DefeatedWarrior/OpenTheatreComms-Beltpack/cad/out/kicad/main_pcb_drawing.png

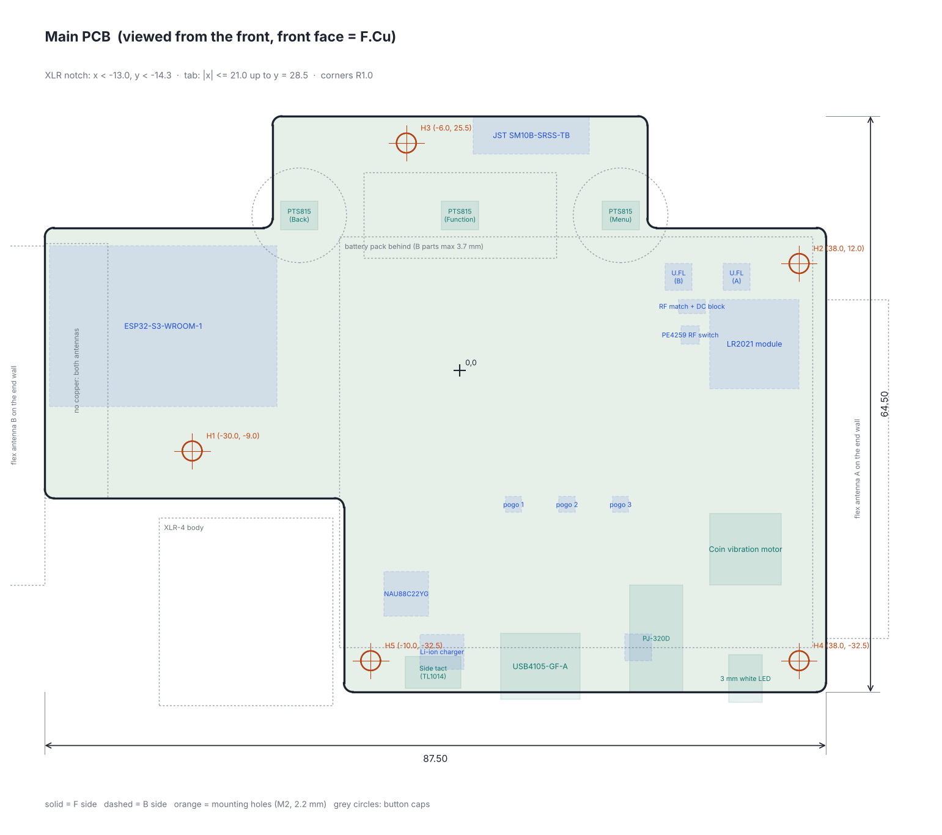
cad/out/kicad/main_pcb_drawing.png
