DefeatedWarrior/OpenTheatreComms-Beltpack/cad/out/kicad/pack_lid_pcb_drawing.png

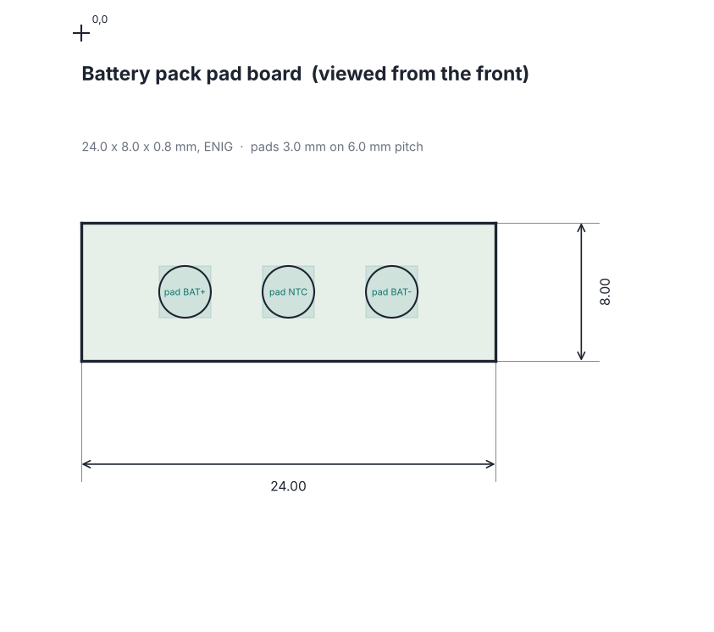
cad/out/kicad/pack_lid_pcb_drawing.png
