DefeatedWarrior/OpenTheatreComms-Beltpack/cad/out/kicad/section_centre.png

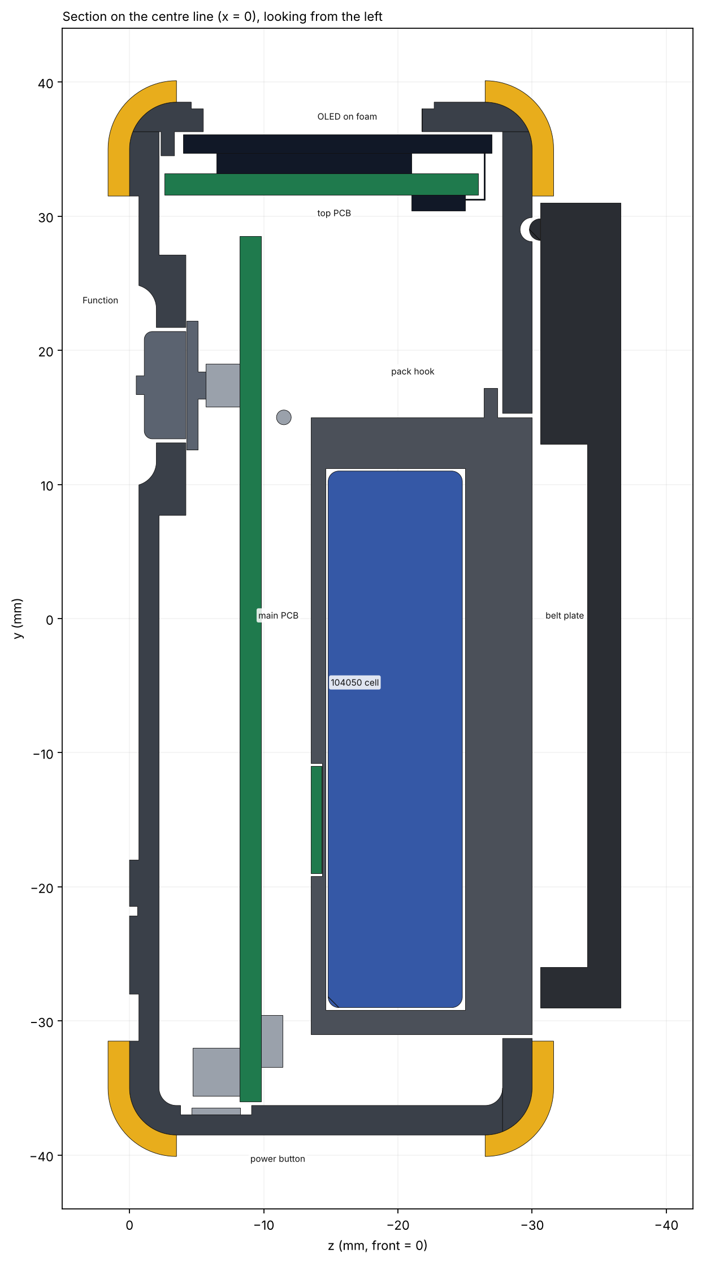
cad/out/kicad/section_centre.png
