DefeatedWarrior/OpenTheatreComms-Beltpack/cad/out/kicad/section_dial.png

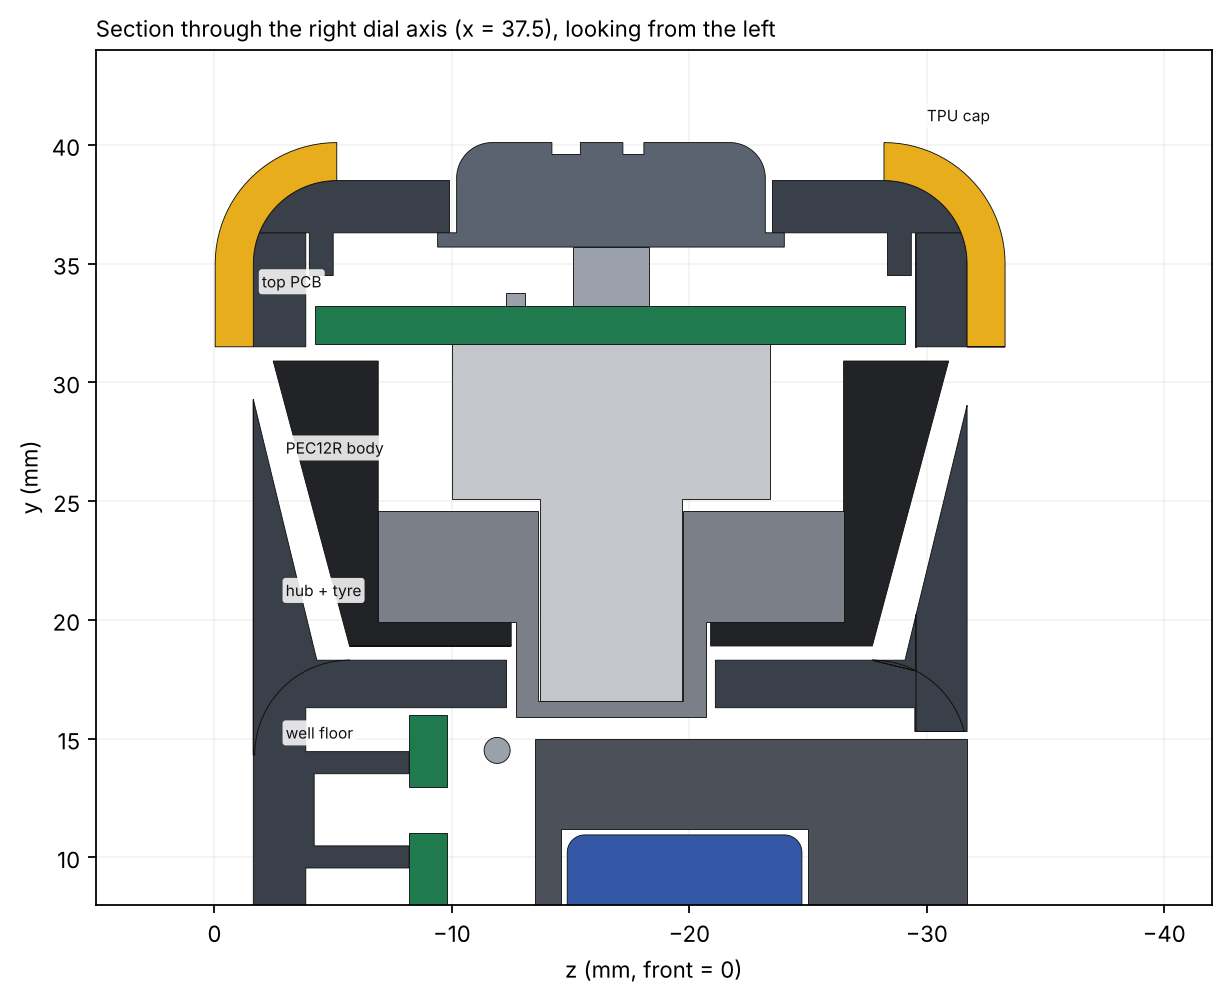
cad/out/kicad/section_dial.png
