DefeatedWarrior/OpenTheatreComms-Beltpack/cad/out/kicad/top_pcb_drawing.png

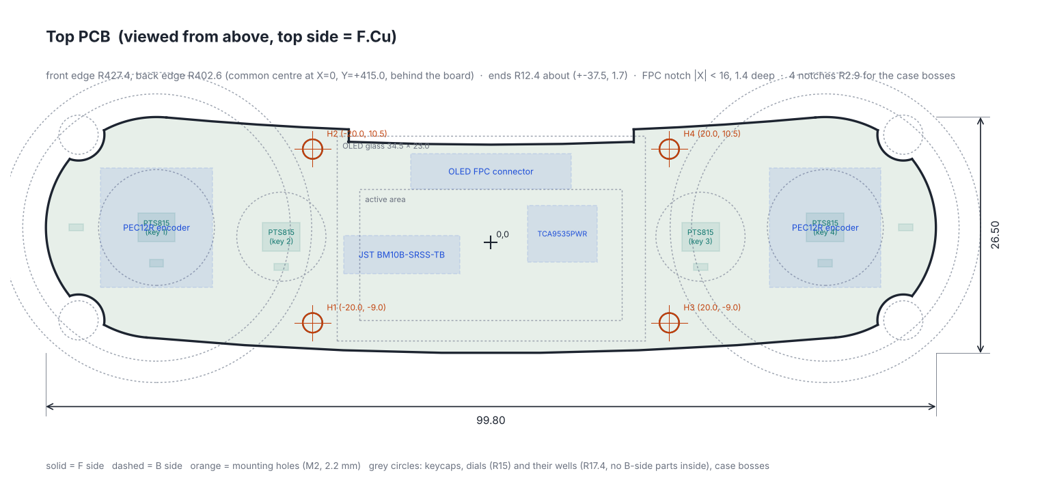
cad/out/kicad/top_pcb_drawing.png
