DefeatedWarrior/OpenTheatreComms-Beltpack/kicad/dock_contact_pcb/fab/dock_contact_pcb_back.png

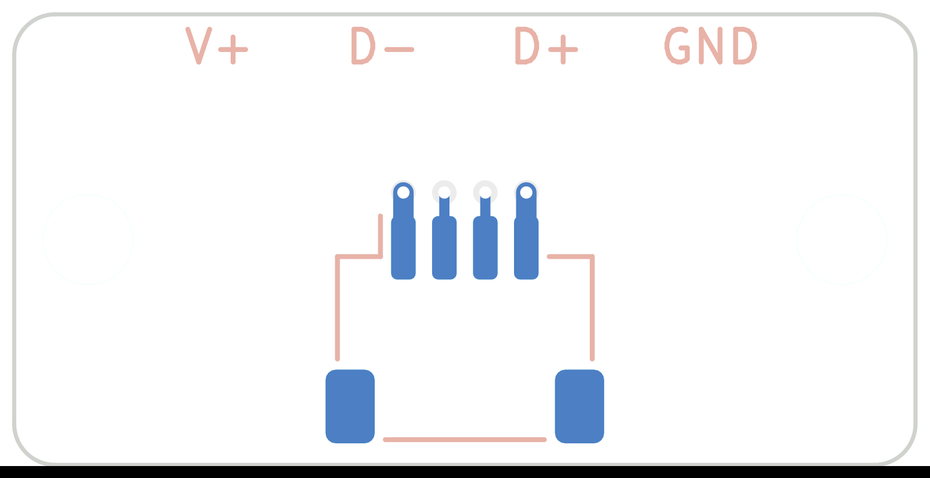
kicad/dock_contact_pcb/fab/dock_contact_pcb_back.png
