DefeatedWarrior/OpenTheatreComms-Beltpack/kicad/top_pcb/fab/top_pcb_preview.png

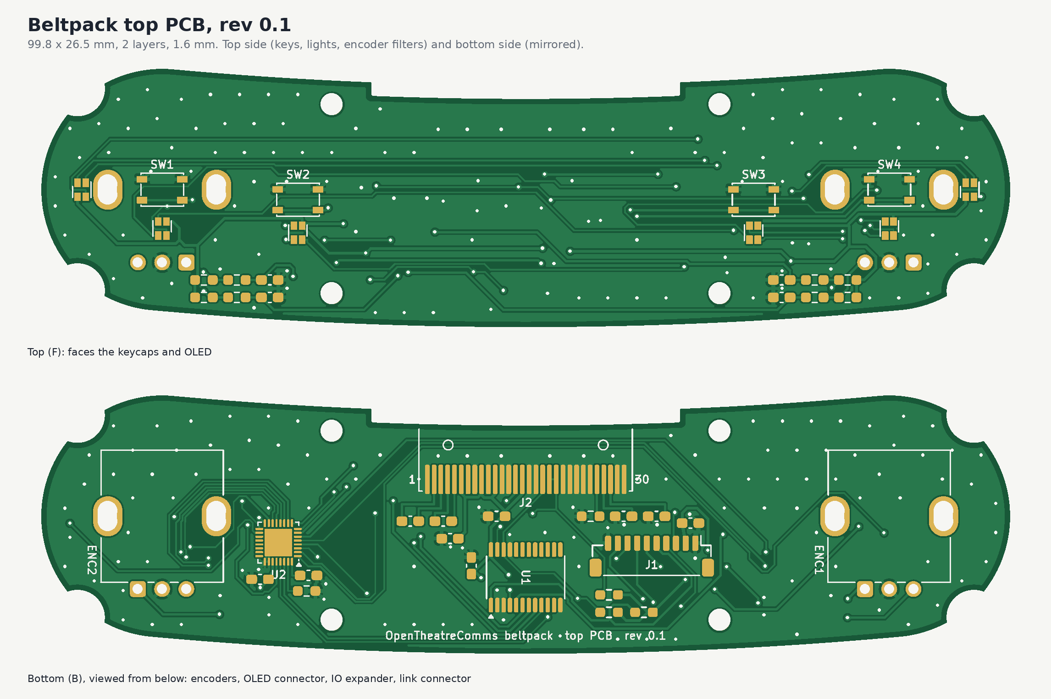
kicad/top_pcb/fab/top_pcb_preview.png
