DefeatedWarrior/OpenTheatreComms-Beltpack/renders/r_back.png

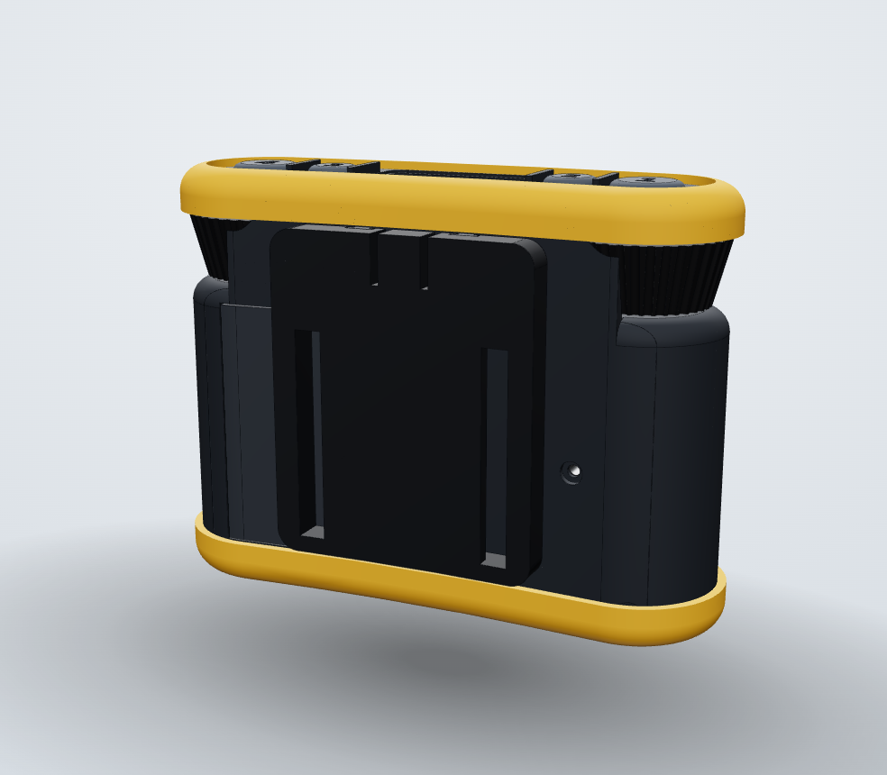
renders/r_back.png
