DefeatedWarrior/OpenTheatreComms-Beltpack/renders/r_bottom.png

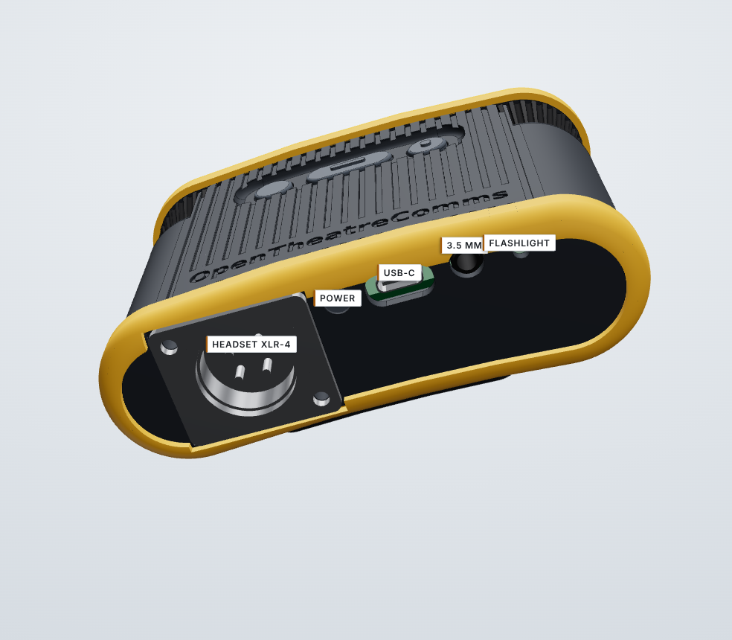
renders/r_bottom.png
