DefeatedWarrior/OpenTheatreComms-Beltpack/renders/r_exploded.png

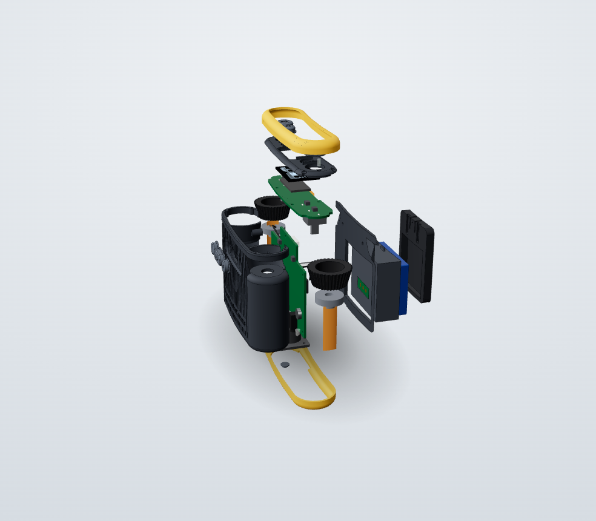
renders/r_exploded.png
