DefeatedWarrior/OpenTheatreComms-Beltpack/renders/r_ghost.png

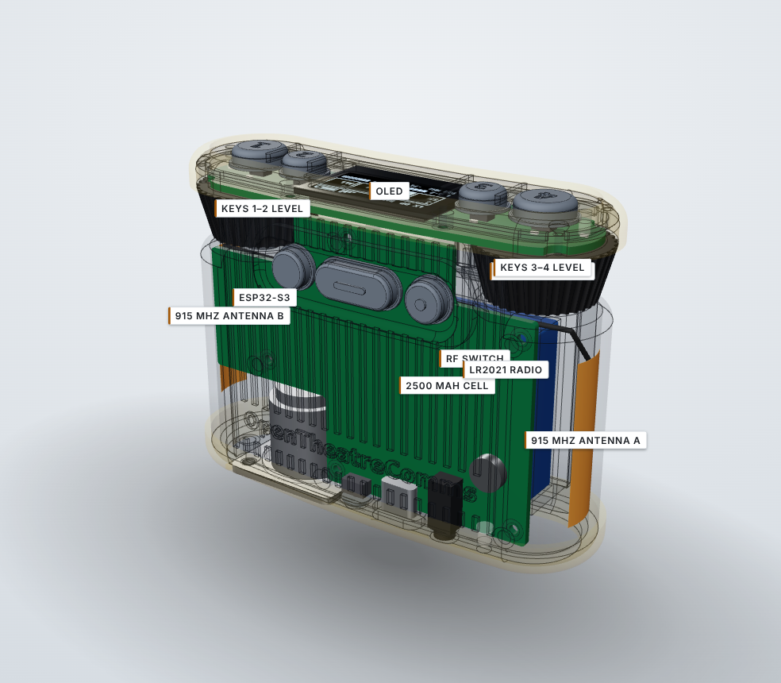
renders/r_ghost.png
