DefeatedWarrior/OpenTheatreComms-Beltpack/renders/r_hero.png

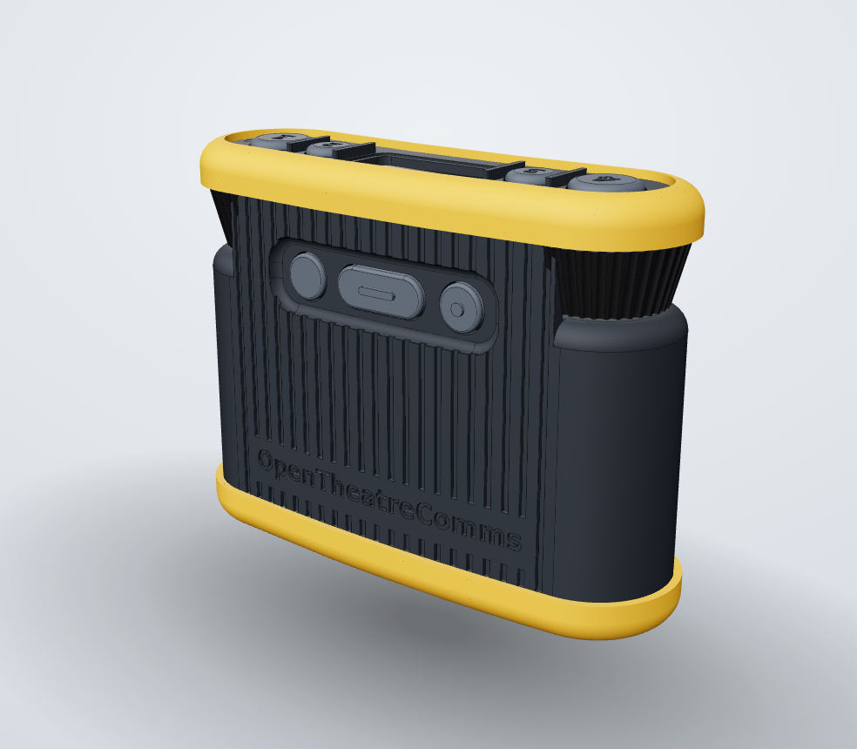
renders/r_hero.png
