DefeatedWarrior/OpenTheatreComms-Beltpack/renders/r_int_back.png

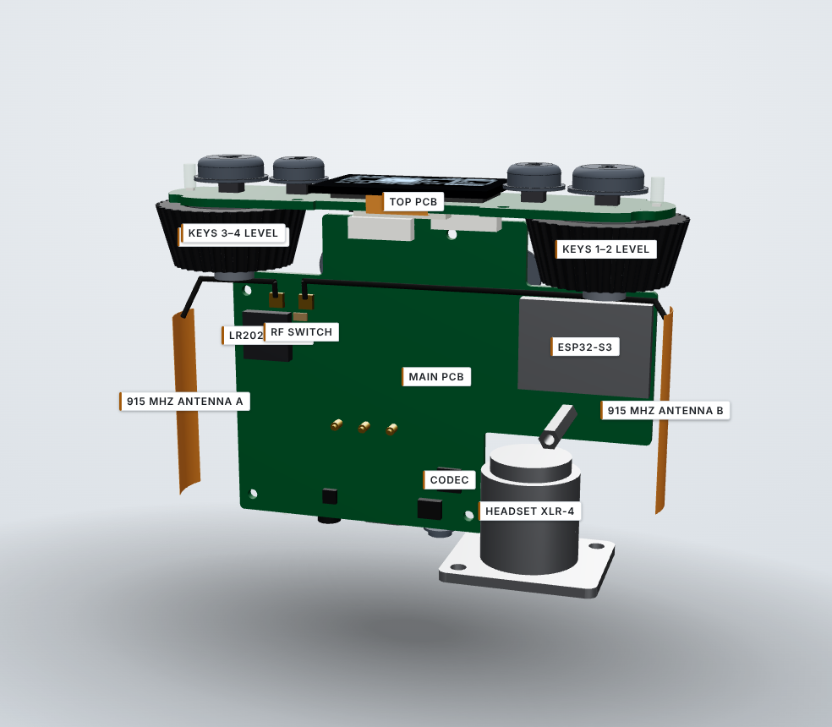
renders/r_int_back.png
