DefeatedWarrior/OpenTheatreComms-Beltpack/renders/r_int_front.png

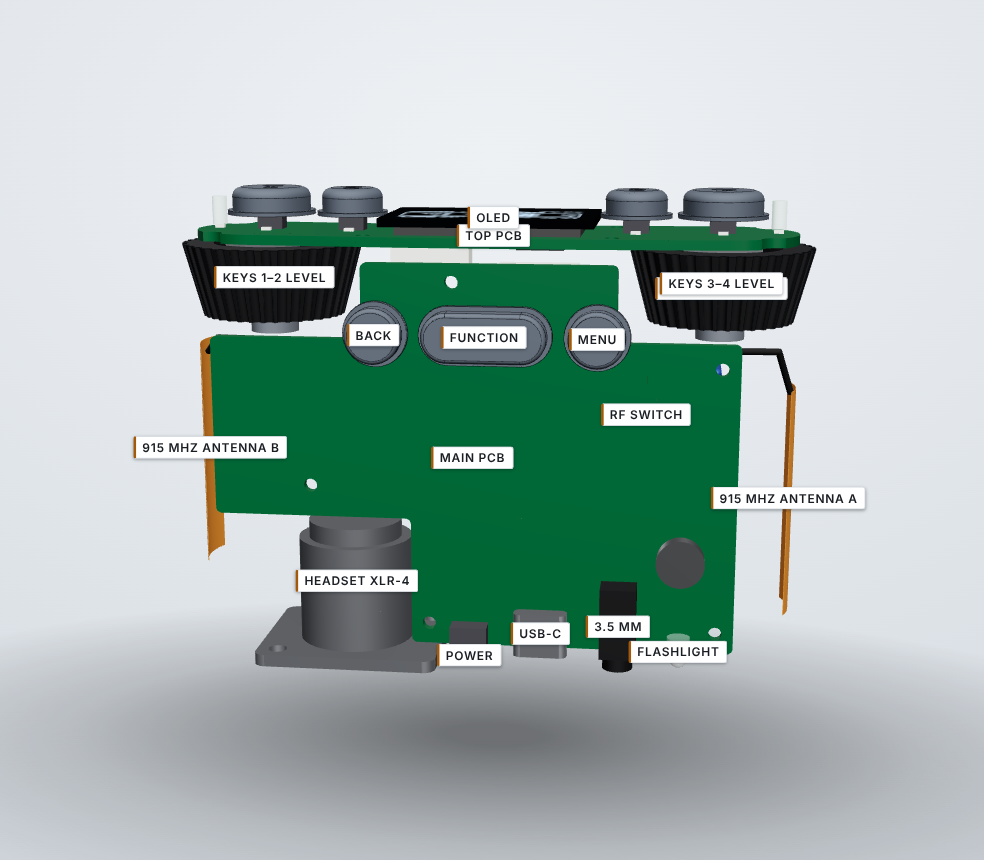
renders/r_int_front.png
