DefeatedWarrior/OpenTheatreComms-Beltpack/renders/r_wearer.png

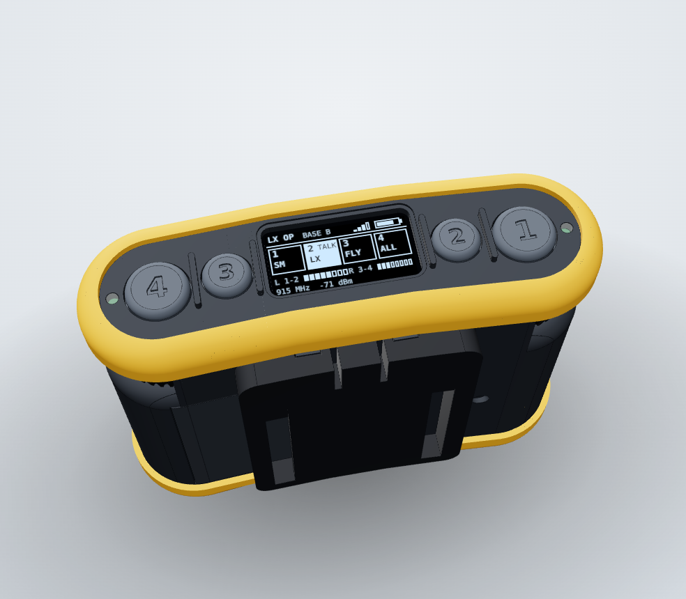
renders/r_wearer.png
