DefeatedWarrior/OpenTheatreComms-Beltpack/kicad/top_pcb/fab/top_pcb_bom.csv

Qty | References | Value | Footprint | Part | Side | Notes
1 | C1 | 100n | C_0603_1608Metric_Pad1.08x0.95mm_HandSolder | 0603 X7R 50 V | bottom | U1 decoupling
4 | C2 C3 C13 C14 | 1u | C_0603_1608Metric_Pad1.08x0.95mm_HandSolder | 0603 X5R | bottom
2 | C4 C5 | 4.7u | C_0603_1608Metric_Pad1.08x0.95mm_HandSolder | 0603 X5R 25 V | bottom
1 | C6 | 4.7u | C_0603_1608Metric_Pad1.08x0.95mm_HandSolder | 0603 X5R 10 V | bottom | Charge-pump supply (VBAT pin)
1 | C7 | 1u | C_0603_1608Metric_Pad1.08x0.95mm_HandSolder | 0603 X5R 10 V | bottom | Logic supply (VDD pin)
4 | C8 C9 C10 C11 | 10n | C_0603_1608Metric_Pad1.08x0.95mm_HandSolder | 0603 X7R 50 V | top
1 | C12 | 10u | C_0603_1608Metric_Pad1.08x0.95mm_HandSolder | 0603 X5R 10 V | bottom | Bulk at the link connector, wired straight to its pins 1 and 2
6 | D1 D2 D3 D4 D5 D6 | RGB | LED_LiteOn_LTST-C19HE1WT | Lite-On LTST-C19HE1WT | top
2 | ENC1 ENC2 | PEC12R | RotaryEncoder_Bourns_Vertical_PEC12R-3x17F-Nxxxx | Alps EC11N1520402 | bottom
1 | J1 | Main PCB link | JST_SH_BM10B-SRSS-TB_1x10-1MP_P1.00mm_Vertical | JST BM10B-SRSS-TB | bottom | JST SH 10-way top entry; 50 mm cable to SM10B on the main PCB tab
1 | J2 | OLED tail | OLED_Tail_30P_0.7mm_Solder | OLED panel tail soldered to pads (no part) | bottom | Solder pads for the panel's 30-lead tail (0.7 mm pitch). Standard 1.3 in SH1106 30-pin pin map; I2C (BS2..0 = 010), address 0x3D (SA0 = D/C# high: 0x3C is the LP5024 broadcast)
1 | R1 | 15k | R_0603_1608Metric_Pad0.98x0.95mm_HandSolder | 0603 1% | bottom | LP5024 full-scale current, 4.9 mA
9 | R9 R13 R14 R15 R16 R17 R18 R19 R20 | 10k | R_0603_1608Metric_Pad0.98x0.95mm_HandSolder | 0603 1% | bottom/top
2 | R10 R11 | 4.7k | R_0603_1608Metric_Pad0.98x0.95mm_HandSolder | 0603 1% | bottom
1 | R12 | 560k | R_0603_1608Metric_Pad0.98x0.95mm_HandSolder | 0603 1% | bottom | Segment current reference: 560k per the panel reference circuit (12.5 uA max)
4 | SW1 SW2 SW3 SW4 | PTS815 | SW_SPST_PTS810 | C&K PTS815 SJM 250 SMTR LFS | top
1 | U1 | TCA9555PWR | TSSOP-24_4.4x7.8mm_P0.65mm | TI TCA9555PWR | bottom | 16-bit I2C IO expander, 0x20, internal 100k pull-ups
1 | U2 | LP5024RSMR | VQFN-32-1EP_4x4mm_P0.4mm_EP2.8x2.8mm | TI LP5024RSMR | bottom | 24-channel I2C RGB LED driver, 0x28: six RGB LEDs; EN from the expander (P05, high by its pull-up at power-up)
