DefeatedWarrior/OpenTheatreComms-Beltpack/kicad/base_pcb/fab/base_pcb_bom.csv

Qty | References | Value | Footprint | Part | Side | Notes
1 | C1 | 10u | C_1206_3216Metric_Pad1.33x1.80mm_HandSolder | 1206 X7R 50 V | top
17 | C2 C11 C15 C19 C25 C26 C27 C28 C29 C30 C31 C32 C33 C34 C35 C36 C37 | 100n | C_0603_1608Metric_Pad1.08x0.95mm_HandSolder | 0603 X7R | top
4 | C3 C4 C5 C8 | 22u | C_1206_3216Metric_Pad1.33x1.80mm_HandSolder | 1206 X5R 10 V | top
1 | C6 | 1u | C_0603_1608Metric_Pad1.08x0.95mm_HandSolder | 0603 X5R 10 V | top
3 | C7 C10 C20 | 10u | C_0603_1608Metric_Pad1.08x0.95mm_HandSolder | 0603 X5R 10 V | top
1 | C9 | 47u | C_1206_3216Metric_Pad1.33x1.80mm_HandSolder | 1206 X5R 6.3 V | top | Module bulk (guide: 47u + 10u + 100n)
0 | C12 C13 C18 C41 C42 C50 C51 | DNP DNP | C_0603_1608Metric_Pad1.08x0.95mm_HandSolder | 0603 C0G, tune | top | Not fitted.
3 | C14 C16 C17 | 100p | C_0603_1608Metric_Pad1.08x0.95mm_HandSolder | 0603 C0G 50 V | top
2 | C21 C22 | 10n | C_0603_1608Metric_Pad1.08x0.95mm_HandSolder | 0603 X7R | top
0 | C38 C47 | DNP 47u | C_1206_3216Metric_Pad1.33x1.80mm_HandSolder | 1206 X5R 6.3 V | top | Not fitted.
0 | C39 C48 | DNP 10u | C_0603_1608Metric_Pad1.08x0.95mm_HandSolder | 0603 X5R 10 V | top | Not fitted.
0 | C40 C49 | DNP 100n | C_0603_1608Metric_Pad1.08x0.95mm_HandSolder | 0603 X7R | top | Not fitted.
0 | C43 C52 | DNP 100p | C_0603_1608Metric_Pad1.08x0.95mm_HandSolder | 0603 C0G 50 V | top | Not fitted.
2 | D1 D2 | SS34 | D_SMA | SS34 (SMA) | top
1 | D3 | SMAJ26A | D_SMA | SMAJ26A | top | Input surge clamp
1 | D4 | green | LED_0603_1608Metric_Pad1.05x0.95mm_HandSolder | Lite-On LTST-C191KGKT | top | Power light
1 | ENC1 | EC11 | RotaryEncoder_Alps_EC11E-Switch_Vertical_H20mm | EC11 encoder with push switch, 20 mm shaft | top | Menu dial
1 | FB1 | 0R | L_0603_1608Metric_Pad1.05x0.95mm_HandSolder | 0603 0R (or Murata BLM18PG121SN1D) | top | Radio supply link: the module has its own ferrite
0 | FB2 FB3 | DNP 0R | L_0603_1608Metric_Pad1.05x0.95mm_HandSolder | 0603 0R (or Murata BLM18PG121SN1D) | top | Not fitted.
1 | J1 | DC 7-24 V | BarrelJack_CUI_PJ-063AH_Horizontal | CUI PJ-063AH (5.5 x 2.1 mm, centre +) | top | DC input, 7-24 V, centre positive. Optional: the NANO's USB-C or a PoE module also powers the station
1 | J2 | Antenna A | SMA_Molex_73251-2120_EdgeMount_Horizontal | Molex 73251-2120 SMA edge-mount jack, 1.6 mm board | top | Antenna A (915 MHz whip)
1 | J3 | Antenna B | SMA_Molex_73251-2120_EdgeMount_Horizontal | Molex 73251-2120 SMA edge-mount jack, 1.6 mm board | top | Antenna B (915 MHz whip)
0 | J4 | DNP 2.4 GHz | U.FL_Hirose_U.FL-R-SMT-1_Vertical | Hirose U.FL-R-SMT-1(10) | top | Not fitted. 2.4 GHz fallback antenna: footprint only in v1
1 | J5 | OLED | PinSocket_1x04_P2.54mm_Vertical | 1x4 female socket for a 1.3 in 128x64 I2C OLED module (SH1106, address 0x3C) | top | OLED module socket: GND, VCC, SCL, SDA (check your module's pin order)
0 | J6 | DNP Radio 2 antenna | SMA_Molex_73251-2120_EdgeMount_Horizontal | Molex 73251-2120 SMA edge-mount jack, 1.6 mm board | top | Not fitted. Radio 2 antenna (915 MHz whip)
0 | J7 | DNP Radio 3 antenna | SMA_Molex_73251-2120_EdgeMount_Horizontal | Molex 73251-2120 SMA edge-mount jack, 1.6 mm board | top | Not fitted. Radio 3 antenna (915 MHz whip)
1 | L1 | 4.7u | L_Bourns-SRN4018 | 4.7 uH, 2.5 A, 4x4 mm (Bourns SRN4018-4R7M or equal) | top
1 | L2 | 0 | R_0603_1608Metric_Pad0.98x0.95mm_HandSolder | 0603 0R or RF inductor | top | Pi match series element: 0R until tuned
0 | L3 L4 L6 | DNP 0 | R_0603_1608Metric_Pad0.98x0.95mm_HandSolder | 0603 0R or RF inductor | top | Not fitted.
12 | LED1 LED2 LED3 LED4 LED5 LED6 LED7 LED8 LED9 LED10 LED11 LED12 | WS2812B-Mini | LED_WS2812B-Mini-V3J_3.5x3.5mm | Worldsemi WS2812B-Mini-V3J | top
0 | R1 R2 | DNP 4.7k | R_0603_1608Metric_Pad0.98x0.95mm_HandSolder | 0603 1% | top | Not fitted.
3 | R3 R9 R10 | 1k | R_0603_1608Metric_Pad0.98x0.95mm_HandSolder | 0603 1% | top
4 | R4 R5 R6 R7 | 470 | R_0603_1608Metric_Pad0.98x0.95mm_HandSolder | 0603 1% | top
1 | R8 | 100k | R_0603_1608Metric_Pad0.98x0.95mm_HandSolder | 0603 1% | top
3 | R11 R12 R13 | 10k | R_0603_1608Metric_Pad0.98x0.95mm_HandSolder | 0603 1% | top
1 | R14 | 33 | R_0603_1608Metric_Pad0.98x0.95mm_HandSolder | 0603 1% | top | LED data series resistor
0 | R15 R16 R17 R18 R21 R22 R23 R24 | DNP 470 | R_0603_1608Metric_Pad0.98x0.95mm_HandSolder | 0603 1% | top | Not fitted.
0 | R19 R25 | DNP 100k | R_0603_1608Metric_Pad0.98x0.95mm_HandSolder | 0603 1% | top | Not fitted.
1 | SW1 | Talk 1 | SW_PUSH-12mm | 12 x 12 mm tactile switch with round cap | top | Talk 1 key (channel 1)
1 | SW2 | Talk 2 | SW_PUSH-12mm | 12 x 12 mm tactile switch with round cap | top | Talk 2 key (channel 2)
1 | SW3 | Talk 3 | SW_PUSH-12mm | 12 x 12 mm tactile switch with round cap | top | Talk 3 key (channel 3)
1 | SW4 | Talk 4 | SW_PUSH-12mm | 12 x 12 mm tactile switch with round cap | top | Talk 4 key (channel 4)
1 | SW5 | Menu | SW_PUSH_6mm | 6 x 6 mm tactile switch, 13 mm tall | top | Menu key
1 | SW6 | Back | SW_PUSH_6mm | 6 x 6 mm tactile switch, 13 mm tall | top | Back key
1 | U1 | ESP32-P4-NANO | ESP32-P4-NANO_Sockets | Waveshare ESP32-P4-NANO (SKU 29026) on 2x 2x13 2.54 mm female sockets, 8.5 mm | top | ESP32-P4 board: Ethernet (PoE module option), USB-C, Wi-Fi 6 co-processor. Plugs in RJ45-first toward the rear
1 | U2 | AP63205WU | TSOT-23-6 | Diodes AP63205WU-7 | top | 5 V, 2 A synchronous buck, 3.8-32 V in
1 | U3 | TLV75733 | SOT-23-5 | TI TLV75733PDBVR | top | 3.3 V, 1 A LDO for the radio, codec and expander (separate from the NANO's own 3.3 V)
1 | U4 | LR2021 | LR2021_Elecrow_10x10mm | Elecrow LR2021 module (LMM16121D) | top | 915-928 MHz FLRC radio; 2.4 GHz port for fallback
1 | U5 | PE4259 | SOT-363_SC-70-6 | pSemi PE4259-63 | top | Antenna diversity switch, RF1 = antenna A when CTRL is high
1 | U6 | TCA9555PWR | TSSOP-24_4.4x7.8mm_P0.65mm | TI TCA9555PWR | top | IO expander at 0x21 (A0 high): keys, encoder push, antenna switch, radios' DIO5, TX/RX enable and radios 2-3 reset
1 | U7 | 74AHCT1G125 | SOT-23-5 | 74AHCT1G125 (SOT-23-5) | top | 3.3 V to 5 V level shift for the LED data line
0 | U10 U11 | DNP LR2021 | LR2021_Elecrow_10x10mm | Elecrow LR2021 module (LMM16121D) | top | Not fitted.
