DefeatedWarrior/OpenTheatreComms-Beltpack/order/JLC order/Beltpack dock contacts/dock_contact_pcb_hand_fit.csv

Designator | Value | Part | LCSC Part # | Side | Other supplier | Note
J5 | To main J12 | JST SM04B-SRSS-TB(LF)(SN) | C160404 | bottom |  | Dock socket on the main board (J12)
