DefeatedWarrior/OpenTheatreComms-Beltpack/cad/out/kicad/main_pcb.dxf

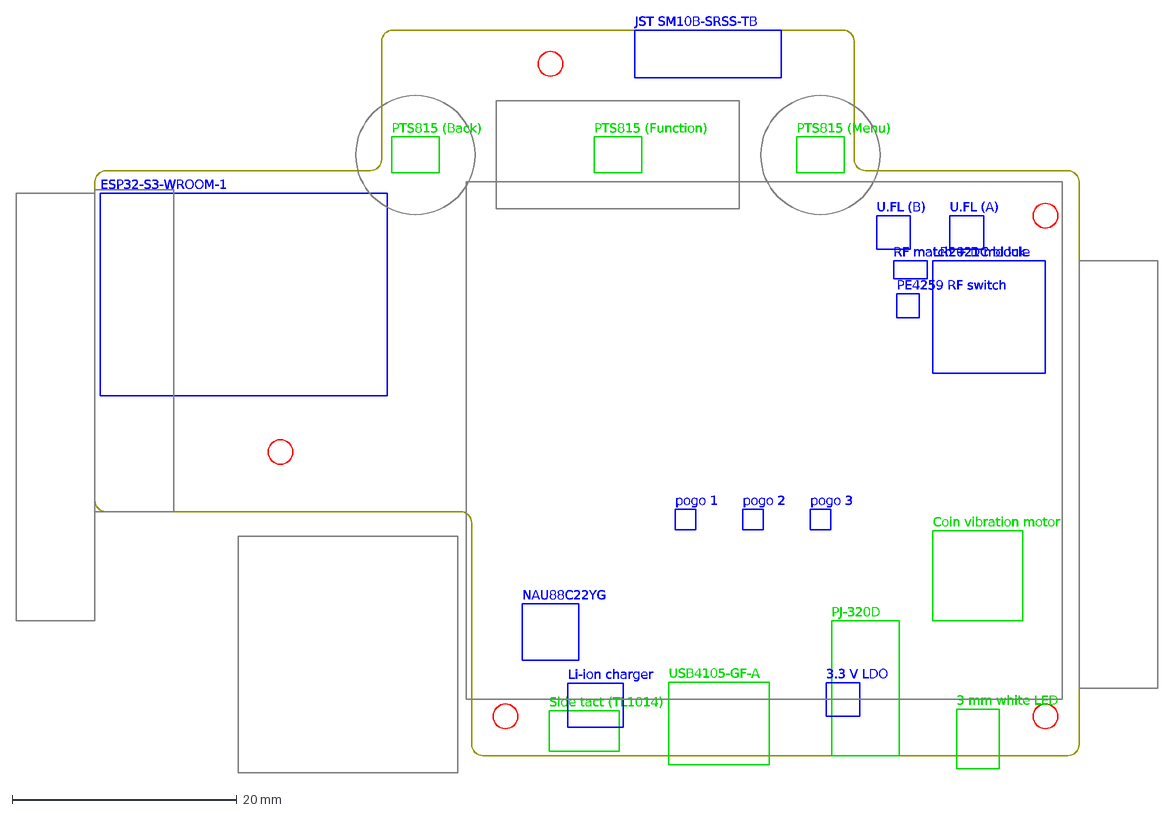
[picture p22: CAD file, 2026-10-25]
cad/out/kicad/main_pcb.dxf
PTS815 (Back)
PTS815 (Function)
PTS815 (Menu)
USB4105-GF-A
PJ-320D
Side tact (TL1014)
3 mm white LED
Coin vibration motor
ESP32-S3-WROOM-1
LR2021 module
U.FL (A)
U.FL (B)
PE4259 RF switch
RF match + DC block
NAU88C22YG
Li-ion charger
3.3 V LDO
JST SM10B-SRSS-TB
pogo 1
pogo 2
pogo 3
