DefeatedWarrior/OpenTheatreComms-Beltpack/cad/out/kicad/main_pcb_edge_cuts.dxf

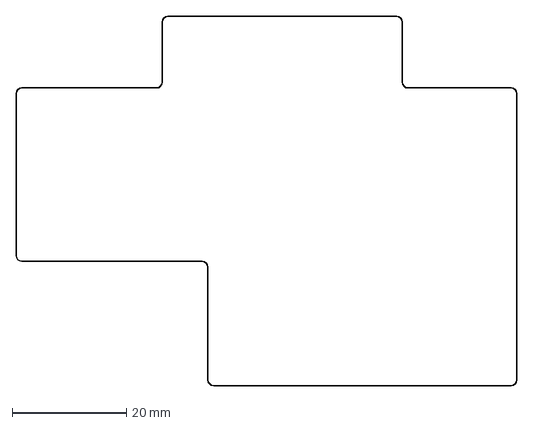
[picture p23: CAD file, 2026-10-25]
cad/out/kicad/main_pcb_edge_cuts.dxf
87.5 x 64.5 mm
