DefeatedWarrior/OpenTheatreComms-Beltpack/cad/out/beltpack_final.step

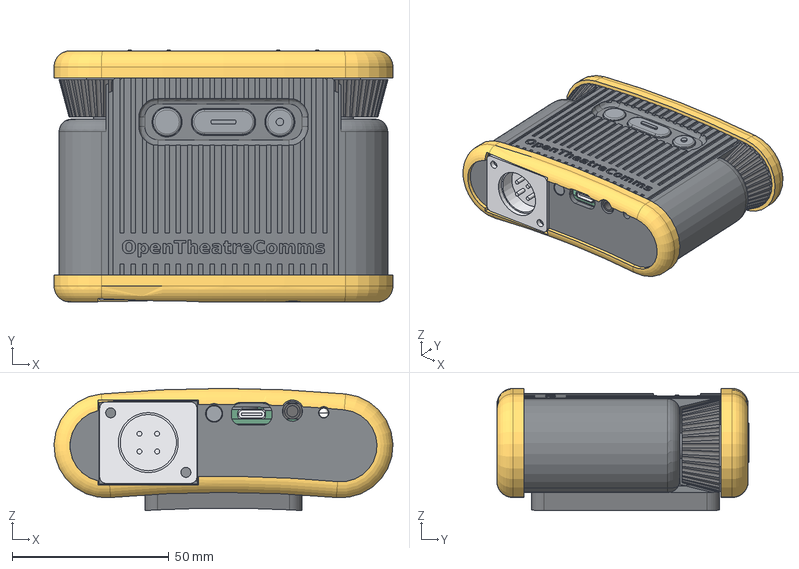
[picture p24: CAD file, 2026-10-25]
cad/out/beltpack_final.step
108.2 x 80.5 x 39.0 mm
front_shell
back_shell
top_plate
tpu_top
tpu_bottom
knob_left
hub_left
knob_right
hub_right
keycap_1
keycap_2
keycap_3
keycap_4
front_back
front_function
front_menu
power_plunger
status_pipe_L
status_pipe_R
top_pcb
sw_key1
led_key1
sw_key2
led_key2
sw_key3
led_key3
sw_key4
led_key4
led_status_L
led_status_R
oled_zif
jst_top
io_exp
enc_left
enc_right
oled_glass
oled_spacer
oled_fpc
main_pcb
sw_back
sw_function
sw_menu
usb_c
trrs
sw_power
lamp_led
vib_motor
esp32s3
lr2021
ufl
ufl_b
rf_switch
rf_match
codec
charger
ldo
jst_main
pogo_1
pogo_2
pogo_3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
