DefeatedWarrior/OpenTheatreComms-Beltpack/cad/out/kicad/top_pcb_edge_cuts.dxf

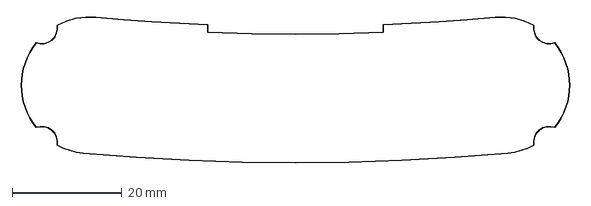
[picture p25: CAD file, 2026-10-25]
cad/out/kicad/top_pcb_edge_cuts.dxf
101.6 x 27.2 mm
