DefeatedWarrior/OpenTheatreComms-Beltpack/cad/out/stl/knob_right.stl

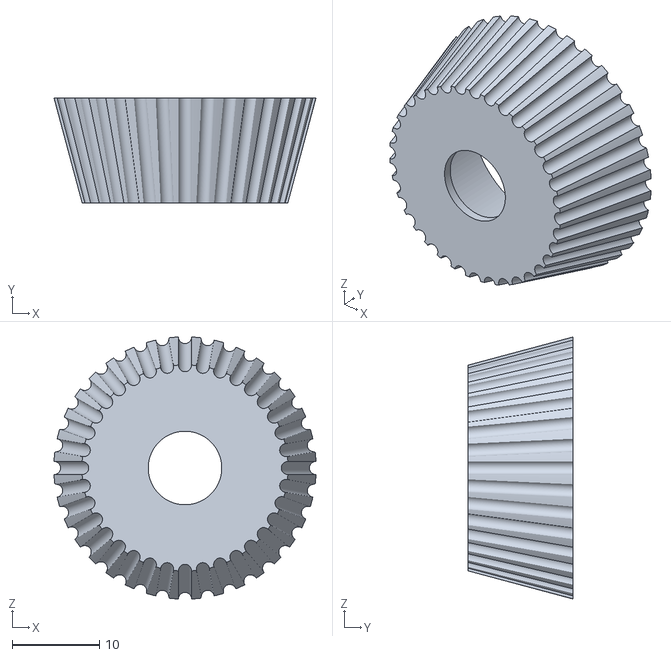
[picture p26: CAD file, 2026-10-25]
cad/out/stl/knob_right.stl
30.0 x 12.0 x 30.0
