DefeatedWarrior/OpenTheatreComms-Beltpack/kicad/3d/enclosure_ref.step

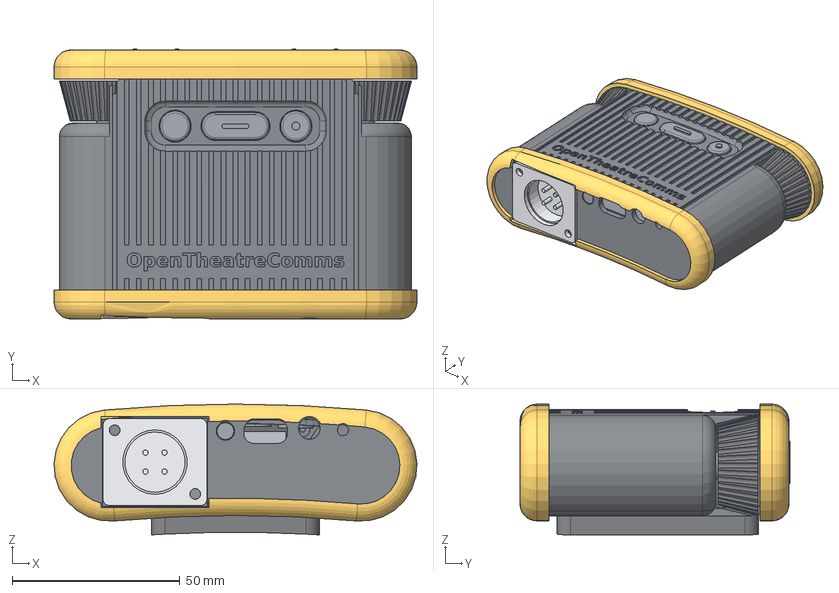
[picture p27: CAD file, 2026-10-25]
kicad/3d/enclosure_ref.step
108.2 x 80.5 x 39.0 mm
front_shell
back_shell
top_plate
tpu_top
tpu_bottom
knob_left
hub_left
knob_right
hub_right
keycap_1
keycap_2
keycap_3
keycap_4
front_back
front_function
front_menu
power_plunger
status_pipe_L
status_pipe_R
oled_glass
oled_spacer
oled_fpc
rf_switch
rf_match
standoff_H1
xlr4
battery_pack
cell
antenna
antenna_b
coax
coax_b
belt_plate
