DefeatedWarrior/OpenTheatreComms-Beltpack/cad/out/stl/battery_pack.stl

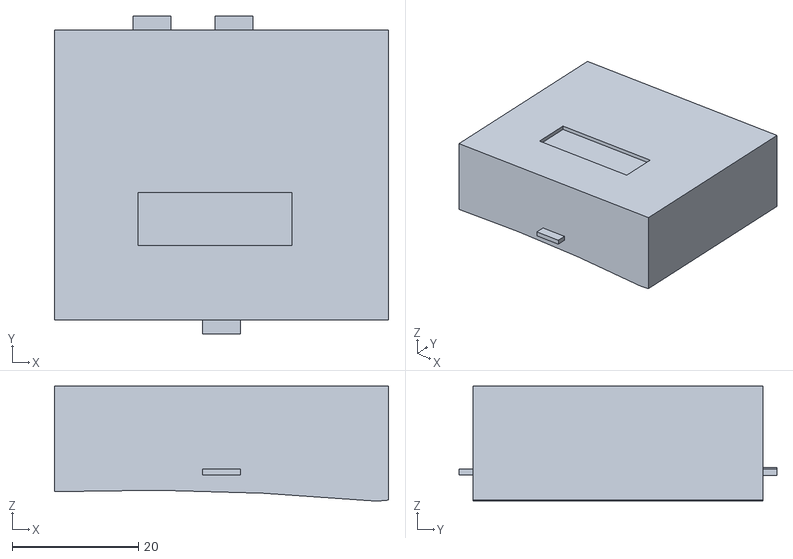
[picture p28: CAD file, 2026-10-25]
cad/out/stl/battery_pack.stl
53.0 x 50.4 x 18.2
