DefeatedWarrior/OpenTheatreComms-Beltpack/cad/out/kicad/pack_lid_pcb_edge_cuts.dxf

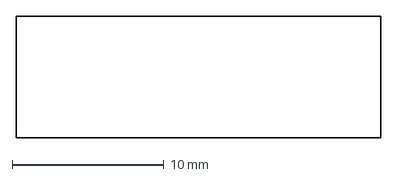
[picture p29: CAD file, 2026-10-25]
cad/out/kicad/pack_lid_pcb_edge_cuts.dxf
24.0 x 8.00 mm
