DefeatedWarrior/OpenTheatreComms-Beltpack/cad/out/stl/hub_right.stl

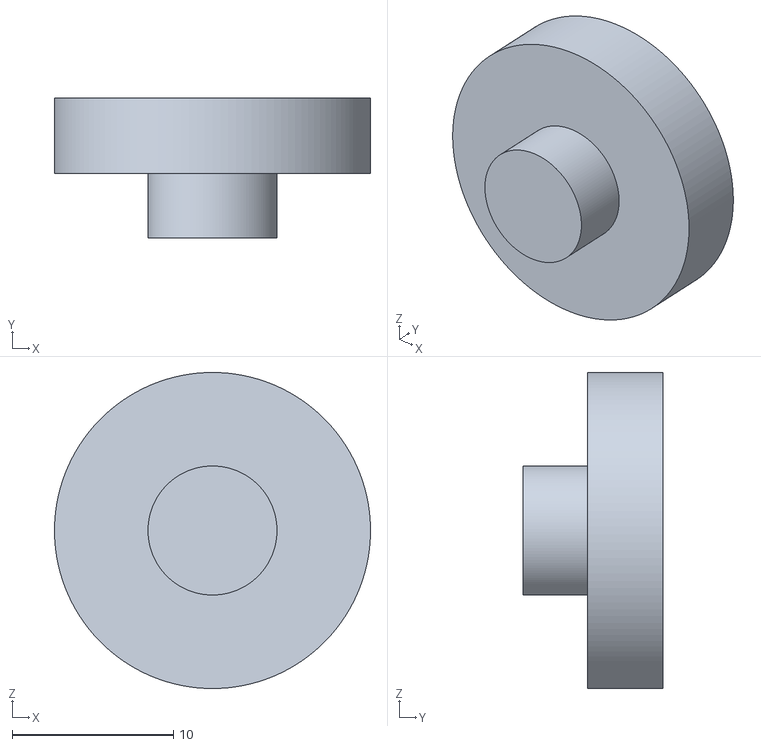
[picture p30: CAD file, 2026-10-25]
cad/out/stl/hub_right.stl
19.6 x 8.70 x 19.6
