DefeatedWarrior/OpenTheatreComms-Beltpack/cad/out/kicad/pack_lid_pcb.dxf

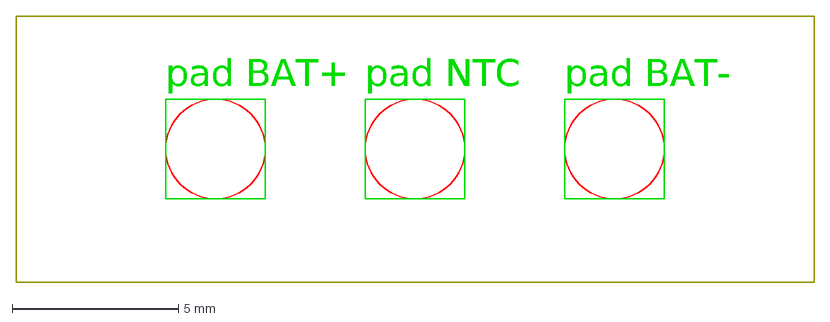
[picture p31: CAD file, 2026-10-25]
cad/out/kicad/pack_lid_pcb.dxf
pad BAT+
pad NTC
pad BAT-
