DefeatedWarrior/OpenTheatreComms-Beltpack/cad/out/stl/front_shell.stl

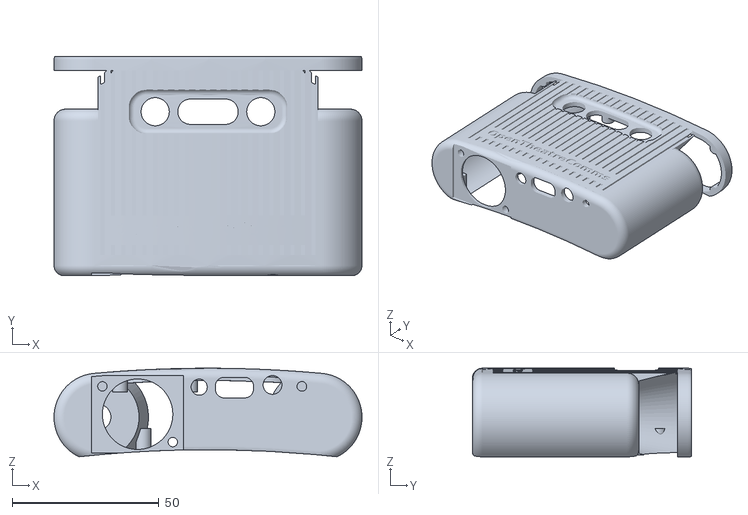
[picture p32: CAD file, 2026-10-25]
cad/out/stl/front_shell.stl
105.0 x 74.8 x 30.2
