DefeatedWarrior/OpenTheatreComms-Beltpack/cad/out/kicad/top_pcb.dxf

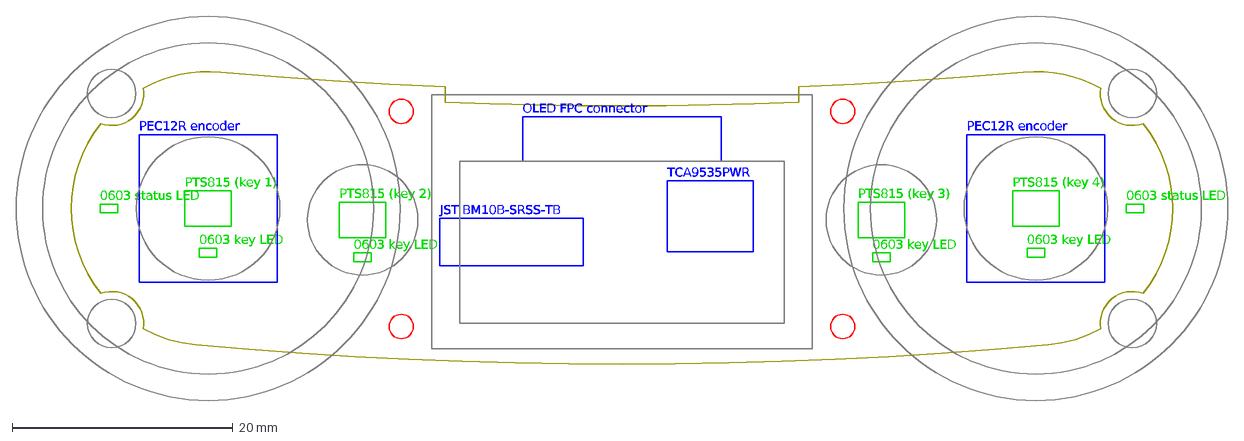
[picture p33: CAD file, 2026-10-25]
cad/out/kicad/top_pcb.dxf
PTS815 (key 1)
0603 key LED
PTS815 (key 2)
PTS815 (key 3)
PTS815 (key 4)
0603 status LED
OLED FPC connector
JST BM10B-SRSS-TB
TCA9535PWR
PEC12R encoder
