DefeatedWarrior/OpenTheatreComms-Beltpack/cad/out/stl/keycap_1.stl

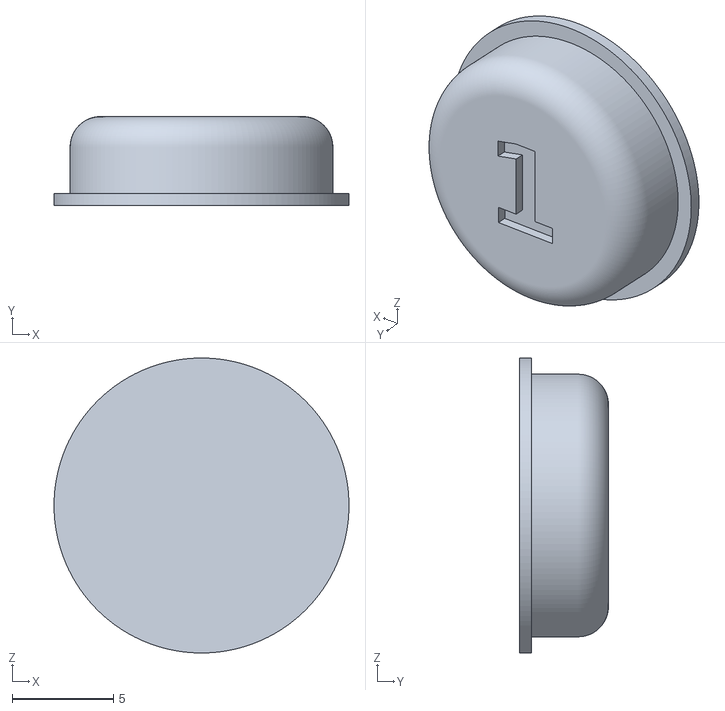
[picture p34: CAD file, 2026-10-25]
cad/out/stl/keycap_1.stl
14.6 x 4.40 x 14.6
