DefeatedWarrior/OpenTheatreComms-Beltpack/cad/out/stl/front_back.stl

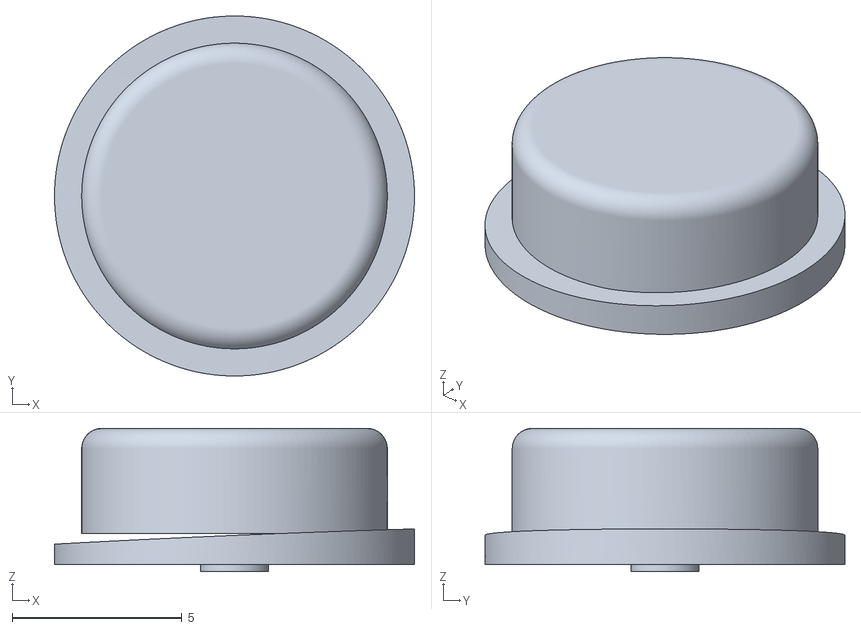
[picture p35: CAD file, 2026-10-25]
cad/out/stl/front_back.stl
10.6 x 10.6 x 4.22
