DefeatedWarrior/OpenTheatreComms-Beltpack/cad/out/stl/power_plunger.stl

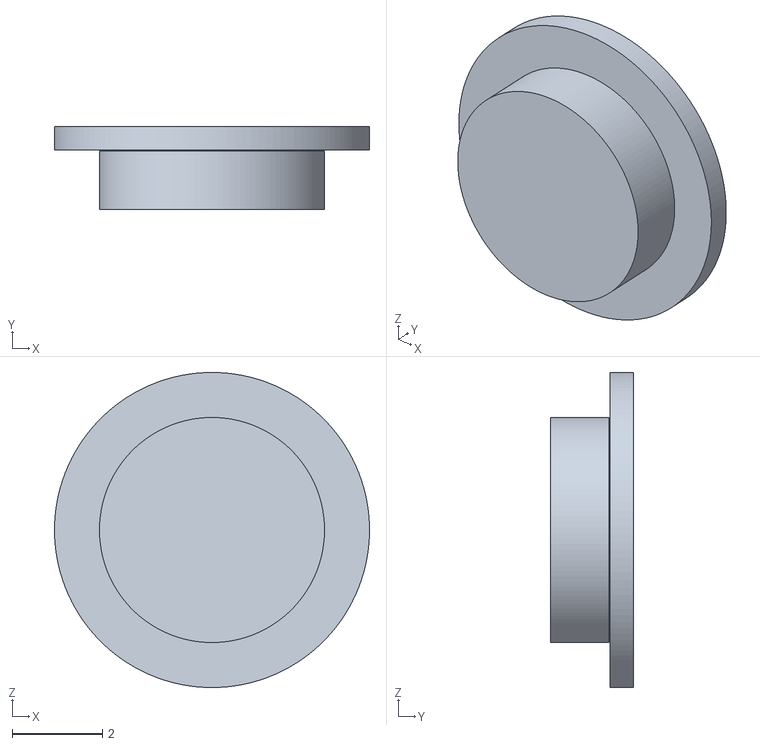
[picture p36: CAD file, 2026-10-25]
cad/out/stl/power_plunger.stl
7.00 x 1.85 x 7.00
