DefeatedWarrior/OpenTheatreComms-Beltpack/cad/out/stl/tpu_bottom.stl

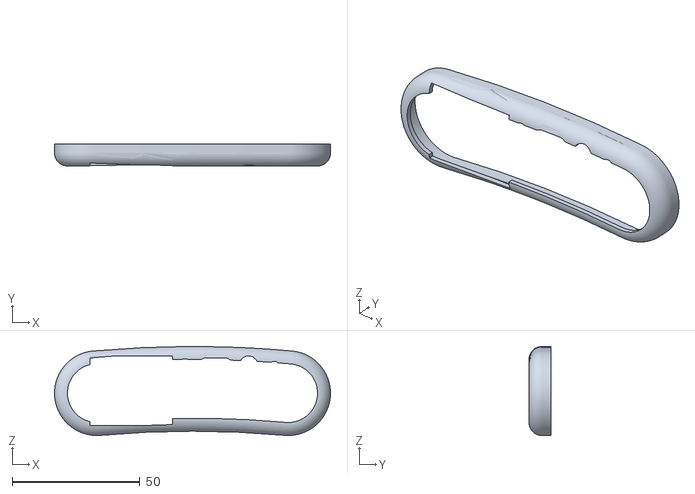
[picture p37: CAD file, 2026-10-25]
cad/out/stl/tpu_bottom.stl
108.2 x 8.60 x 34.9
