DefeatedWarrior/OpenTheatreComms-Beltpack/cad/out/stl/belt_plate.stl

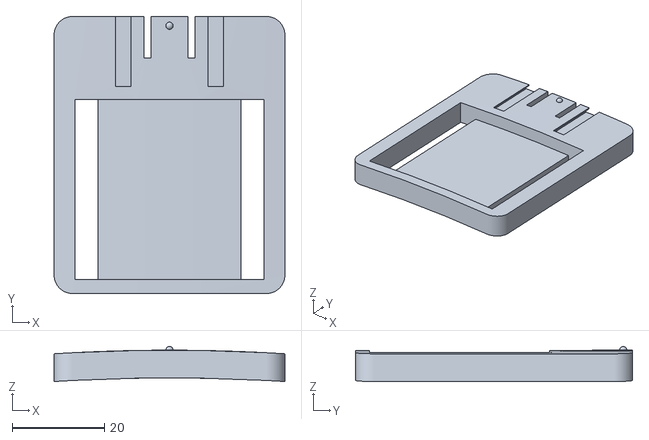
[picture p38: CAD file, 2026-10-25]
cad/out/stl/belt_plate.stl
50.0 x 60.0 x 7.60
