DefeatedWarrior/OpenTheatreComms-Beltpack/cad/out/stl/keycap_2.stl

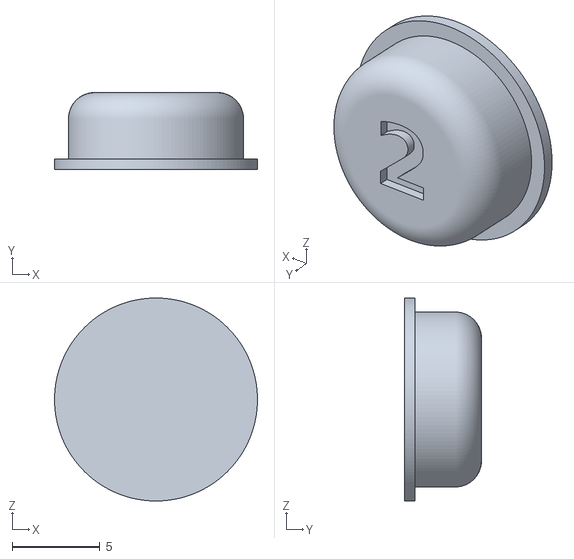
[picture p39: CAD file, 2026-10-25]
cad/out/stl/keycap_2.stl
11.6 x 4.40 x 11.6
