DefeatedWarrior/OpenTheatreComms-Beltpack/cad/out/stl/tpu_top.stl

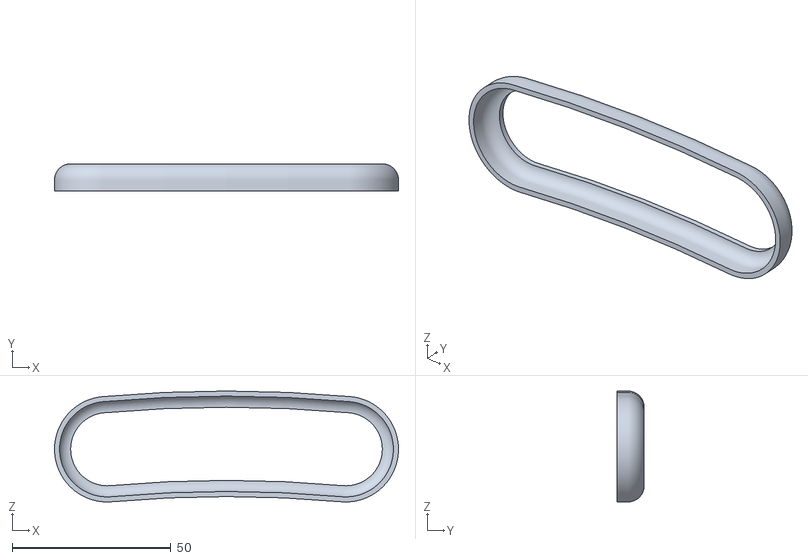
[picture p40: CAD file, 2026-10-25]
cad/out/stl/tpu_top.stl
108.2 x 8.60 x 34.9
