DefeatedWarrior/OpenTheatreComms-Beltpack/cad/out/stl/top_plate.stl

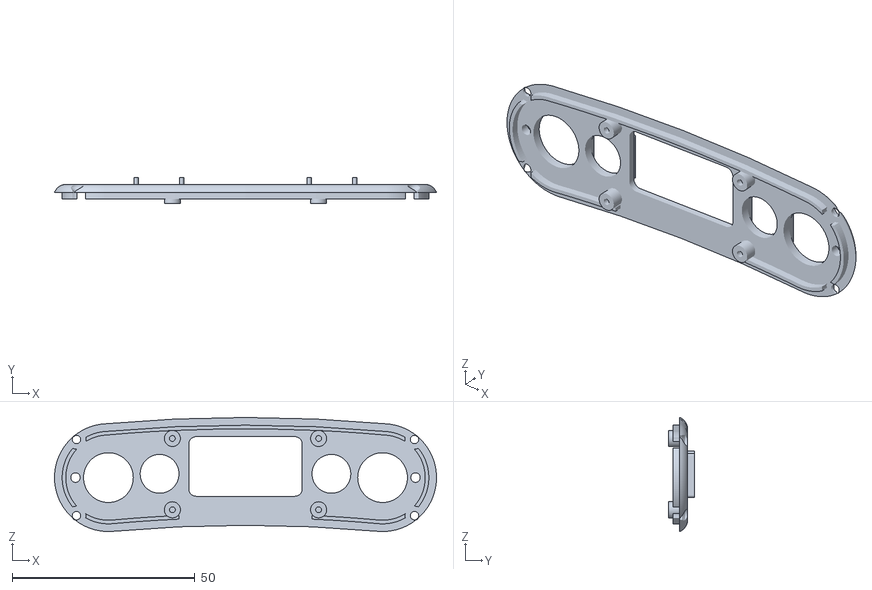
[picture p41: CAD file, 2026-10-25]
cad/out/stl/top_plate.stl
104.5 x 7.20 x 31.2
