DefeatedWarrior/OpenTheatreComms-Beltpack/cad/out/stl/front_menu.stl

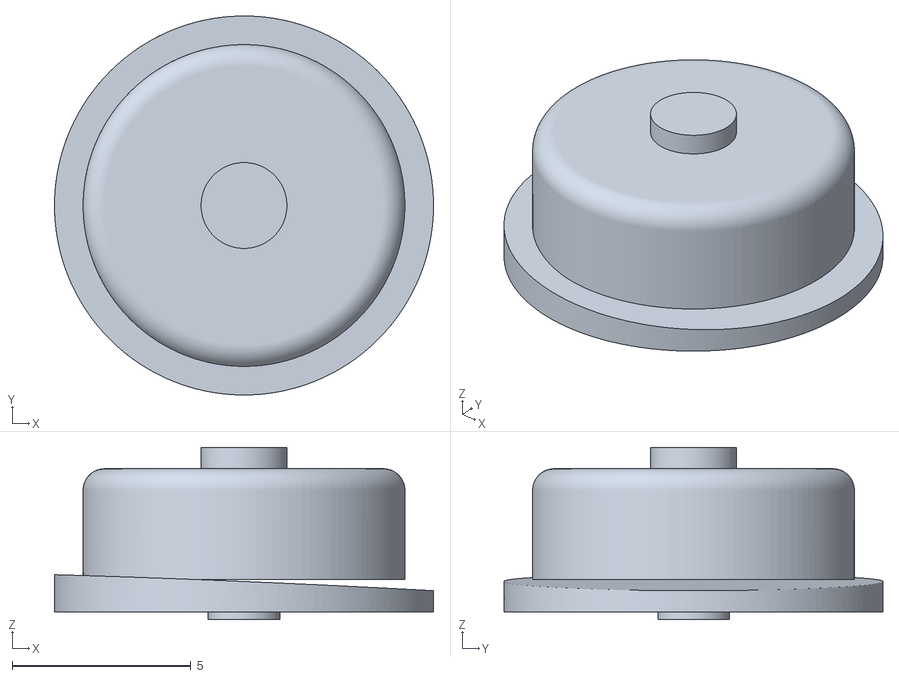
[picture p42: CAD file, 2026-10-25]
cad/out/stl/front_menu.stl
10.6 x 10.6 x 4.82
