DefeatedWarrior/OpenTheatreComms-Beltpack/cad/out/stl/back_shell.stl

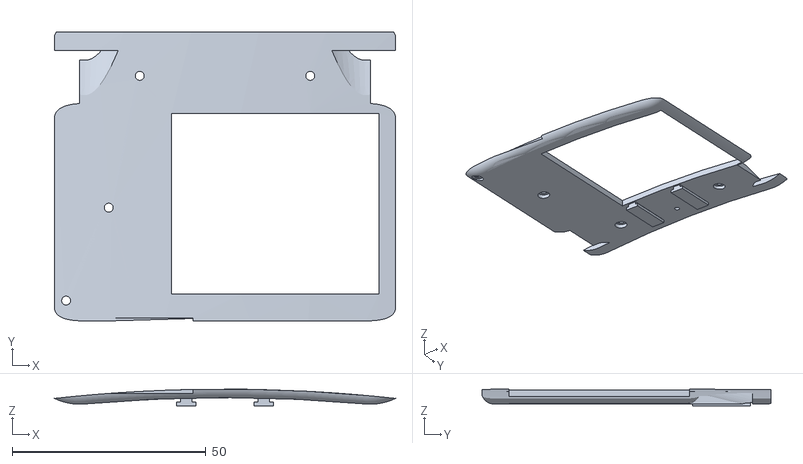
[picture p43: CAD file, 2026-10-25]
cad/out/stl/back_shell.stl
88.0 x 74.5 x 4.30
