DefeatedWarrior/OpenTheatreComms-Beltpack/cad/out/stl/front_function.stl

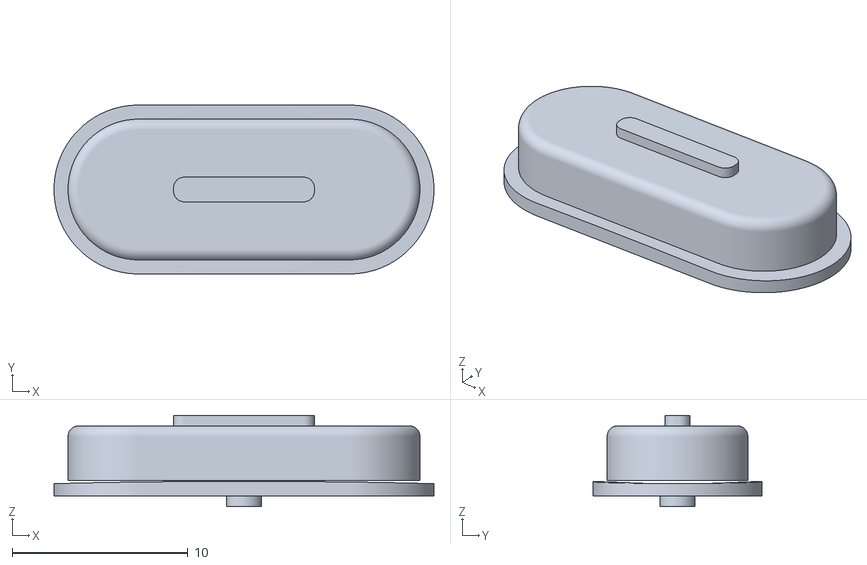
[picture p44: CAD file, 2026-10-25]
cad/out/stl/front_function.stl
21.6 x 9.60 x 5.20
