DefeatedWarrior/OpenTheatreComms-Beltpack/(list of files, cad)

Other CAD files:
cad/out/stl/knob_left.stl
cad/out/stl/keycap_4.stl
cad/out/stl/hub_left.stl
cad/out/stl/keycap_3.stl
