DefeatedWarrior/OpenTheatreComms-Beltpack/kicad/base_pcb/fab/assembly_top.png

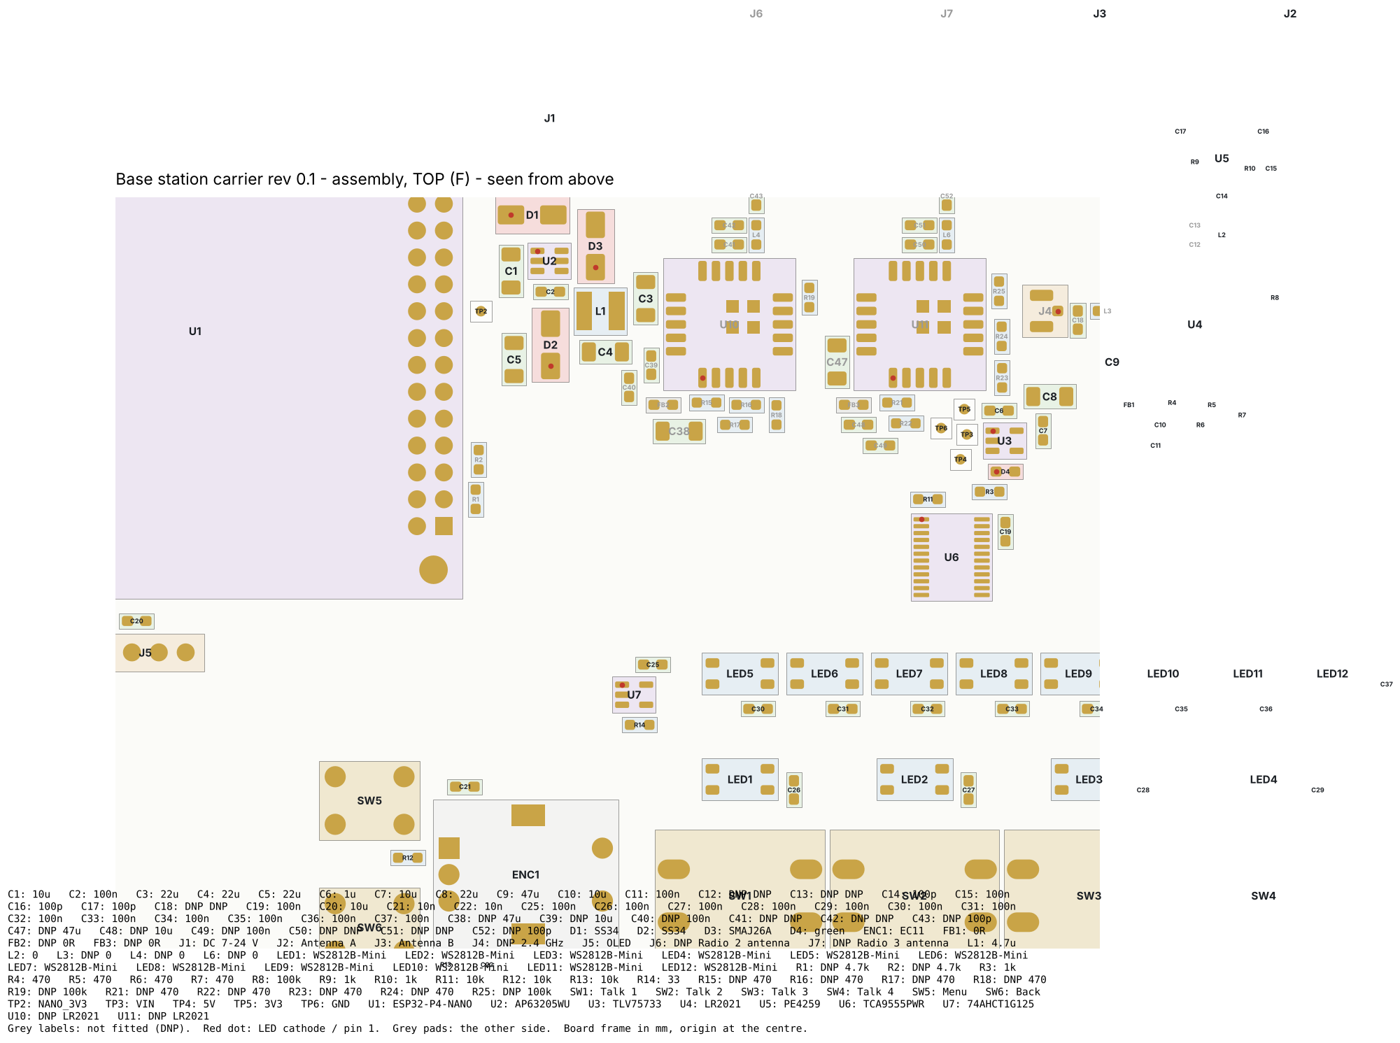
kicad/base_pcb/fab/assembly_top.png
