DefeatedWarrior/OpenTheatreComms-Beltpack/kicad/main_pcb/fab/assembly_top.png

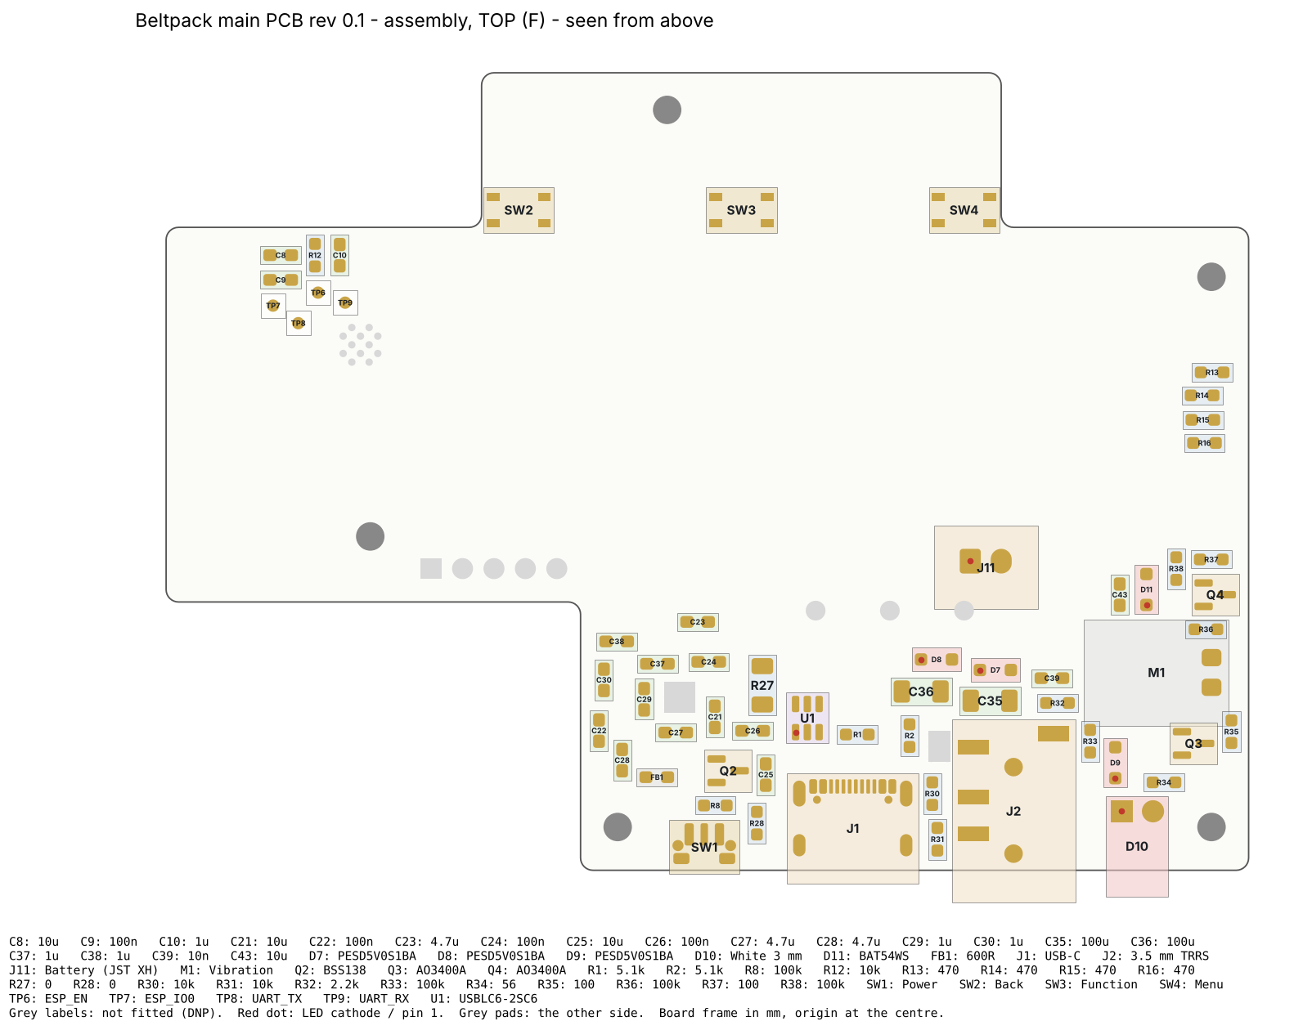
kicad/main_pcb/fab/assembly_top.png
