DefeatedWarrior/OpenTheatreComms-Beltpack/kicad/top_pcb/fab/assembly_bottom.png

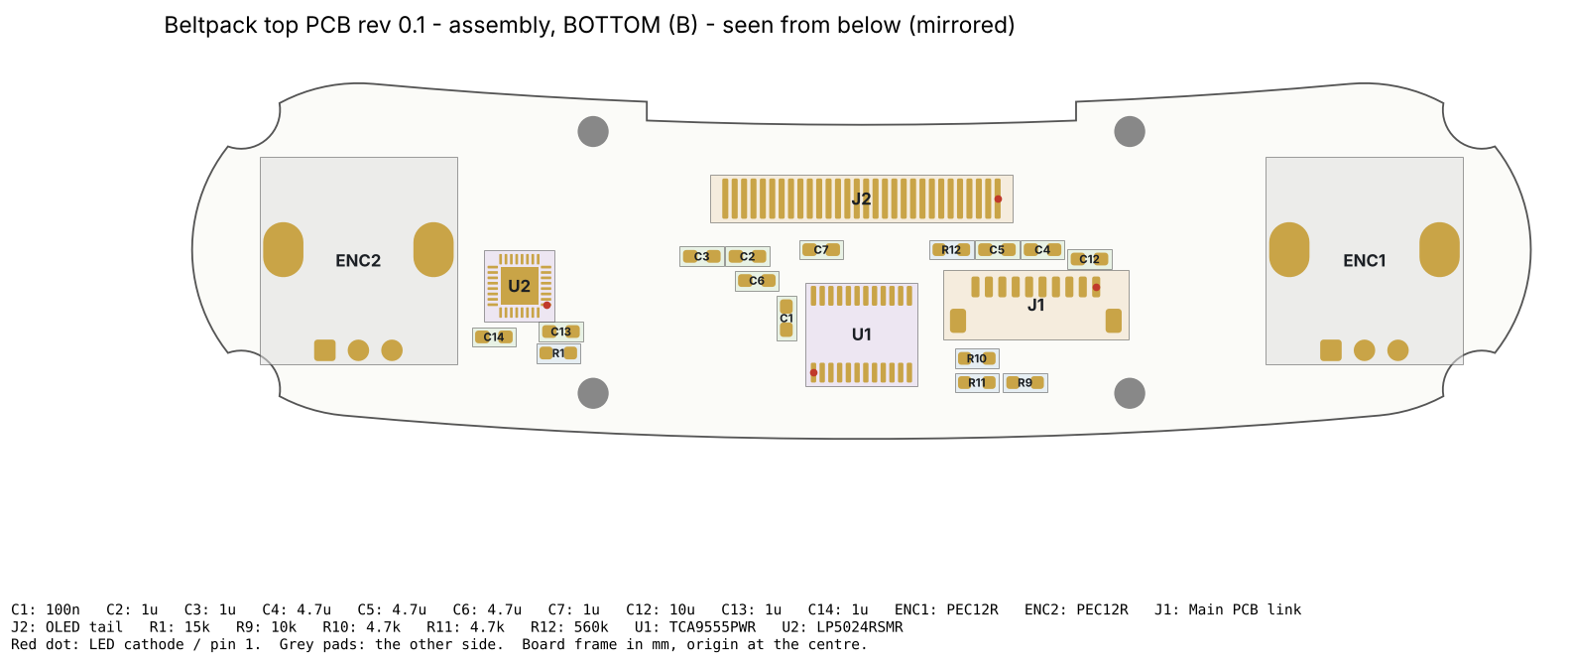
kicad/top_pcb/fab/assembly_bottom.png
