DefeatedWarrior/OpenTheatreComms-Beltpack/kicad/top_pcb/fab/assembly_top.png

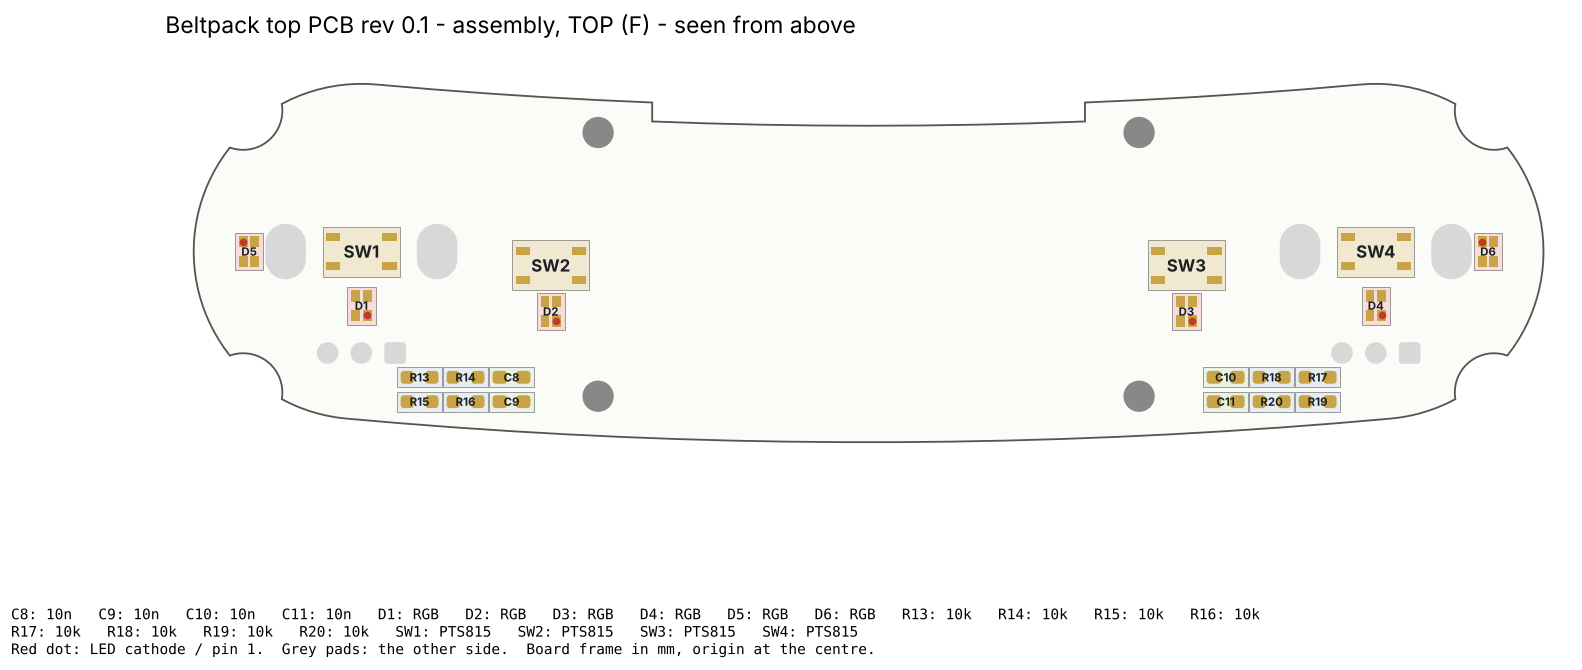
kicad/top_pcb/fab/assembly_top.png
