DefeatedWarrior/OpenTheatreComms-Beltpack/kicad/top_pcb/fab/assembly.pdf

# Beltpack top PCB rev 0.1 - assembly, TOP (F) - seen from above

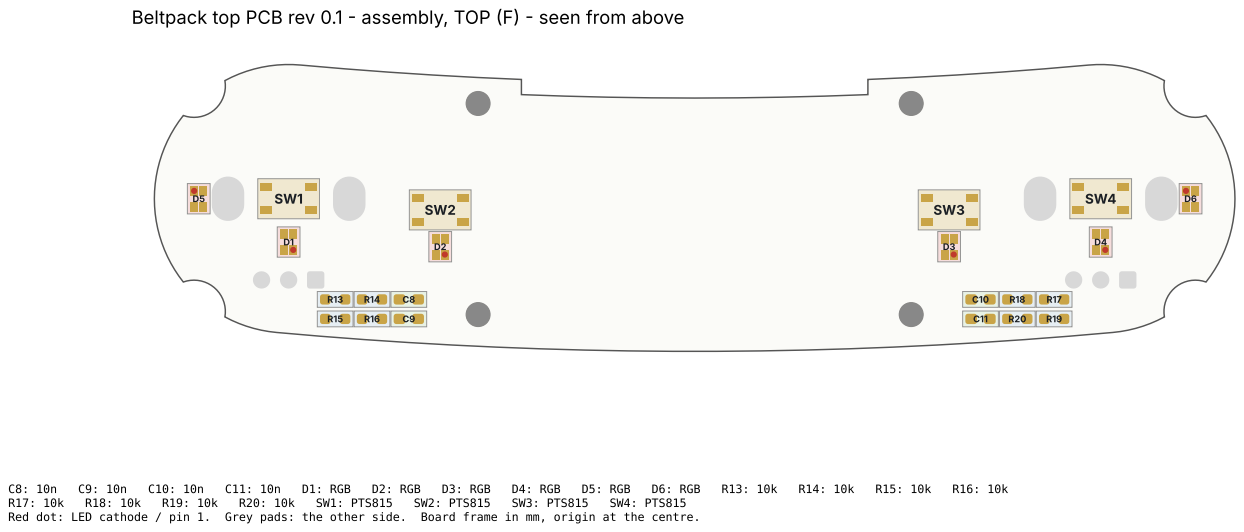
[picture p49: page 1]

# Beltpack top PCB rev 0.1 - assembly, BOTTOM (B) - seen from below (mirrored)

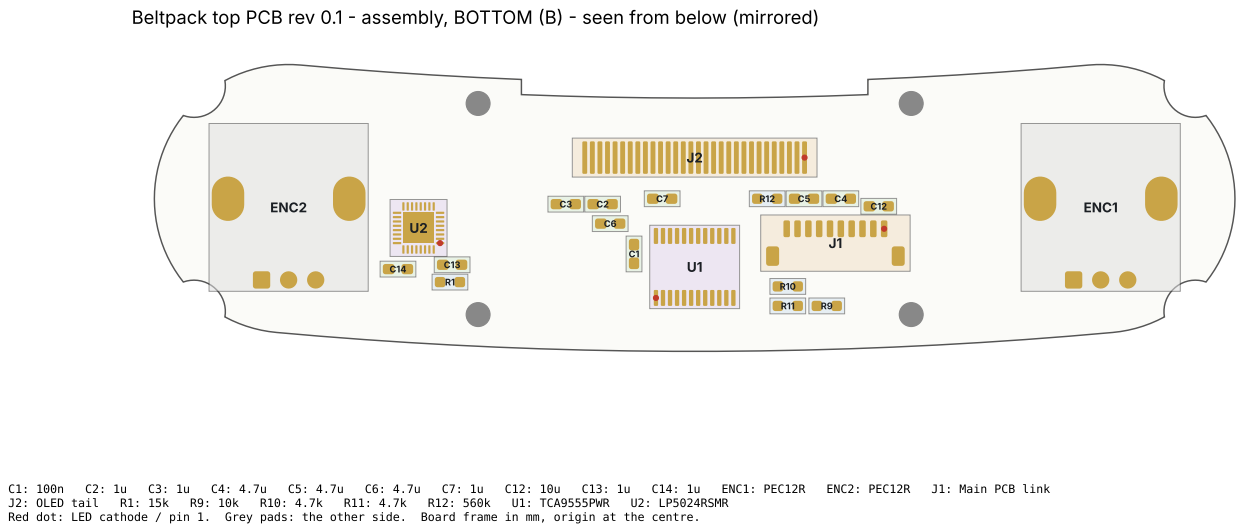
[picture p50: page 2]
