DefeatedWarrior/OpenTheatreComms-Beltpack/kicad/top_pcb/fab/top_pcb_schematic.pdf

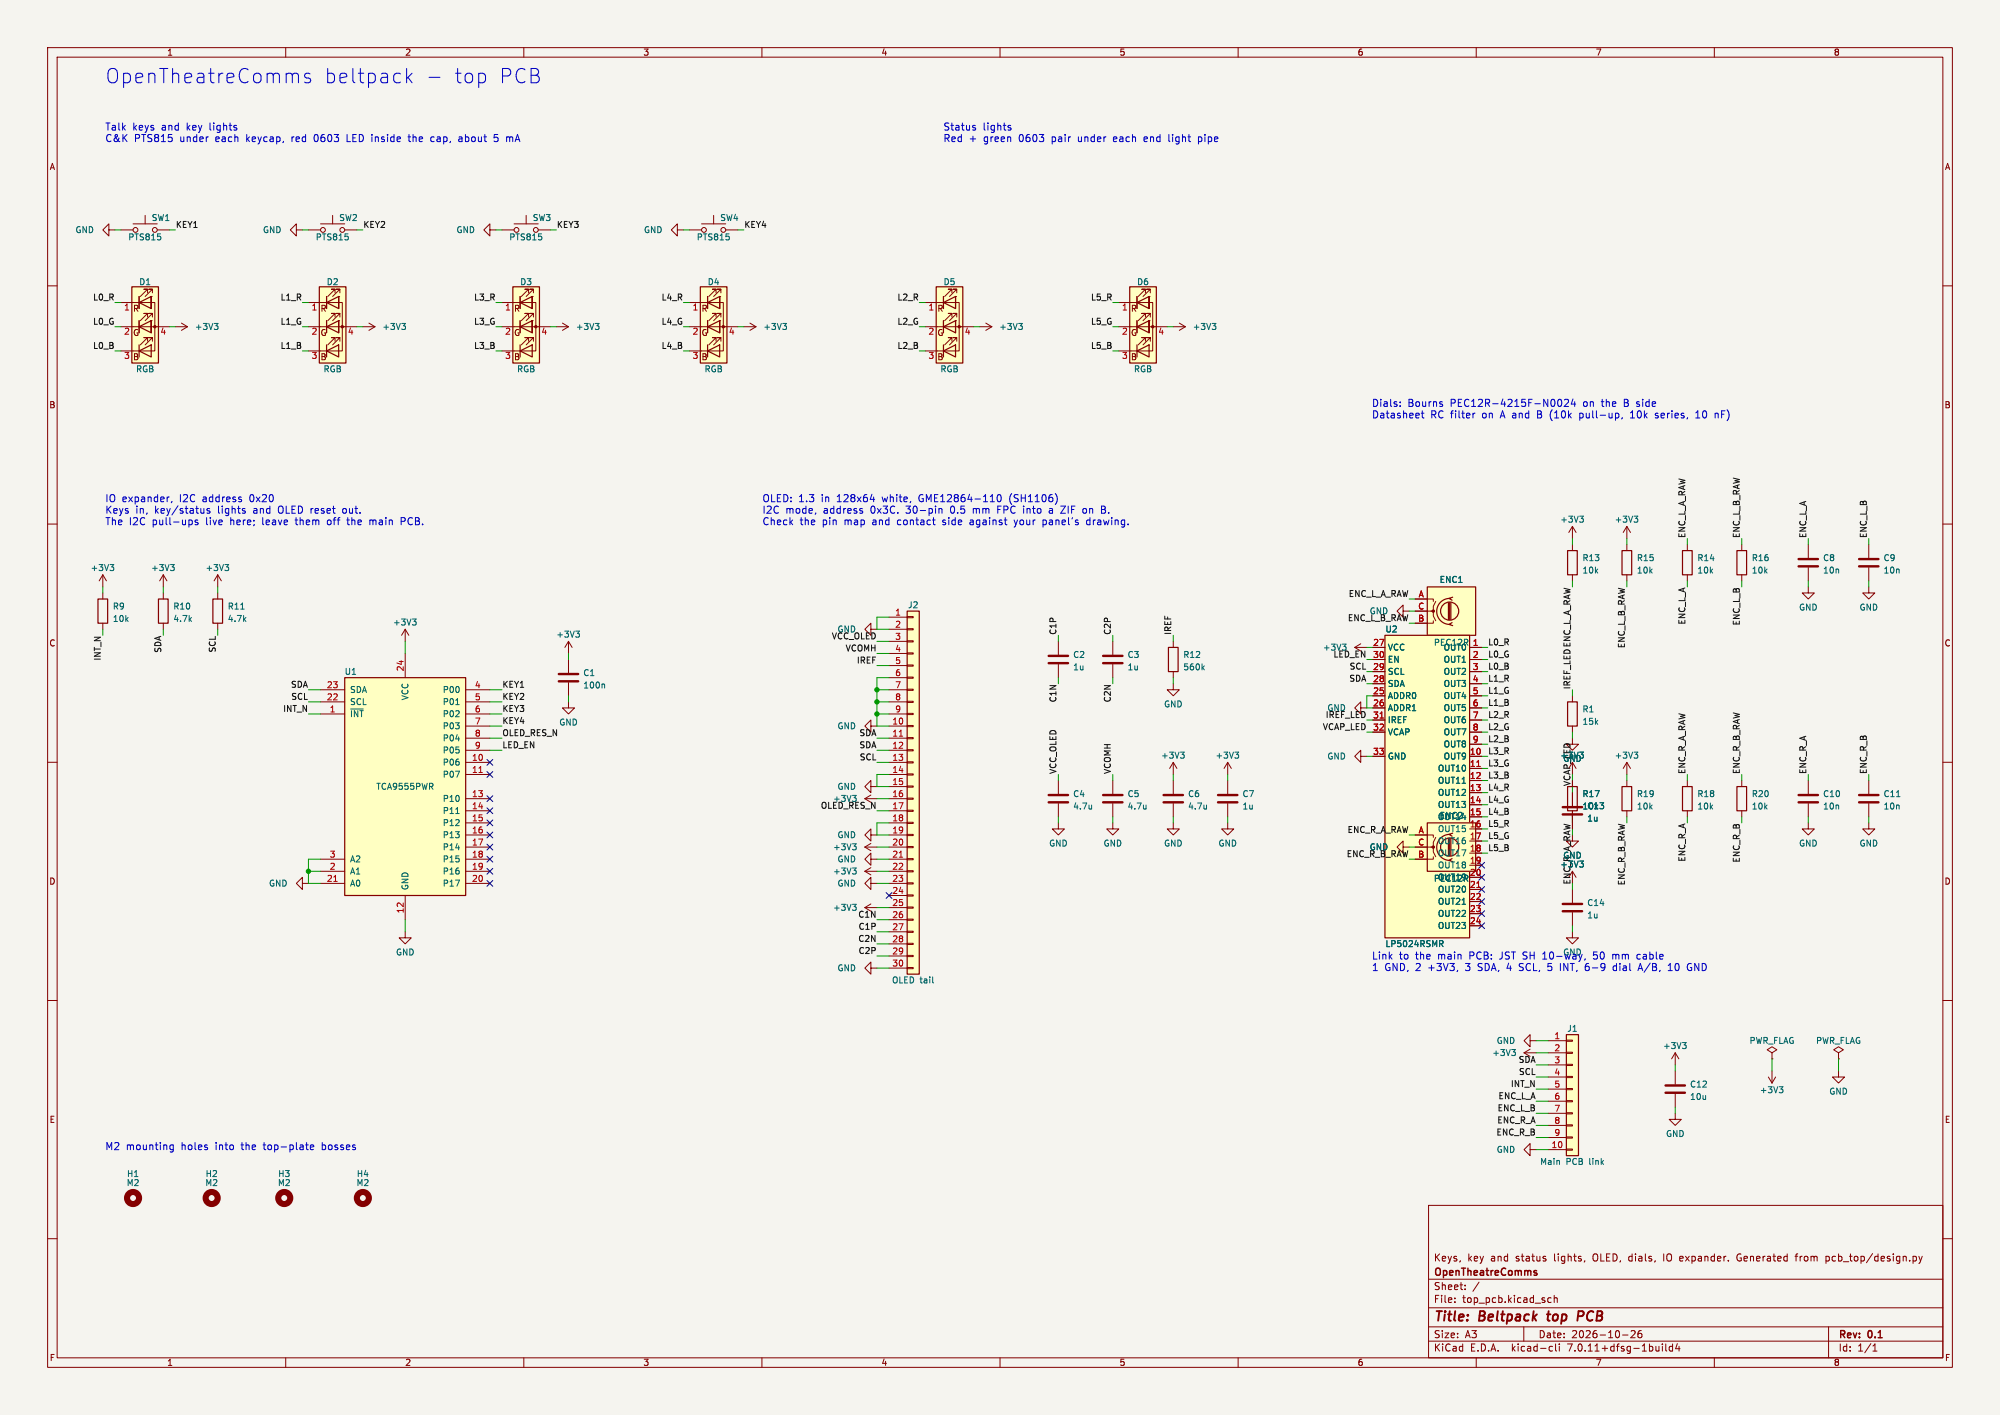
[picture p51: page 1]

Id: 1/1 Title: Beltpack top PCB
