DefeatedWarrior/OpenTheatreComms-Beltpack/kicad/base_pcb/fab/assembly.pdf

# Base station carrier rev 0.1 - assembly, TOP (F) - seen from above

U5

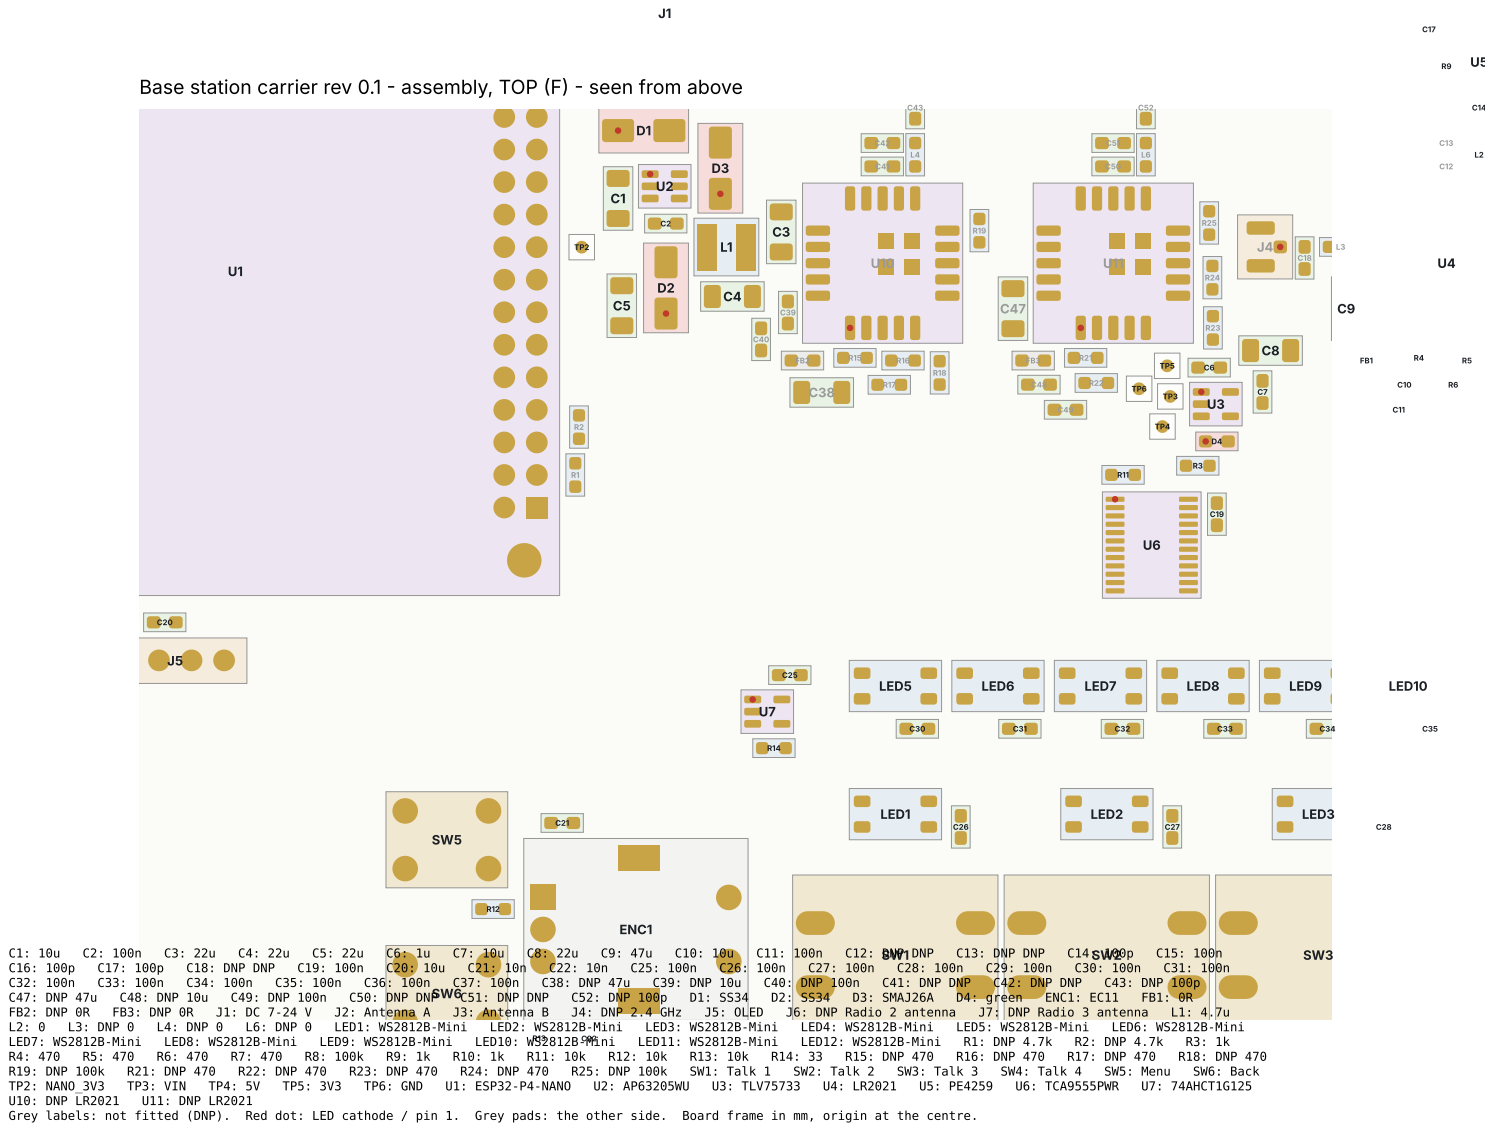
[picture p52: page 1]
