DefeatedWarrior/OpenTheatreComms-Beltpack/kicad/base_pcb/fab/base_pcb_schematic.pdf

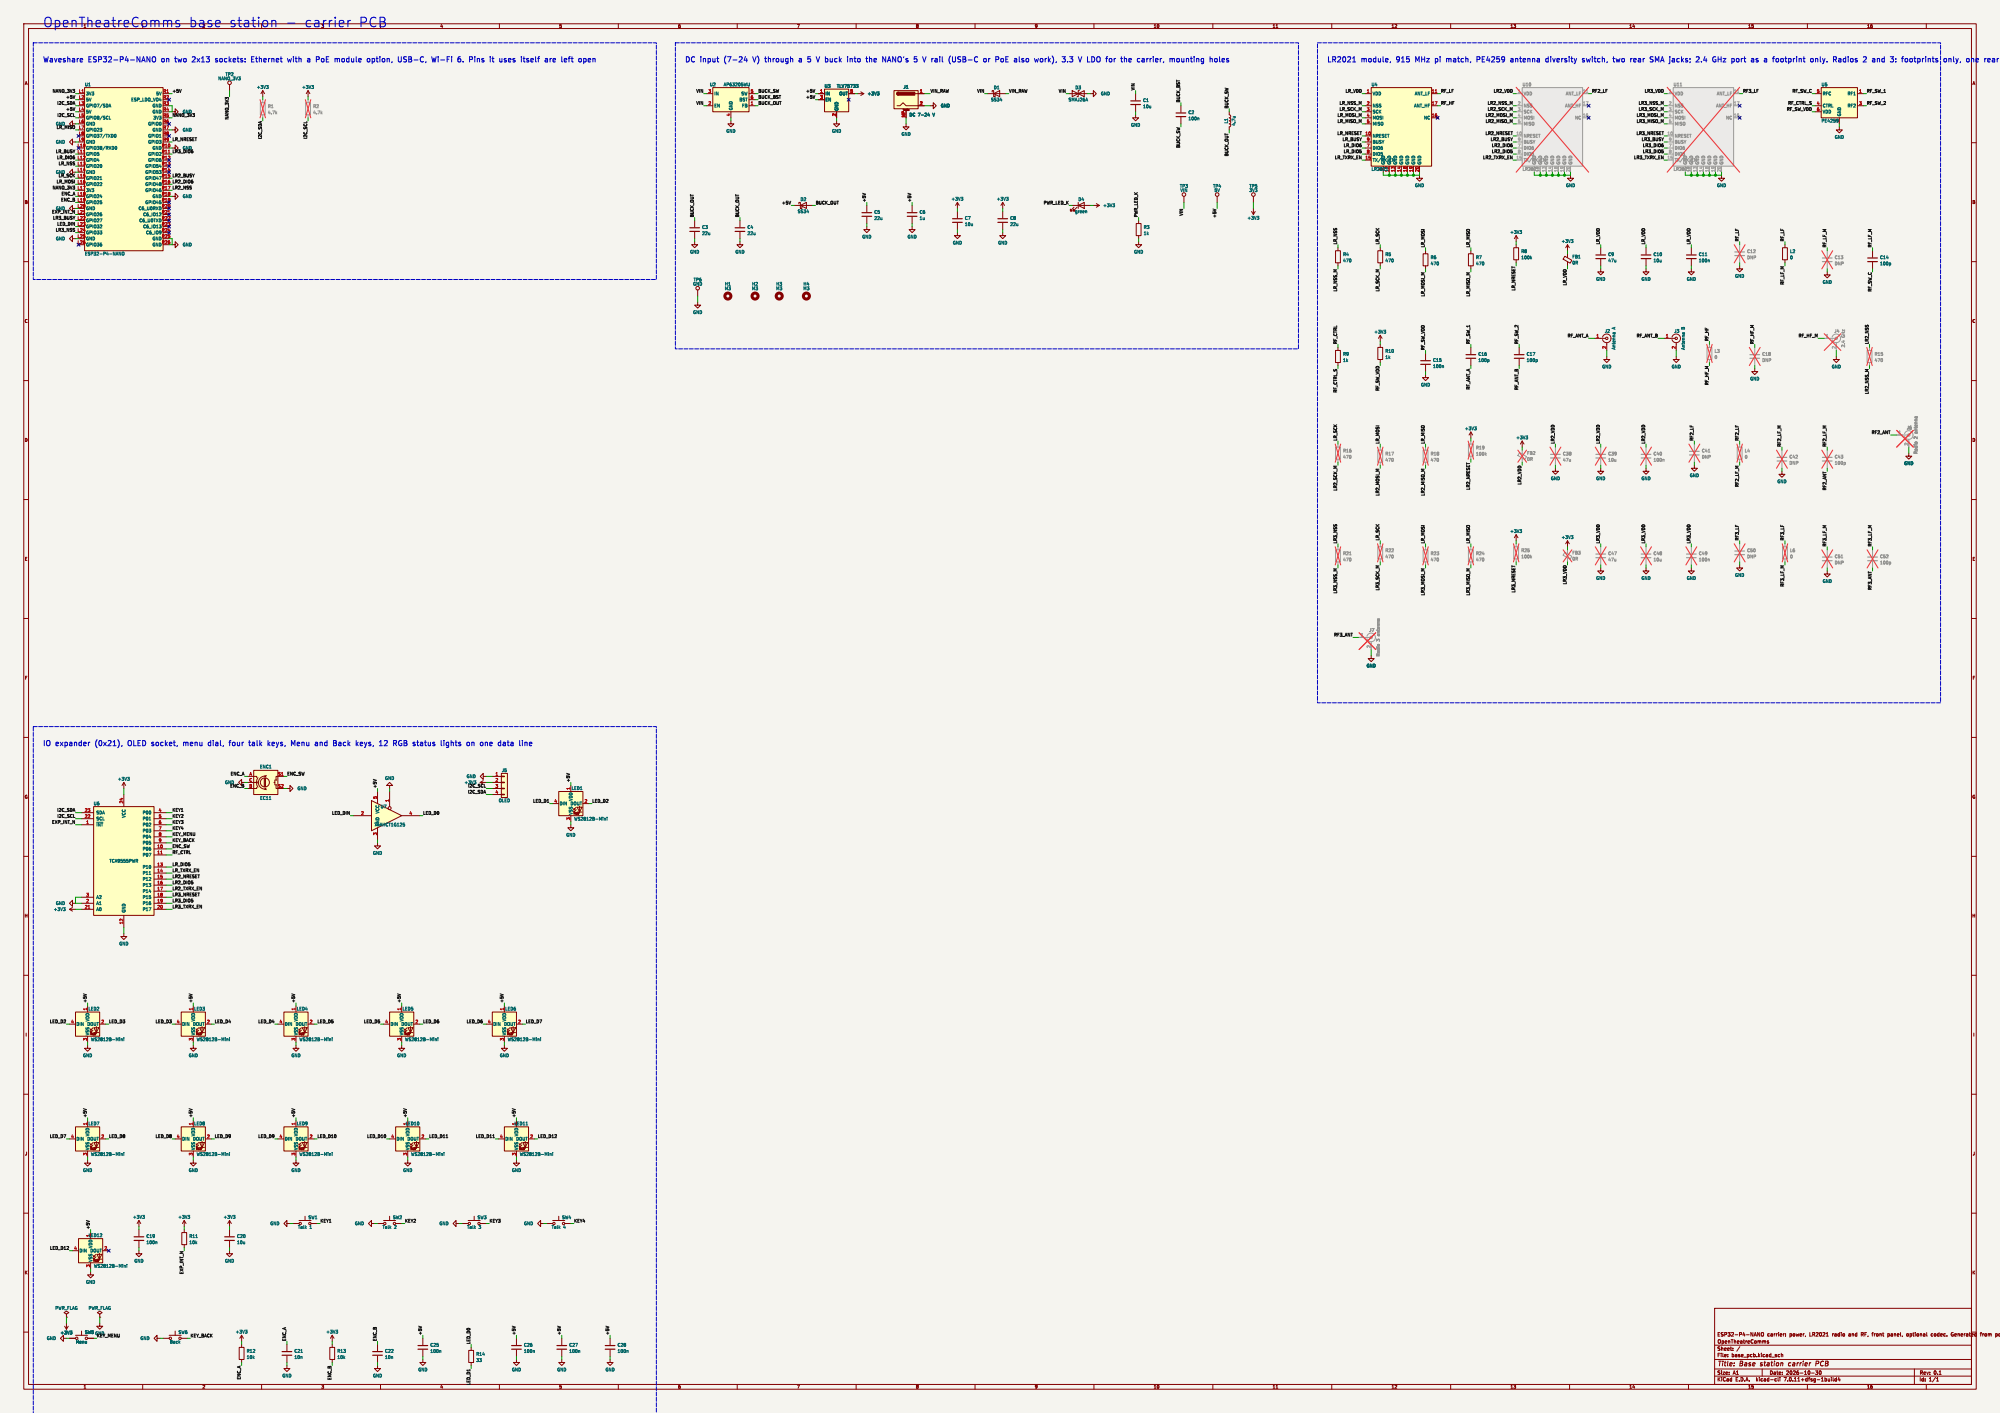
[picture p53: page 1]

IO expander (0x21), OLED socket, menu dial, four talk keys, Menu and Back keys, 12 RGB status lights on one data line

Id: 1/1 Title: Base station carrier PCB
