DefeatedWarrior/OpenTheatreComms-Beltpack/kicad/dock_contact_pcb/fab/dock_contact_pcb_schematic.pdf

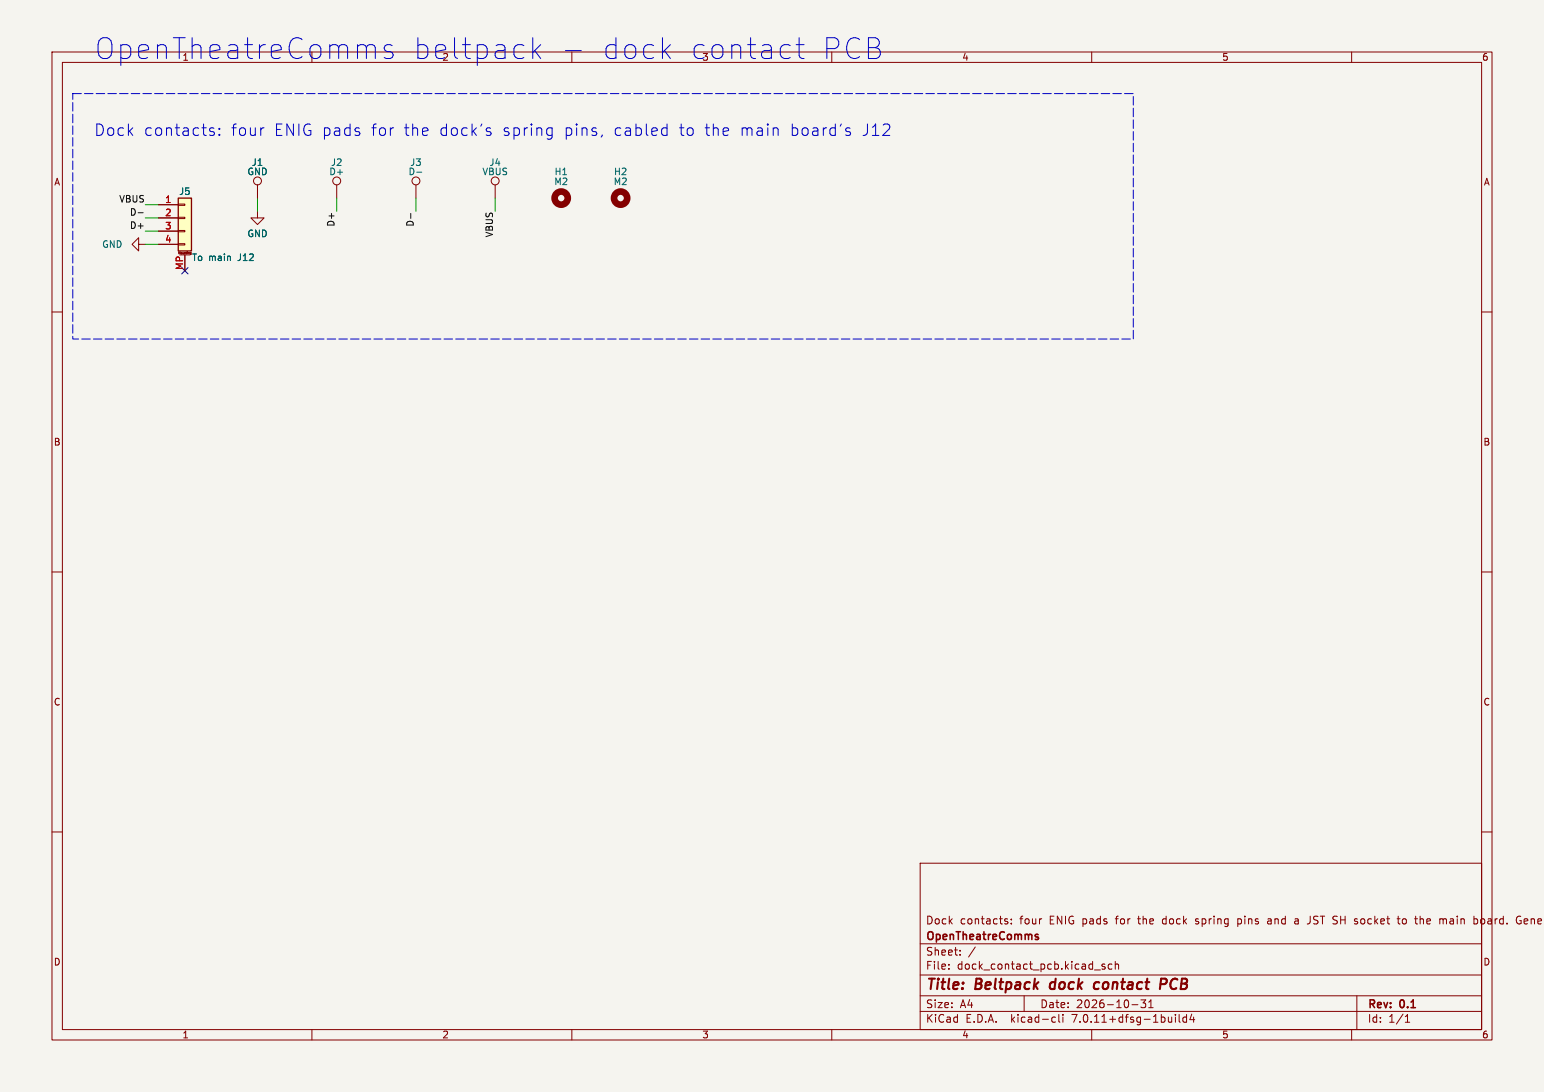
[picture p54: page 1]

Id: 1/1 Title: Beltpack dock contact PCB
