DefeatedWarrior/OpenTheatreComms-Beltpack/kicad/main_pcb/fab/assembly.pdf

# Beltpack main PCB rev 0.1 - assembly, TOP (F) - seen from above

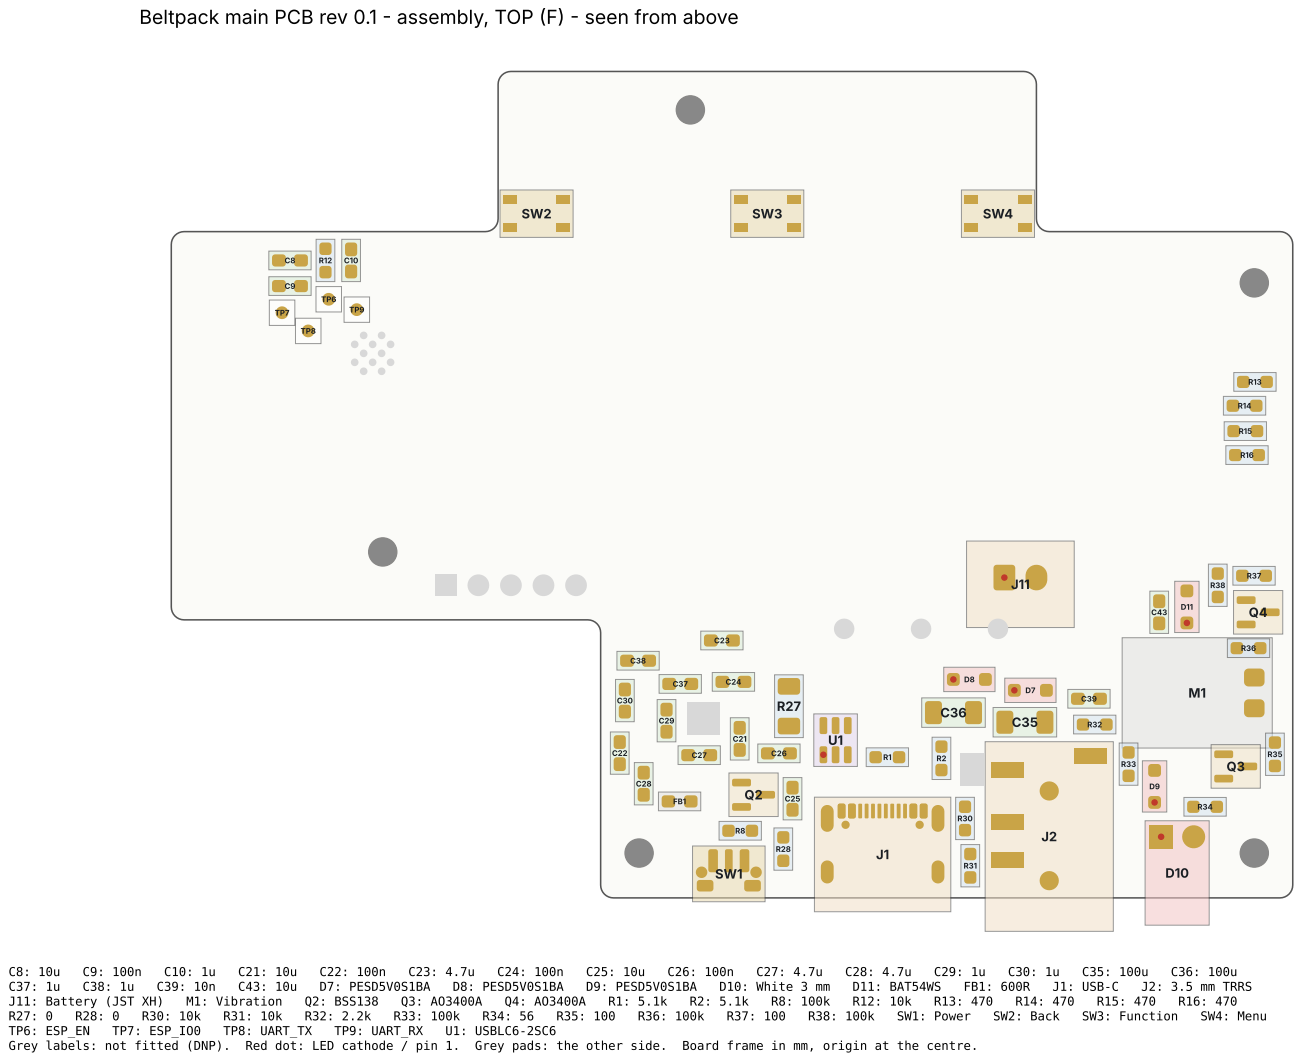
[picture p55: page 1]

# Beltpack main PCB rev 0.1 - assembly, BOTTOM (B) - seen from below (mirrored)

J4

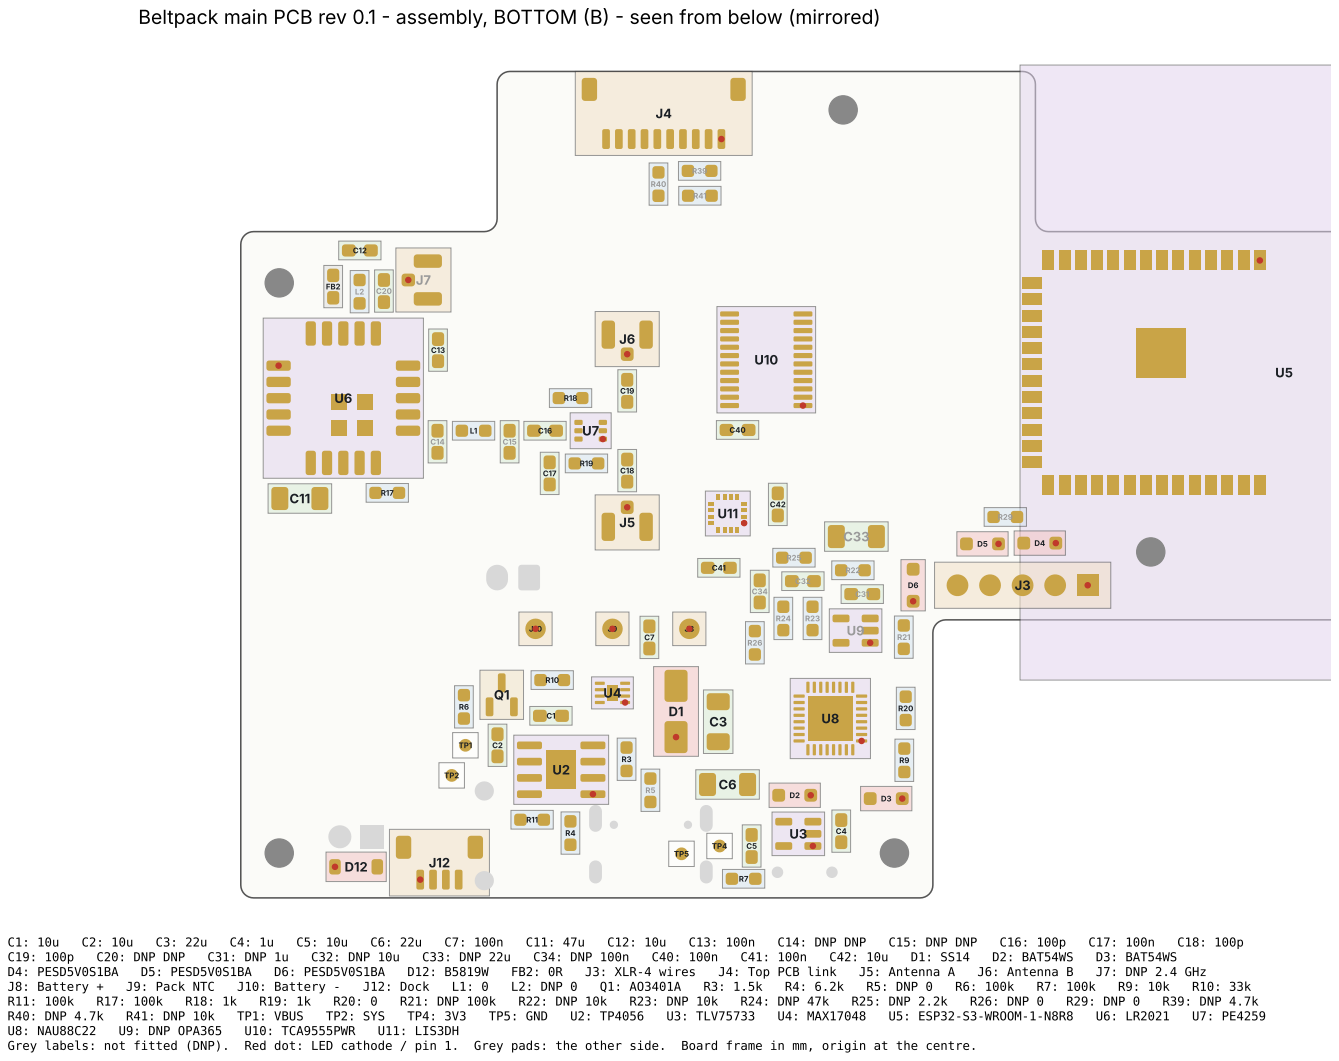
[picture p56: page 2]
