DefeatedWarrior/OpenTheatreComms-Beltpack/kicad/main_pcb/fab/main_pcb_schematic.pdf

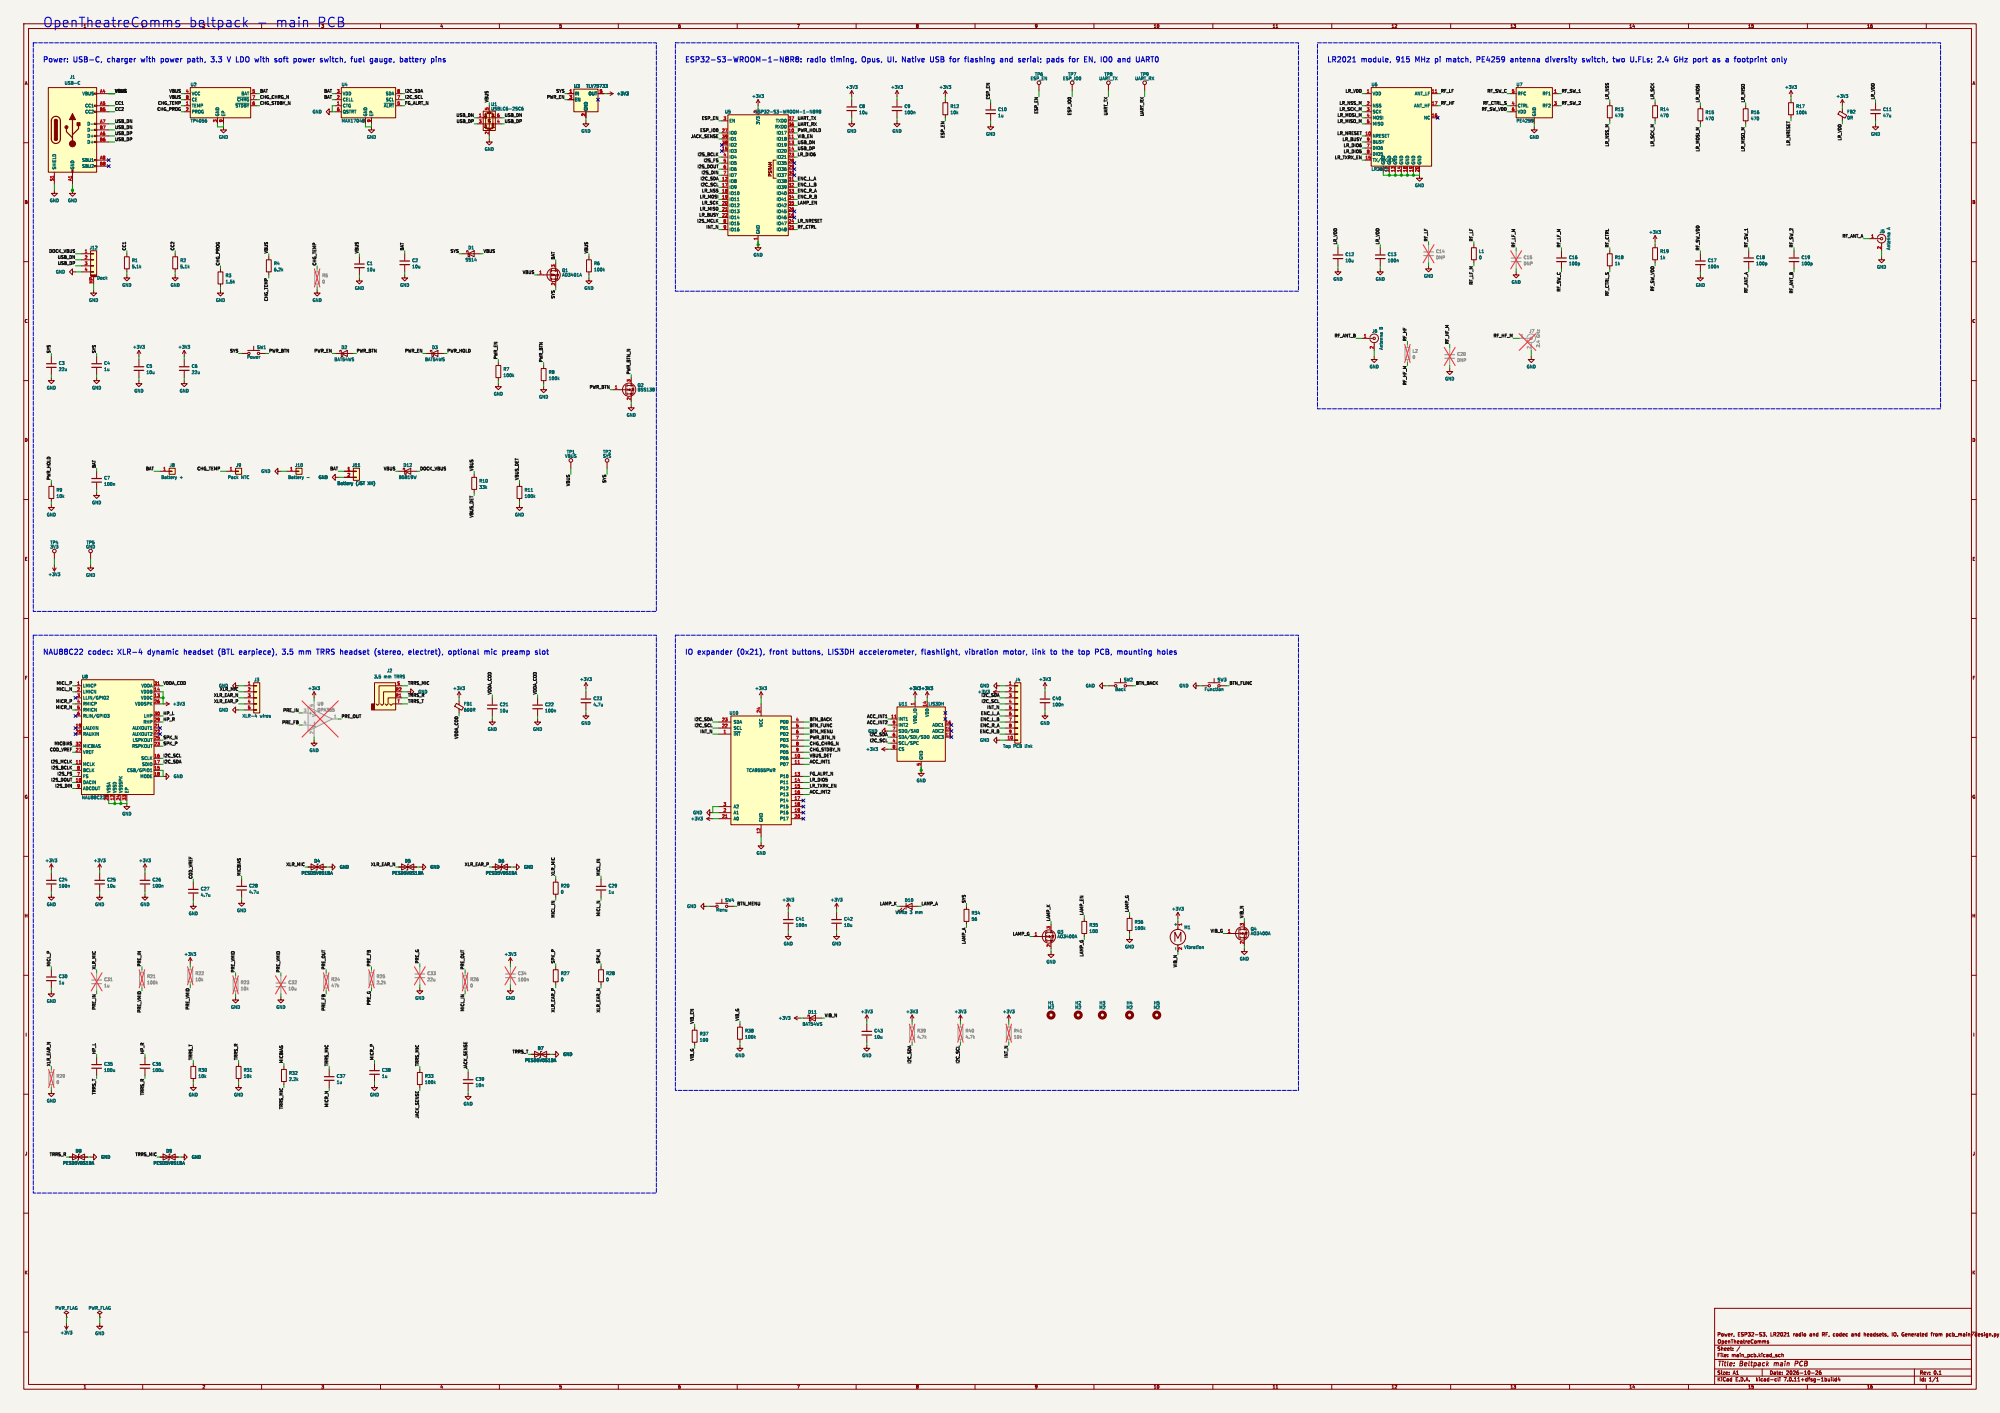
[picture p57: page 1]

3 VCC 4 BAT 5 ~{STDBY}6 ~{CHRG}7 CE 8 EP

4 ~{ALRT}5 QSTRT 6 SCL 7 SDA 8 EP

Id: 1/1 Title: Beltpack main PCB
