DefeatedWarrior/OpenTheatreComms-Beltpack/kicad/pack_lid_pcb/fab/pack_lid_pcb_schematic.pdf

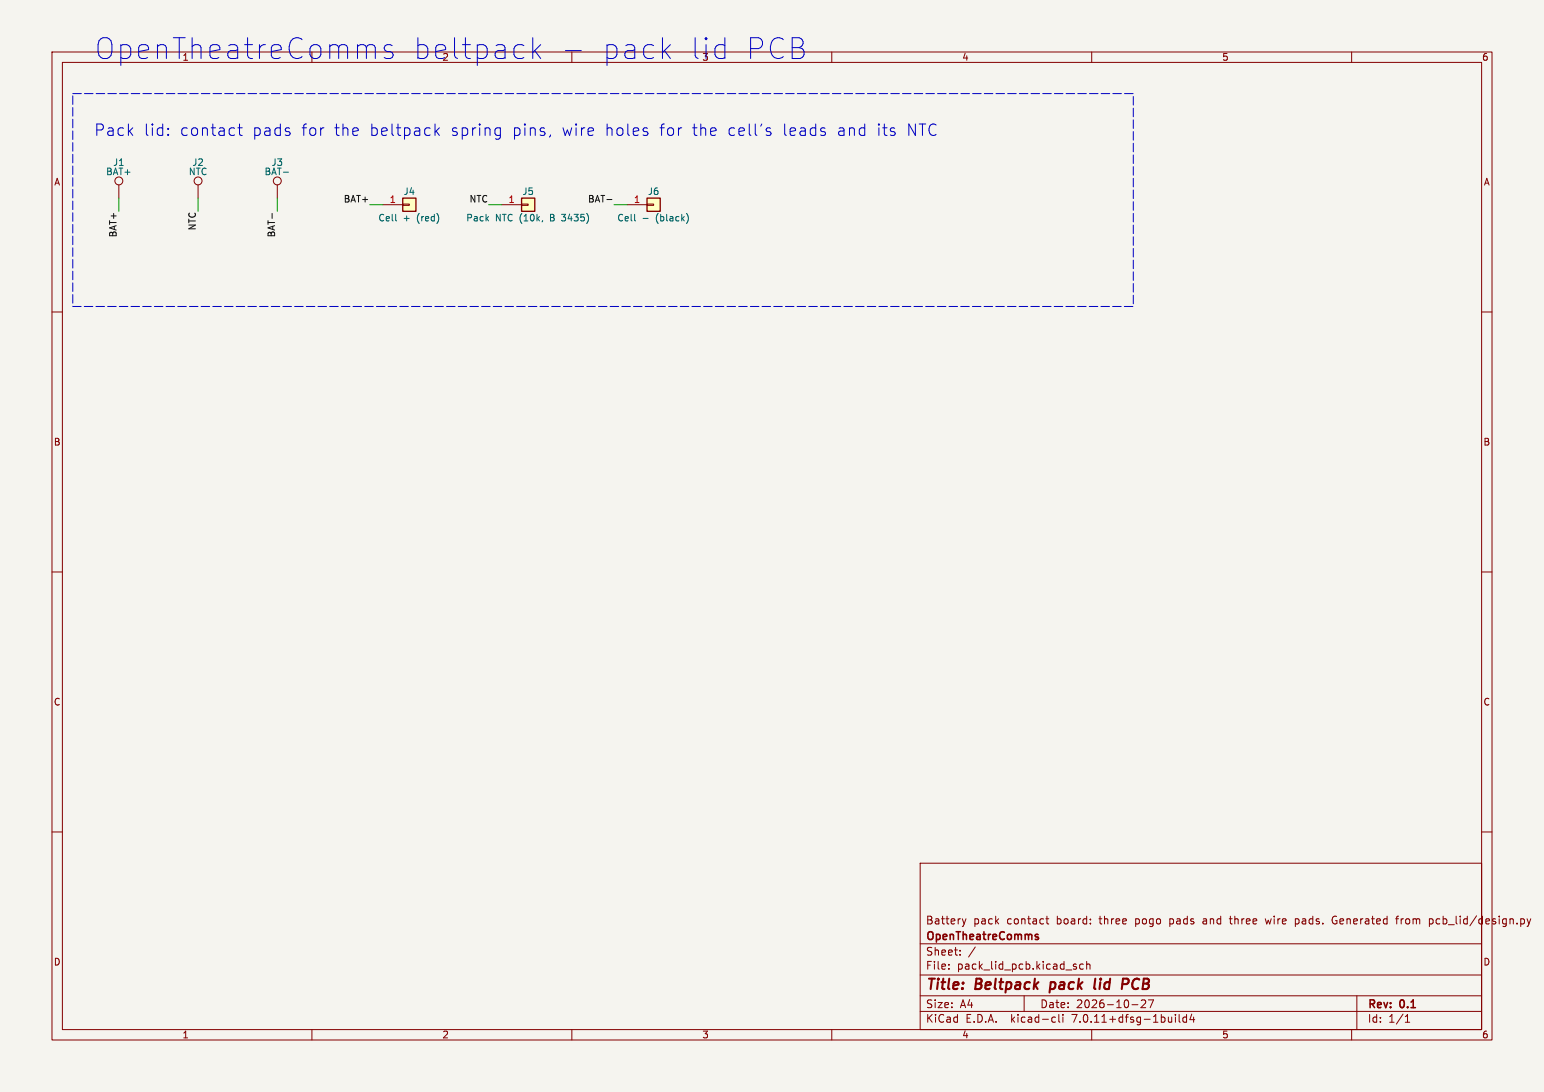
[picture p58: page 1]

Id: 1/1 Title: Beltpack pack lid PCB
