DefeatedWarrior/OpenTheatreComms-Beltpack/kicad/base_pcb/fab/base_pcb_print_1to1.pdf

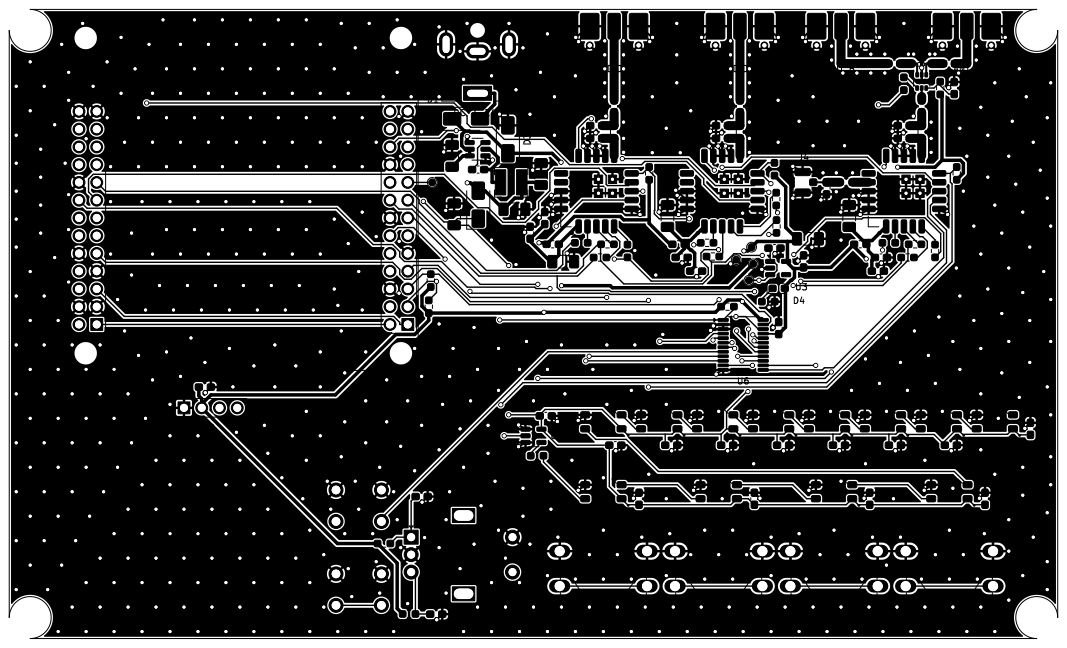
[picture p59: page 1]

ANT A TALK 1 OLED module
