DefeatedWarrior/OpenTheatreComms-Beltpack/kicad/top_pcb/top_pcb.kicad_pcb

## KiCad design kicad/top_pcb/top_pcb.kicad_pcb (2026-11-11)

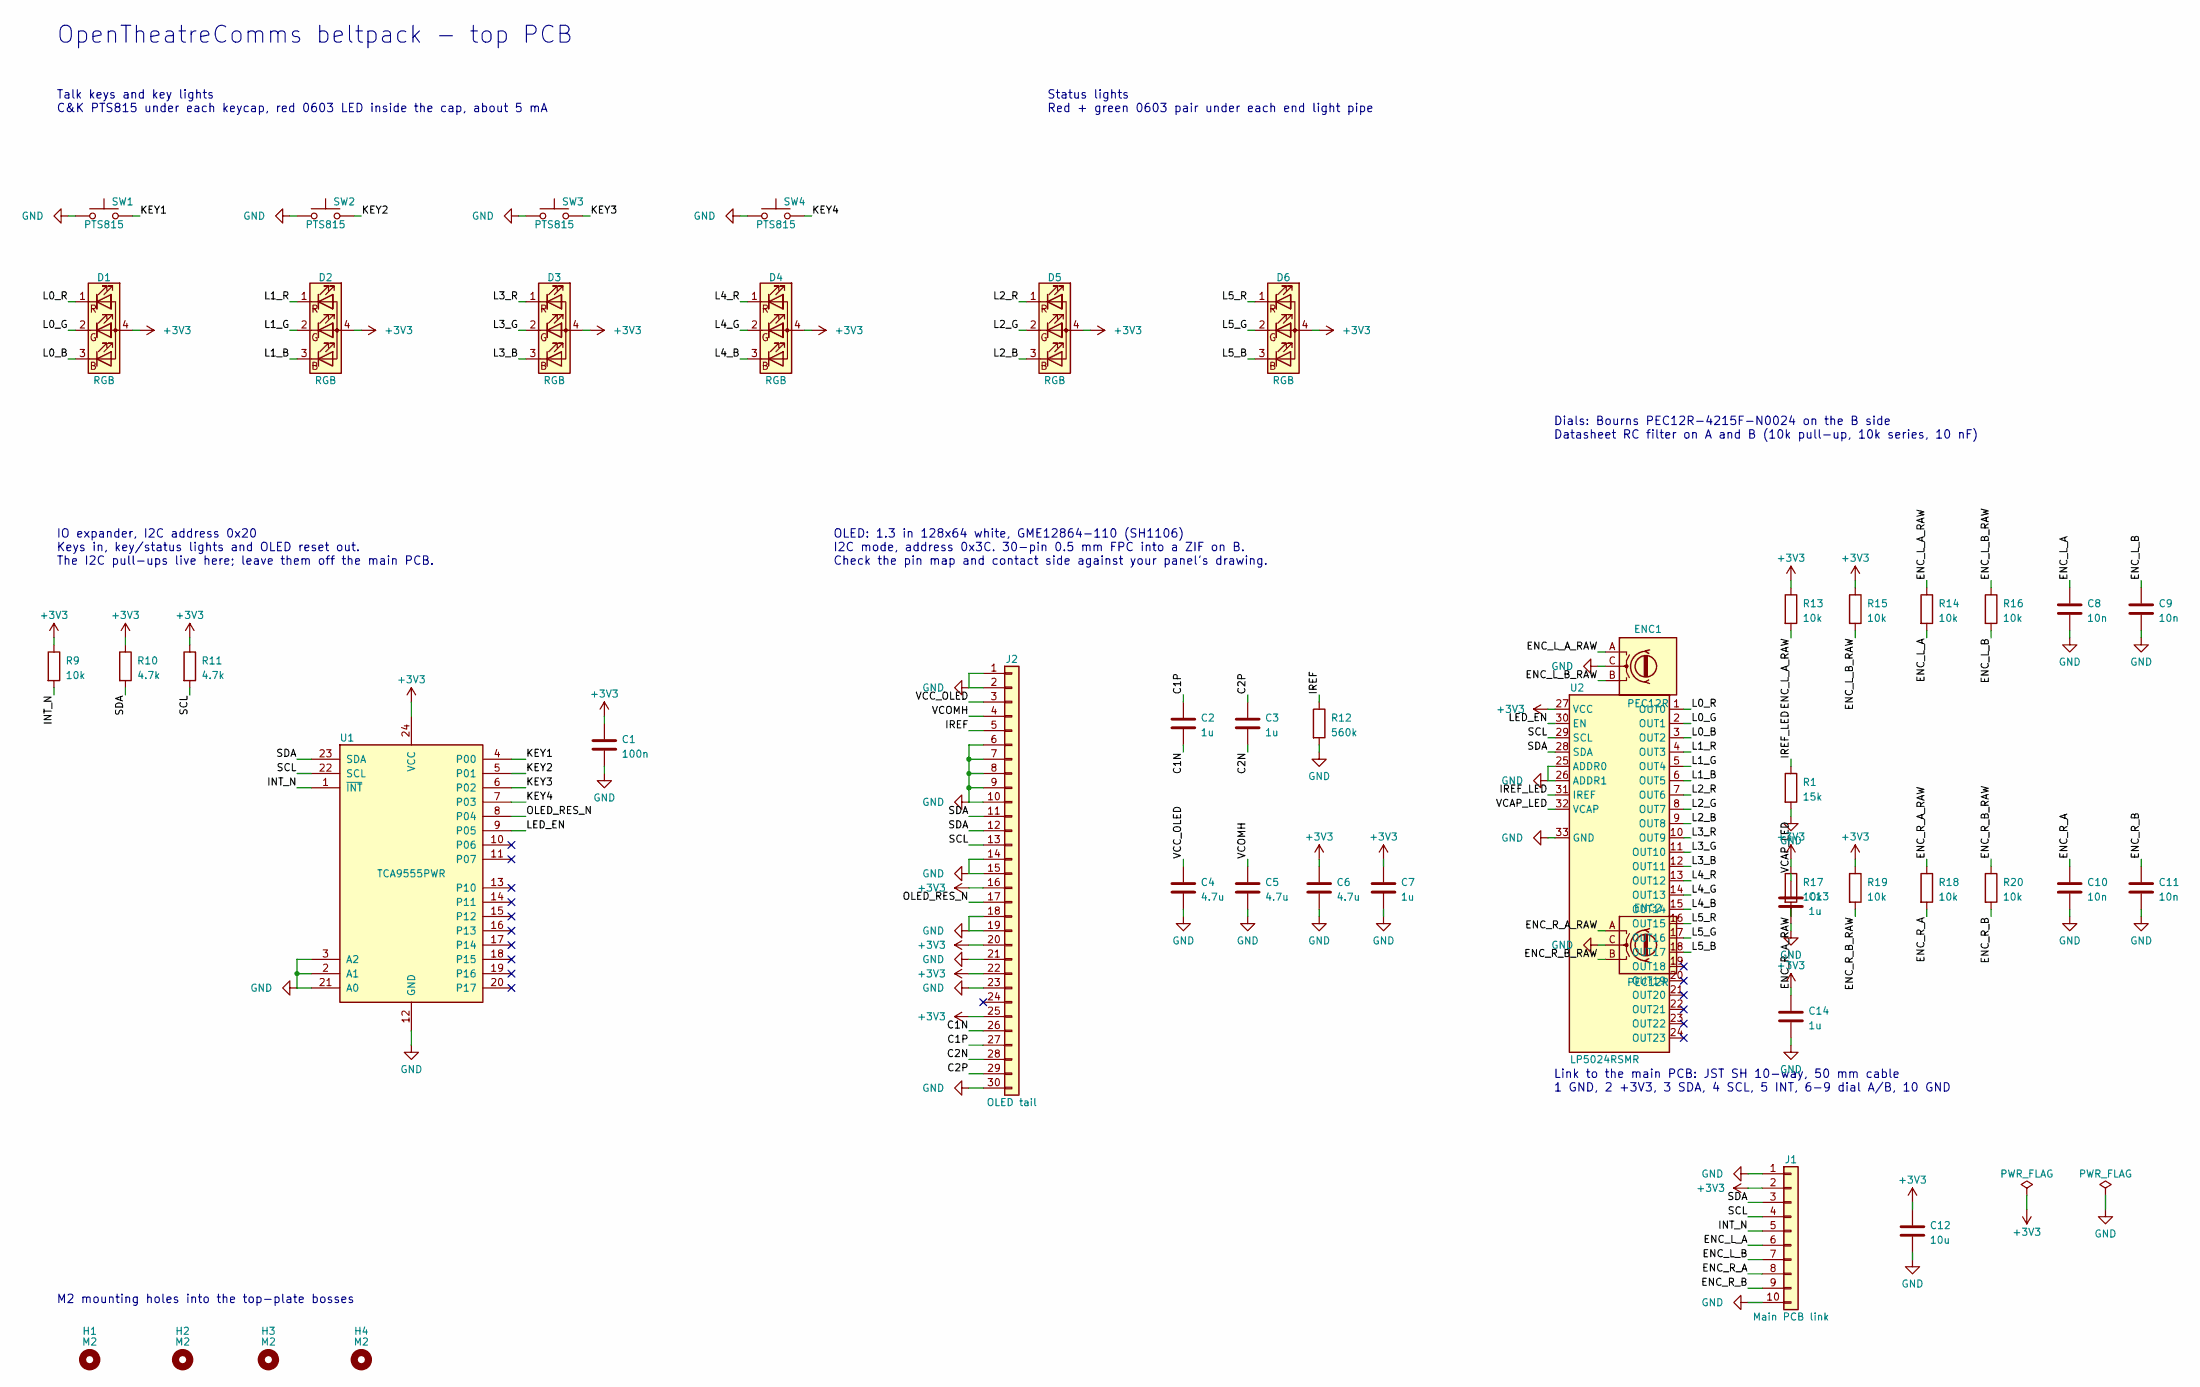
[picture p60: schematic top_pcb.kicad_sch, Beltpack top PCB]

Parts:
C1: 100n; C_0603_1608Metric_Pad1.08x0.95mm_HandSolder; MPN 0603 X7R 50 V
C2, C3, C13, C14: 1u; C_0603_1608Metric_Pad1.08x0.95mm_HandSolder; MPN 0603 X5R
C4, C5: 4.7u; C_0603_1608Metric_Pad1.08x0.95mm_HandSolder; MPN 0603 X5R 25 V
C6: 4.7u; C_0603_1608Metric_Pad1.08x0.95mm_HandSolder; MPN 0603 X5R 10 V
C7: 1u; C_0603_1608Metric_Pad1.08x0.95mm_HandSolder; MPN 0603 X5R 10 V
C8, C9, C10, C11: 10n; C_0603_1608Metric_Pad1.08x0.95mm_HandSolder; MPN 0603 X7R 50 V
C12: 10u; C_0603_1608Metric_Pad1.08x0.95mm_HandSolder; MPN 0603 X5R 10 V
D1, D2, D3, D4, D5, D6: RGB; LED_LiteOn_LTST-C19HE1WT; MPN Lite-On LTST-C19HE1WT
ENC1, ENC2: PEC12R; RotaryEncoder_Bourns_Vertical_PEC12R-3x17F-Nxxxx; MPN Alps EC11N1520402
H1, H2, H3, H4: M2; MountingHole_2.2mm_M2
J1: Main PCB link; JST_SH_BM10B-SRSS-TB_1x10-1MP_P1.00mm_Vertical; MPN JST BM10B-SRSS-TB
J2: OLED tail; OLED_Tail_30P_0.7mm_Solder; MPN OLED panel tail soldered to pads (no pa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
R1: 15k; R_0603_1608Metric_Pad0.98x0.95mm_HandSolder; MPN 0603 1%
R9, R13, R14, R15, R16, R17, R18, R19, R20: 10k; R_0603_1608Metric_Pad0.98x0.95mm_HandSolder; MPN 0603 1%
R10, R11: 4.7k; R_0603_1608Metric_Pad0.98x0.95mm_HandSolder; MPN 0603 1%
R12: 560k; R_0603_1608Metric_Pad0.98x0.95mm_HandSolder; MPN 0603 1%
SW1, SW2, SW3, SW4: PTS815; SW_SPST_PTS810; MPN C&K PTS815 SJM 250 SMTR LFS
U1: TCA9555PWR; TSSOP-24_4.4x7.8mm_P0.65mm; MPN TI TCA9555PWR
U2: LP5024RSMR; VQFN-32-1EP_4x4mm_P0.4mm_EP2.8x2.8mm; MPN TI LP5024RSMR

Connections:
+3V3: C1.1, C6.1, C7.1, C12.1, C14.1, D1.4 (A), D2.4 (A), D3.4 (A), D4.4 (A), D5.4 (A), D6.4 (A), J1.2, J2.16, J2.20, J2.22, J2.25, R9.1, R10.1, R11.1, R13.1, R15.1, R17.1, R19.1, U1.24 (VCC), U2.27 (VCC)
/C1N: C2.2, J2.26
/C1P: C2.1, J2.27
/C2N: C3.2, J2.28
/C2P: C3.1, J2.29
/ENC_L_A: C8.1, J1.6, R14.2
/ENC_L_A_RAW: ENC1.A, R13.2, R14.1
/ENC_L_B: C9.1, J1.7, R16.2
/ENC_L_B_RAW: ENC1.B, R15.2, R16.1
/ENC_R_A: C10.1, J1.8, R18.2
/ENC_R_A_RAW: ENC2.A, R17.2, R18.1
/ENC_R_B: C11.1, J1.9, R20.2
/ENC_R_B_RAW: ENC2.B, R19.2, R20.1
/INT_N: J1.5, R9.2, U1.1 (~INT)
/IREF: J2.5, R12.1
/IREF_LED: R1.1, U2.31 (IREF)
/KEY1: SW1.2, U1.4 (P00)
/KEY2: SW2.2, U1.5 (P01)
/KEY3: SW3.2, U1.6 (P02)
/KEY4: SW4.2, U1.7 (P03)
/L0_B: D1.3 (BK), U2.3 (OUT2)
/L0_G: D1.2 (GK), U2.2 (OUT1)
/L0_R: D1.1 (RK), U2.1 (OUT0)
/L1_B: D2.3 (BK), U2.6 (OUT5)
/L1_G: D2.2 (GK), U2.5 (OUT4)
/L1_R: D2.1 (RK), U2.4 (OUT3)
/L2_B: D5.3 (BK), U2.9 (OUT8)
/L2_G: D5.2 (GK), U2.8 (OUT7)
/L2_R: D5.1 (RK), U2.7 (OUT6)
/L3_B: D3.3 (BK), U2.12 (OUT11)
/L3_G: D3.2 (GK), U2.11 (OUT10)
/L3_R: D3.1 (RK), U2.10 (OUT9)
/L4_B: D4.3 (BK), U2.15 (OUT14)
/L4_G: D4.2 (GK), U2.14 (OUT13)
/L4_R: D4.1 (RK), U2.13 (OUT12)
/L5_B: D6.3 (BK), U2.18 (OUT17)
/L5_G: D6.2 (GK), U2.17 (OUT16)
/L5_R: D6.1 (RK), U2.16 (OUT15)
/LED_EN: U1.9 (P05), U2.30 (EN)
/OLED_RES_N: J2.17, U1.8 (P04)
/SCL: J1.4, J2.13, R11.2, U1.22 (SCL), U2.29 (SCL)
/SDA: J1.3, J2.11, J2.12, R10.2, U1.23 (SDA), U2.28 (SDA)
/VCAP_LED: C13.1, U2.32 (VCAP)
/VCC_OLED: C4.1, J2.3
/VCOMH: C5.1, J2.4
GND: C1.2, C4.2, C5.2, C6.2, C7.2, C8.2, C9.2, C10.2, C11.2, C12.2, C13.2, C14.2, ENC1.C, ENC2.C, J1.1, J1.10, J2.1, J2.2, J2.6, J2.7, J2.8, J2.9, J2.10, J2.14, J2.15, J2.18, J2.19, J2.21, J2.23, J2.30, R1.2, R12.2, SW1.1, SW2.1, SW3.1, SW4.1, U1.2 (A1), U1.3 (A2), U1.12 (GND), U1.21 (A0), U2.25 (ADDR0), U2.26 (ADDR1), U2.33 (GND)

Notes on the sheet:
Talk keys and key lights C&K PTS815 under each keycap, red 0603 LED inside the cap, about 5 mA
Status lights Red + green 0603 pair under each end light pipe
IO expander, I2C address 0x20 Keys in, key/status lights and OLED reset out. The I2C pull-ups live here; leave them off the main PCB.
OLED: 1.3 in 128x64 white, GME12864-110 (SH1106) I2C mode, address 0x3C. 30-pin 0.5 mm FPC into a ZIF on B. Check the pin map and contact side against your panel's drawing.
Dials: Bourns PEC12R-4215F-N0024 on the B side Datasheet RC filter on A and B (10k pull-up, 10k series, 10 nF)
Link to the main PCB: JST SH 10-way, 50 mm cable 1 GND, 2 +3V3, 3 SDA, 4 SCL, 5 INT, 6-9 dial A/B, 10 GND
M2 mounting holes into the top-plate bosses
OpenTheatreComms beltpack - top PCB

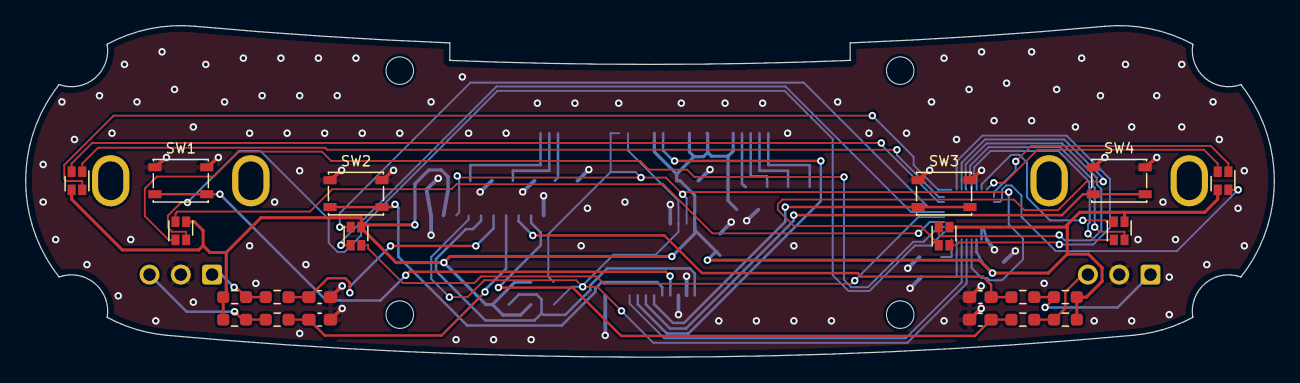
[picture p61: board top_pcb.kicad_pcb from above]

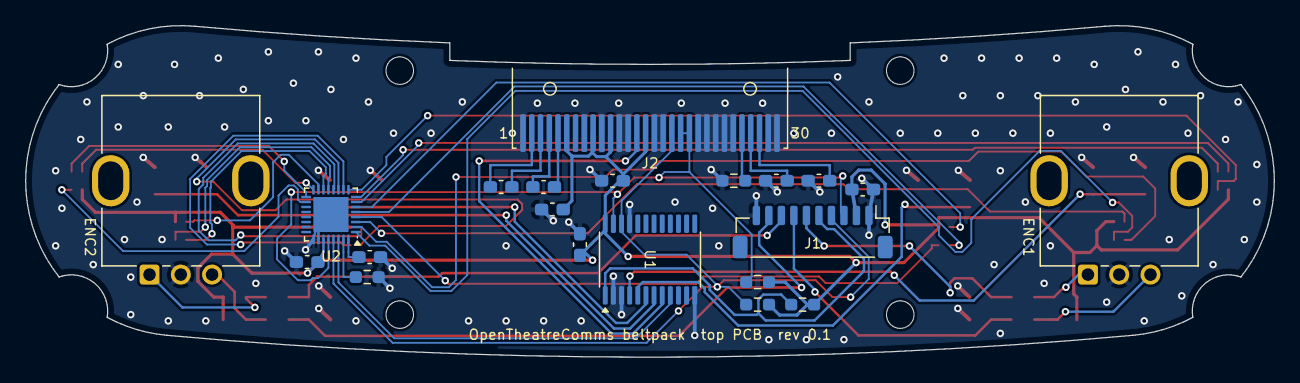
[picture p62: board top_pcb.kicad_pcb from below]

Board: 2 copper layers, 99.8 x 26.5 mm, 47 parts (21 on the bottom side), 46 nets.
