DefeatedWarrior/OpenTheatreComms-Beltpack/kicad/base_pcb/base_pcb.kicad_pcb

## KiCad design kicad/base_pcb/base_pcb.kicad_pcb (2026-10-31)

Schematic: base_pcb.kicad_sch, Base station carrier PCB

Parts:
C1: 10u; C_1206_3216Metric_Pad1.33x1.80mm_HandSolder; MPN 1206 X7R 50 V
C2, C11, C15, C19, C25, C26, C27, C28, C29, C30, C31, C32, C33, C34, C35, C36, C37: 100n; C_0603_1608Metric_Pad1.08x0.95mm_HandSolder; MPN 0603 X7R
C3, C4, C5, C8: 22u; C_1206_3216Metric_Pad1.33x1.80mm_HandSolder; MPN 1206 X5R 10 V
C6: 1u; C_0603_1608Metric_Pad1.08x0.95mm_HandSolder; MPN 0603 X5R 10 V
C7, C10, C20: 10u; C_0603_1608Metric_Pad1.08x0.95mm_HandSolder; MPN 0603 X5R 10 V
C9: 47u; C_1206_3216Metric_Pad1.33x1.80mm_HandSolder; MPN 1206 X5R 6.3 V
C12, C13, C18, C41, C42, C50, C51: DNP; C_0603_1608Metric_Pad1.08x0.95mm_HandSolder; MPN 0603 C0G, tune; not fitted
C14, C16, C17: 100p; C_0603_1608Metric_Pad1.08x0.95mm_HandSolder; MPN 0603 C0G 50 V
C21, C22: 10n; C_0603_1608Metric_Pad1.08x0.95mm_HandSolder; MPN 0603 X7R
C38, C47: 47u; C_1206_3216Metric_Pad1.33x1.80mm_HandSolder; MPN 1206 X5R 6.3 V; not fitted
C39, C48: 10u; C_0603_1608Metric_Pad1.08x0.95mm_HandSolder; MPN 0603 X5R 10 V; not fitted
C40, C49: 100n; C_0603_1608Metric_Pad1.08x0.95mm_HandSolder; MPN 0603 X7R; not fitted
C43, C52: 100p; C_0603_1608Metric_Pad1.08x0.95mm_HandSolder; MPN 0603 C0G 50 V; not fitted
D1, D2: SS34; D_SMA; MPN SS34 (SMA)
D3: SMAJ26A; D_SMA; MPN SMAJ26A
D4: green; LED_0603_1608Metric_Pad1.05x0.95mm_HandSolder; MPN Lite-On LTST-C191KGKT
ENC1: EC11; RotaryEncoder_Alps_EC11E-Switch_Vertical_H20mm; MPN EC11 encoder with push switch, 20 mm sh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
FB1: 0R; L_0603_1608Metric_Pad1.05x0.95mm_HandSolder; MPN 0603 0R (or Murata BLM18PG121SN1D)
FB2, FB3: 0R; L_0603_1608Metric_Pad1.05x0.95mm_HandSolder; MPN 0603 0R (or Murata BLM18PG121SN1D); not fitted
H1, H2, H3, H4: M3; MountingHole_3.2mm_M3
J1: DC 7-24 V; BarrelJack_CUI_PJ-063AH_Horizontal; MPN CUI PJ-063AH (5.5 x 2.1 mm, centre +)
J2: Antenna A; SMA_Molex_73251-2120_EdgeMount_Horizontal; MPN Molex 73251-2120 SMA edge-mount jack, 1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
J3: Antenna B; SMA_Molex_73251-2120_EdgeMount_Horizontal; MPN Molex 73251-2120 SMA edge-mount jack, 1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
J4: 2.4 GHz; U.FL_Hirose_U.FL-R-SMT-1_Vertical; MPN Hirose U.FL-R-SMT-1(10); not fitted
J5: OLED; PinSocket_1x04_P2.54mm_Vertical; MPN 1x4 female socket for a 1.3 in 128x64 I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
J6: Radio 2 antenna; SMA_Molex_73251-2120_EdgeMount_Horizontal; MPN Molex 73251-2120 SMA edge-mount jack, 1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; not fitted
J7: Radio 3 antenna; SMA_Molex_73251-2120_EdgeMount_Horizontal; MPN Molex 73251-2120 SMA edge-mount jack, 1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; not fitted
L1: 4.7u; L_Bourns-SRN4018; MPN 4.7 uH, 2.5 A, 4x4 mm (Bourns SRN4018-4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
L2: 0; R_0603_1608Metric_Pad0.98x0.95mm_HandSolder; MPN 0603 0R or RF inductor
L3, L4, L6: 0; R_0603_1608Metric_Pad0.98x0.95mm_HandSolder; MPN 0603 0R or RF inductor; not fitted
LED1, LED2, LED3, LED4, LED5, LED6, LED7, LED8, LED9, LED10, LED11, LED12: WS2812B-Mini; LED_WS2812B-Mini-V3J_3.5x3.5mm; MPN Worldsemi WS2812B-Mini-V3J
R1, R2: 4.7k; R_0603_1608Metric_Pad0.98x0.95mm_HandSolder; MPN 0603 1%; not fitted
R3, R9, R10: 1k; R_0603_1608Metric_Pad0.98x0.95mm_HandSolder; MPN 0603 1%
R4, R5, R6, R7: 470; R_0603_1608Metric_Pad0.98x0.95mm_HandSolder; MPN 0603 1%
R8: 100k; R_0603_1608Metric_Pad0.98x0.95mm_HandSolder; MPN 0603 1%
R11, R12, R13: 10k; R_0603_1608Metric_Pad0.98x0.95mm_HandSolder; MPN 0603 1%
R14: 33; R_0603_1608Metric_Pad0.98x0.95mm_HandSolder; MPN 0603 1%
R15, R16, R17, R18, R21, R22, R23, R24: 470; R_0603_1608Metric_Pad0.98x0.95mm_HandSolder; MPN 0603 1%; not fitted
R19, R25: 100k; R_0603_1608Metric_Pad0.98x0.95mm_HandSolder; MPN 0603 1%; not fitted
SW1: Talk 1; SW_PUSH-12mm; MPN 12 x 12 mm tactile switch with round cap
SW2: Talk 2; SW_PUSH-12mm; MPN 12 x 12 mm tactile switch with round cap
SW3: Talk 3; SW_PUSH-12mm; MPN 12 x 12 mm tactile switch with round cap
SW4: Talk 4; SW_PUSH-12mm; MPN 12 x 12 mm tactile switch with round cap
SW5: Menu; SW_PUSH_6mm; MPN 6 x 6 mm tactile switch, 13 mm tall
SW6: Back; SW_PUSH_6mm; MPN 6 x 6 mm tactile switch, 13 mm tall
TP2: NANO_3V3; TestPoint_Pad_D1.0mm
TP3: VIN; TestPoint_Pad_D1.0mm
TP4: 5V; TestPoint_Pad_D1.0mm
TP5: 3V3; TestPoint_Pad_D1.0mm
TP6: GND; TestPoint_Pad_D1.0mm
U1: ESP32-P4-NANO; ESP32-P4-NANO_Sockets; MPN Waveshare ESP32-P4-NANO (SKU 29026) on 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
U2: AP63205WU; TSOT-23-6; MPN Diodes AP63205WU-7
U3: TLV75733; SOT-23-5; MPN TI TLV75733PDBVR
U4: LR2021; LR2021_Elecrow_10x10mm; MPN Elecrow LR2021 module (LMM16121D)
U5: PE4259; SOT-363_SC-70-6; MPN pSemi PE4259-63
U6: TCA9555PWR; TSSOP-24_4.4x7.8mm_P0.65mm; MPN TI TCA9555PWR
U7: 74AHCT1G125; SOT-23-5; MPN 74AHCT1G125 (SOT-23-5)
U10, U11: LR2021; LR2021_Elecrow_10x10mm; MPN Elecrow LR2021 module (LMM16121D); not fitted

Connections:
+3V3: C7.1, C8.1, C19.1, C20.1, D4.2 (A), FB1.1, FB2.1, FB3.1, J5.2, R1.1, R2.1, R8.1, R10.1, R11.1, R12.1, R13.1, R19.1, R25.1, TP5.1, U3.5 (OUT), U6.21 (A0), U6.24 (VCC)
/+5V: C5.1, C6.1, C25.1, C26.1, C27.1, C28.1, C29.1, C30.1, C31.1, C32.1, C33.1, C34.1, C35.1, C36.1, C37.1, D2.1 (K), LED1.1 (VDD), LED2.1 (VDD), LED3.1 (VDD), LED4.1 (VDD), LED5.1 (VDD), LED6.1 (VDD), LED7.1 (VDD), LED8.1 (VDD), LED9.1 (VDD), LED10.1 (VDD), LED11.1 (VDD), LED12.1 (VDD), TP4.1, U1.L2 (5V), U1.L4 (5V), U1.R1 (5V), U3.1 (IN), U3.3 (EN), U7.5 (VCC)
/BUCK_BST: C2.1, U2.6 (BST)
/BUCK_OUT: C3.1, C4.1, D2.2 (A), L1.2, U2.1 (FB)
/BUCK_SW: C2.2, L1.1, U2.5 (SW)
/ENC_A: C21.1, ENC1.A, R12.2, U1.L18 (GPIO24)
/ENC_B: C22.1, ENC1.B, R13.2, U1.L19 (GPIO25)
/ENC_SW: ENC1.S1, U6.10 (P06)
/EXP_INT_N: R11.2, U1.L21 (GPIO26), U6.1 (~INT)
/I2C_SCL: J5.3, R2.2, U1.L5 (GPIO8/SCL), U6.22 (SCL)
/I2C_SDA: J5.4, R1.2, U1.L3 (GPIO7/SDA), U6.23 (SDA)
/KEY1: SW1.2, U6.4 (P00)
/KEY2: SW2.2, U6.5 (P01)
/KEY3: SW3.2, U6.6 (P02)
/KEY4: SW4.2, U6.7 (P03)
/KEY_BACK: SW6.2, U6.9 (P05)
/KEY_MENU: SW5.2, U6.8 (P04)
/LED_D0: R14.1, U7.4
/LED_D1: LED1.4 (DIN), R14.2
/LED_D2: LED1.2 (DOUT), LED2.4 (DIN)
/LED_D3: LED2.2 (DOUT), LED3.4 (DIN)
/LED_D4: LED3.2 (DOUT), LED4.4 (DIN)
/LED_D5: LED4.2 (DOUT), LED5.4 (DIN)
/LED_D6: LED5.2 (DOUT), LED6.4 (DIN)
/LED_D7: LED6.2 (DOUT), LED7.4 (DIN)
/LED_D8: LED7.2 (DOUT), LED8.4 (DIN)
/LED_D9: LED8.2 (DOUT), LED9.4 (DIN)
/LED_D10: LED9.2 (DOUT), LED10.4 (DIN)
/LED_D11: LED10.2 (DOUT), LED11.4 (DIN)
/LED_D12: LED11.2 (DOUT), LED12.4 (DIN)
/LED_DIN: U1.L23 (GPIO32), U7.2
/LR2_BUSY: U1.R15 (GPIO47), U10.9 (BUSY)
/LR2_DIO5: U6.16 (P13), U10.8 (DIO5)
/LR2_DIO6: U1.R16 (GPIO48), U10.7 (DIO6)
/LR2_MISO_M: R18.2, U10.5 (MISO)
/LR2_MOSI_M: R17.2, U10.4 (MOSI)
/LR2_NRESET: R19.2, U6.15 (P12), U10.10 (NRESET)
/LR2_NSS: R15.1, U1.R17 (GPIO46)
/LR2_NSS_M: R15.2, U10.2 (NSS)
/LR2_SCK_M: R16.2, U10.3 (SCK)
/LR2_TXRX_EN: U6.17 (P14), U10.15 (TX/RX_EN)
/LR2_VDD: C38.1, C39.1, C40.1, FB2.2, U10.1 (VDD)
/LR3_BUSY: U1.L22 (GPIO27), U11.9 (BUSY)
/LR3_DIO5: U6.19 (P16), U11.8 (DIO5)
/LR3_DIO6: U1.R11 (GPIO2), U11.7 (DIO6)
/LR3_MISO_M: R24.2, U11.5 (MISO)
/LR3_MOSI_M: R23.2, U11.4 (MOSI)
/LR3_NRESET: R25.2, U6.18 (P15), U11.10 (NRESET)
/LR3_NSS: R21.1, U1.L24 (GPIO33)
/LR3_NSS_M: R21.2, U11.2 (NSS)
/LR3_SCK_M: R22.2, U11.3 (SCK)
/LR3_TXRX_EN: U6.20 (P17), U11.15 (TX/RX_EN)
/LR3_VDD: C47.1, C48.1, C49.1, FB3.2, U11.1 (VDD)
/LR_BUSY: U1.L11 (GPIO5), U4.9 (BUSY)
/LR_DIO5: U4.8 (DIO5), U6.13 (P10)
/LR_DIO6: U1.L12 (GPIO4), U4.7 (DIO6)
/LR_MISO: R7.1, R18.1, R24.1, U1.L7 (GPIO23)
/LR_MISO_M: R7.2, U4.5 (MISO)
/LR_MOSI: R6.1, R17.1, R23.1, U1.L16 (GPIO22)
/LR_MOSI_M: R6.2, U4.4 (MOSI)
/LR_NRESET: R8.2, U1.R9 (GPIO3), U4.10 (NRESET)
/LR_NSS: R4.1, U1.L13 (GPIO20)
/LR_NSS_M: R4.2, U4.2 (NSS)
/LR_SCK: R5.1, R16.1, R22.1, U1.L15 (GPIO21)
/LR_SCK_M: R5.2, U4.3 (SCK)
/LR_TXRX_EN: U4.15 (TX/RX_EN), U6.14 (P11)
/LR_VDD: C9.1, C10.1, C11.1, FB1.2, U4.1 (VDD)
/NANO_3V3: TP2.1, U1.L1 (3V3), U1.L17 (3V3), U1.R5 (3V3)
/PWR_LED_K: D4.1 (K), R3.1
/RF2_ANT: C43.2, J6.1 (In)
/RF2_LF: C41.1, L4.1, U10.11 (ANT_LF)
/RF2_LF_M: C42.1, C43.1, L4.2
/RF3_ANT: C52.2, J7.1 (In)
/RF3_LF: C50.1, L6.1, U11.11 (ANT_LF)
/RF3_LF_M: C51.1, C52.1, L6.2
/RF_ANT_A: C16.2, J2.1 (In)
/RF_ANT_B: C17.2, J3.1 (In)
/RF_CTRL: R9.1, U6.11 (P07)
/RF_CTRL_S: R9.2, U5.4 (CTRL)
/RF_HF: L3.1, U4.17 (ANT_HF)
/RF_HF_M: C18.1, J4.1 (In), L3.2
/RF_LF: C12.1, L2.1, U4.11 (ANT_LF)
/RF_LF_M: C13.1, C14.1, L2.2
/RF_SW_1: C16.1, U5.1 (RF1)
/RF_SW_2: C17.1, U5.3 (RF2)
/RF_SW_C: C14.2, U5.5 (RFC)
/RF_SW_VDD: C15.1, R10.2, U5.6 (VDD)
/VIN: C1.1, D1.1 (K), D3.1 (A1), TP3.1, U2.2 (EN), U2.3 (IN)
/VIN_RAW: D1.2 (A), J1.1
GND: C1.2, C3.2, C4.2, C5.2, C6.2, C7.2, C8.2, C9.2, C10.2, C11.2, C12.2, C13.2, C15.2, C18.2, C19.2, C20.2, C21.2, C22.2, C25.2, C26.2, C27.2, C28.2, C29.2, C30.2, C31.2, C32.2, C33.2, C34.2, C35.2, C36.2, C37.2, C38.2, C39.2, C40.2, C41.2, C42.2, C47.2, C48.2, C49.2, C50.2, C51.2, D3.2 (A2), ENC1.C, ENC1.S2, J1.2, J1.MP (MountPin), J2.2 (Ext), J3.2 (Ext), J4.2 (Ext), J5.1, J6.2 (Ext), J7.2 (Ext), LED1.3 (VSS), LED2.3 (VSS), LED3.3 (VSS), LED4.3 (VSS), LED5.3 (VSS), LED6.3 (VSS), LED7.3 (VSS), LED8.3 (VSS), LED9.3 (VSS), LED10.3 (VSS), LED11.3 (VSS), LED12.3 (VSS), R3.2, SW1.1, SW2.1, SW3.1, SW4.1, SW5.1, SW6.1, TP6.1, U1.L6 (GND), U1.L9 (GND), U1.L14 (GND), U1.L20 (GND), U1.L25 (GND), U1.R3 (GND), U1.R4 (GND), U1.R7 (GND), U1.R10 (GND), U1.R18 (GND), U1.R25 (GND), U1.R26 (GND), U2.4 (GND), U3.2 (GND), U4.6 (GND), U4.12 (GND), U4.13 (GND), U4.14 (GND), U4.18 (GND), U4.19 (GND), U4.20 (GND), U5.2 (GND), U6.2 (A1), U6.3 (A2), U6.12 (GND), U7.1, U7.3 (GND), U10.6 (GND), U10.12 (GND), U10.13 (GND), U10.14 (GND), U10.18 (GND), U10.19 (GND), U10.20 (GND), U11.6 (GND), U11.12 (GND), U11.13 (GND), U11.14 (GND), U11.18 (GND), U11.19 (GND), U11.20 (GND)

Notes on the sheet:
Waveshare ESP32-P4-NANO on two 2x13 sockets: Ethernet with a PoE module option, USB-C, Wi-Fi 6. Pins it uses itself are left open
DC input (7-24 V) through a 5 V buck into the NANO's 5 V rail (USB-C or PoE also work), 3.3 V LDO for the carrier, mounting holes
LR2021 module, 915 MHz pi match, PE4259 antenna diversity switch, two rear SMA jacks; 2.4 GHz port as a footprint only. Radios 2 and 3: footprints only, one rear SMA each
IO expander (0x21), OLED socket, menu dial, four talk keys, Menu and Back keys, 12 RGB status lights on one data line
OpenTheatreComms base station - carrier PCB

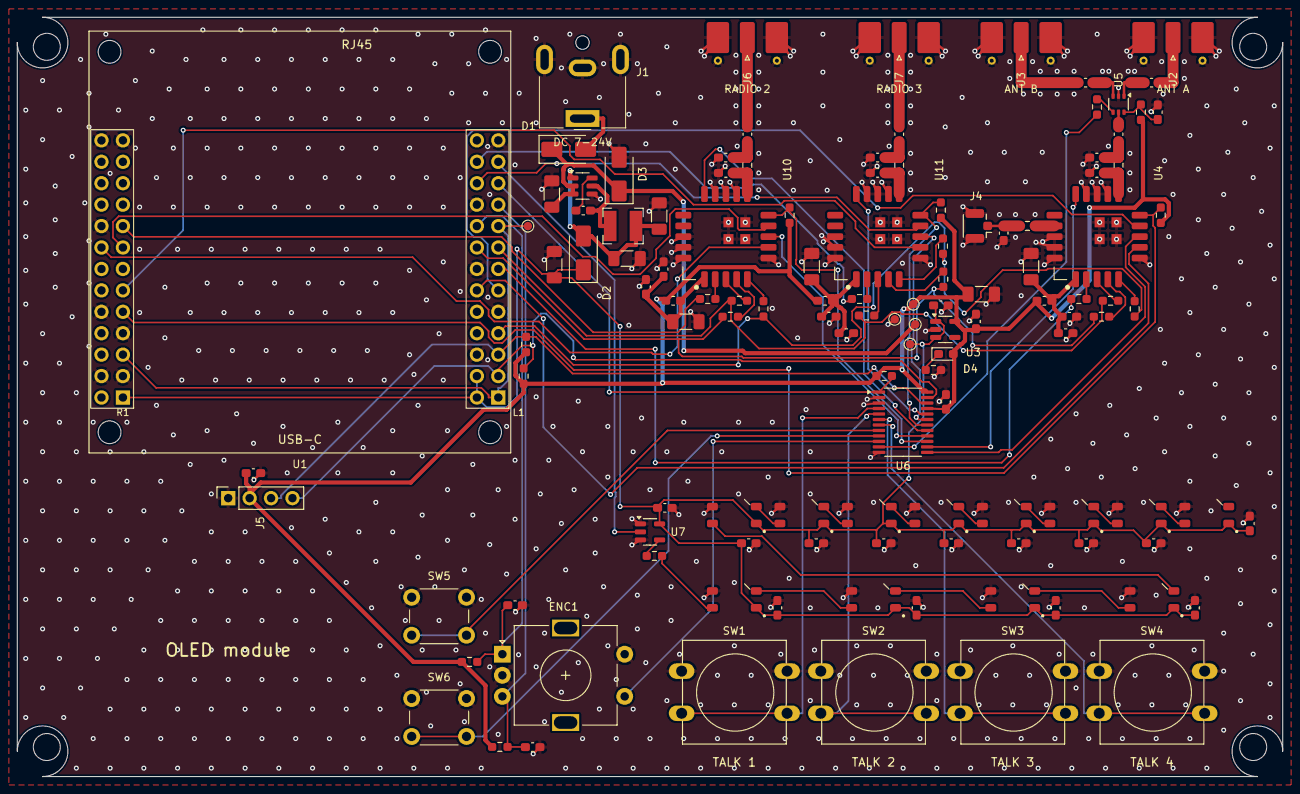
[picture p63: board base_pcb.kicad_pcb from above]

Board: 2 copper layers, 150.0 x 90.0 mm, 127 parts (0 on the bottom side), 90 nets.
