DefeatedWarrior/OpenTheatreComms-Beltpack/kicad/dock_contact_pcb/dock_contact_pcb.kicad_pcb

## KiCad design kicad/dock_contact_pcb/dock_contact_pcb.kicad_pcb (2026-10-31)

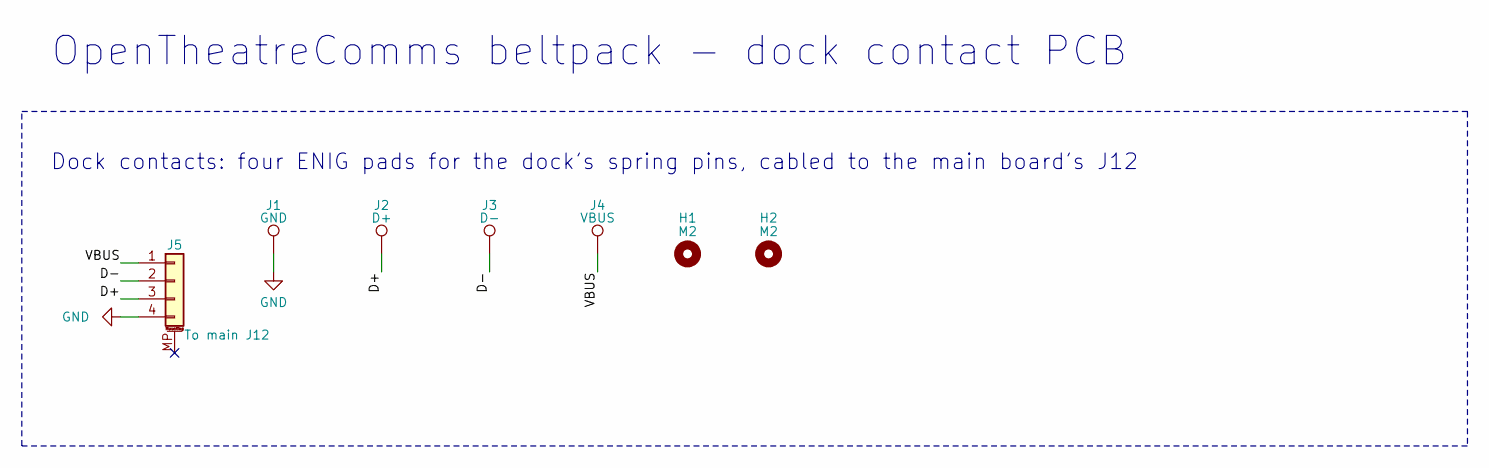
[picture p64: schematic dock_contact_pcb.kicad_sch, Beltpack dock contact PCB]

Parts:
H1, H2: M2; MountingHole_2.2mm_M2
J1: GND; TestPoint_Pad_D2.5mm; MPN PCB pad (ENIG)
J2: D+; TestPoint_Pad_D2.5mm; MPN PCB pad (ENIG)
J3: D-; TestPoint_Pad_D2.5mm; MPN PCB pad (ENIG)
J4: VBUS; TestPoint_Pad_D2.5mm; MPN PCB pad (ENIG)
J5: To main J12; JST_SH_SM04B-SRSS-TB_1x04-1MP_P1.00mm_Horizontal; MPN JST SM04B-SRSS-TB(LF)(SN)

Connections:
D+: J2.1, J5.3
D-: J3.1, J5.2
GND: J1.1, J5.4
VBUS: J4.1, J5.1

Notes on the sheet:
Dock contacts: four ENIG pads for the dock's spring pins, cabled to the main board's J12
OpenTheatreComms beltpack - dock contact PCB

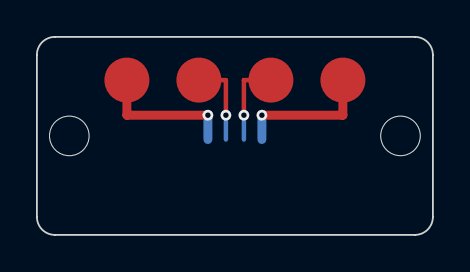
[picture p65: board dock_contact_pcb.kicad_pcb from above]

Board: 2 copper layers, 22.0 x 11.0 mm, 7 parts (1 on the bottom side), 4 nets.
