DefeatedWarrior/OpenTheatreComms-Beltpack/kicad/main_pcb/main_pcb.kicad_pcb

## KiCad design kicad/main_pcb/main_pcb.kicad_pcb (2026-10-31)

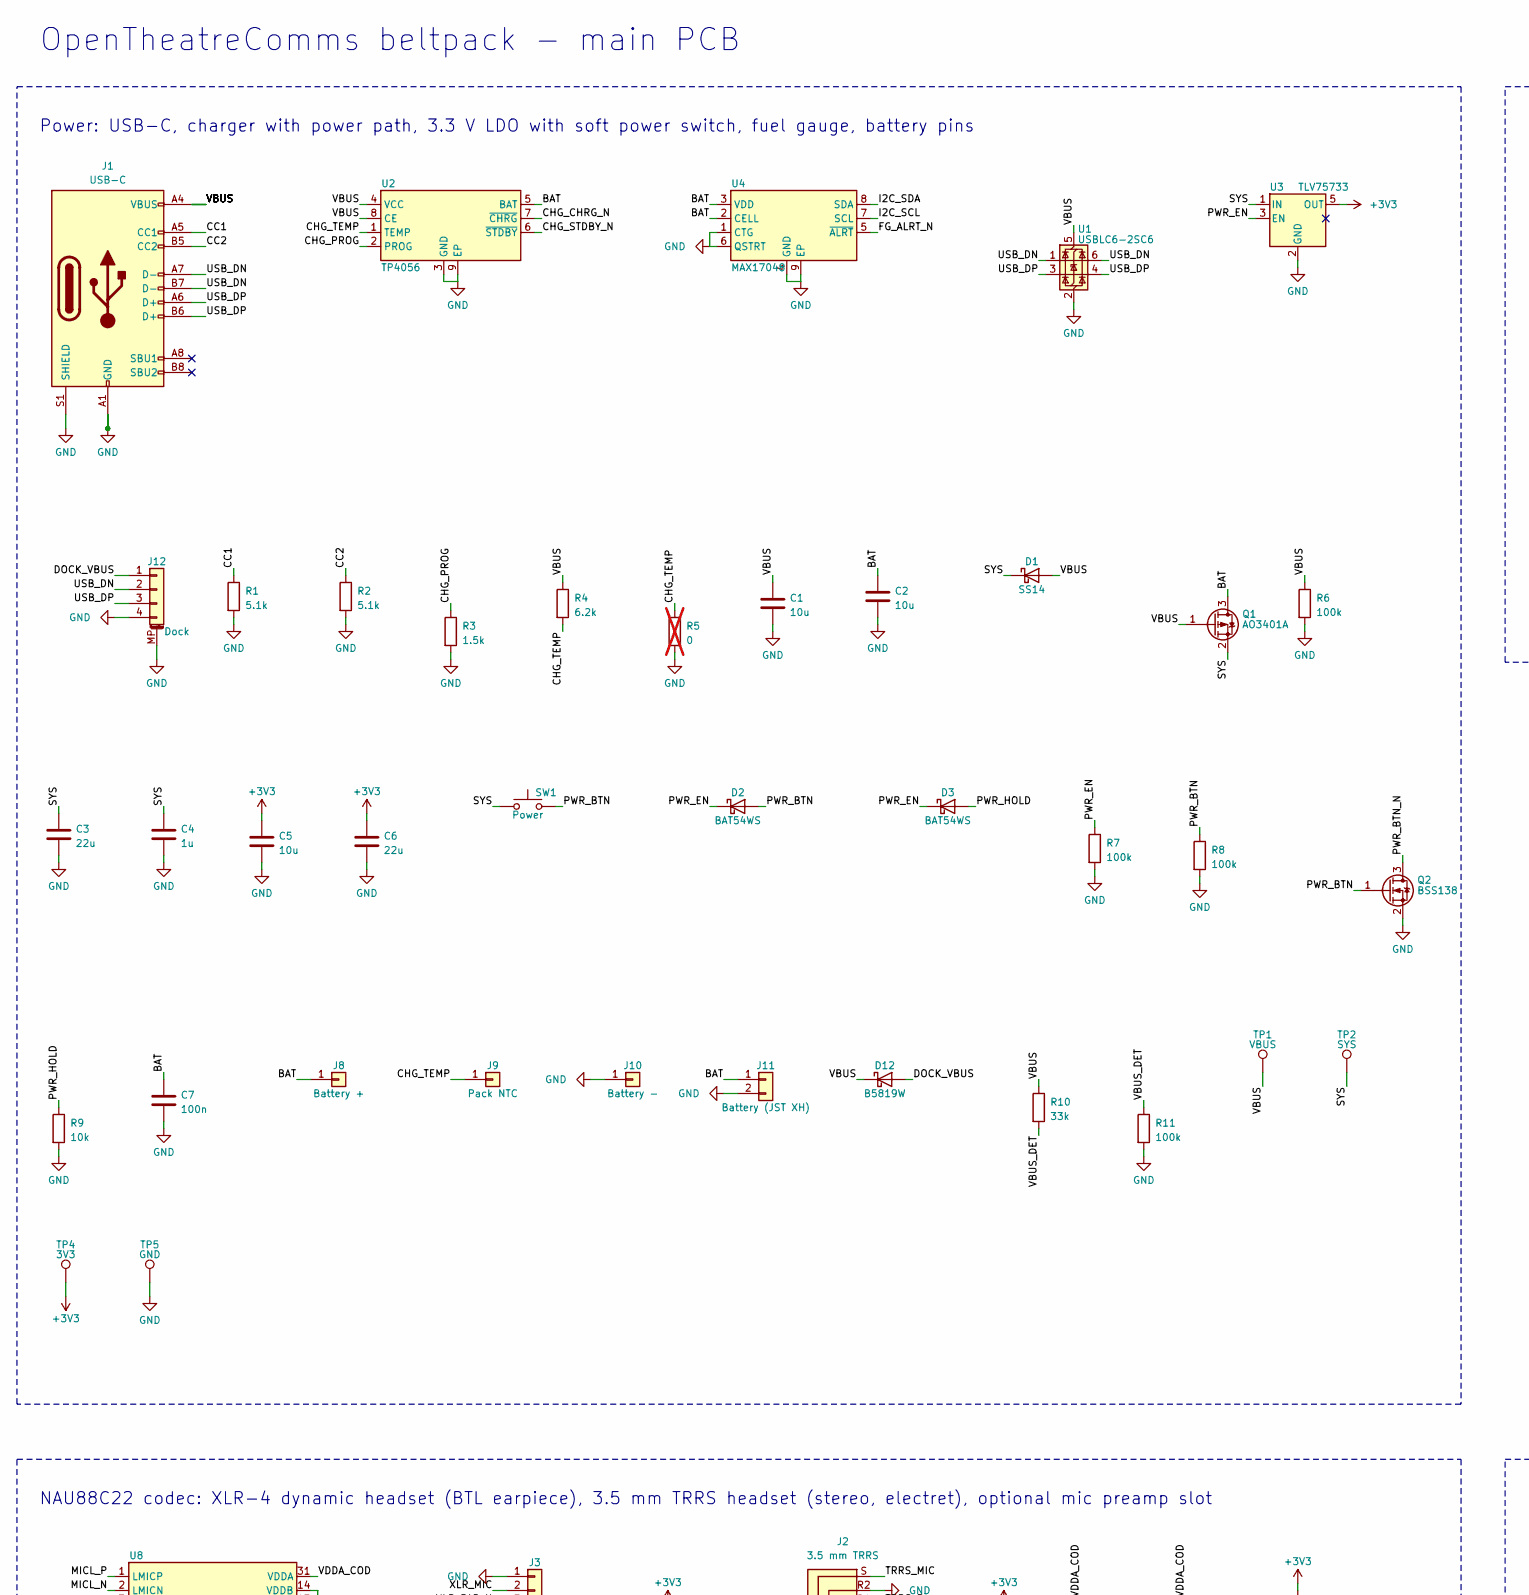
[picture p66: schematic main_pcb.kicad_sch, Beltpack main PCB, part in row 1, column 1]

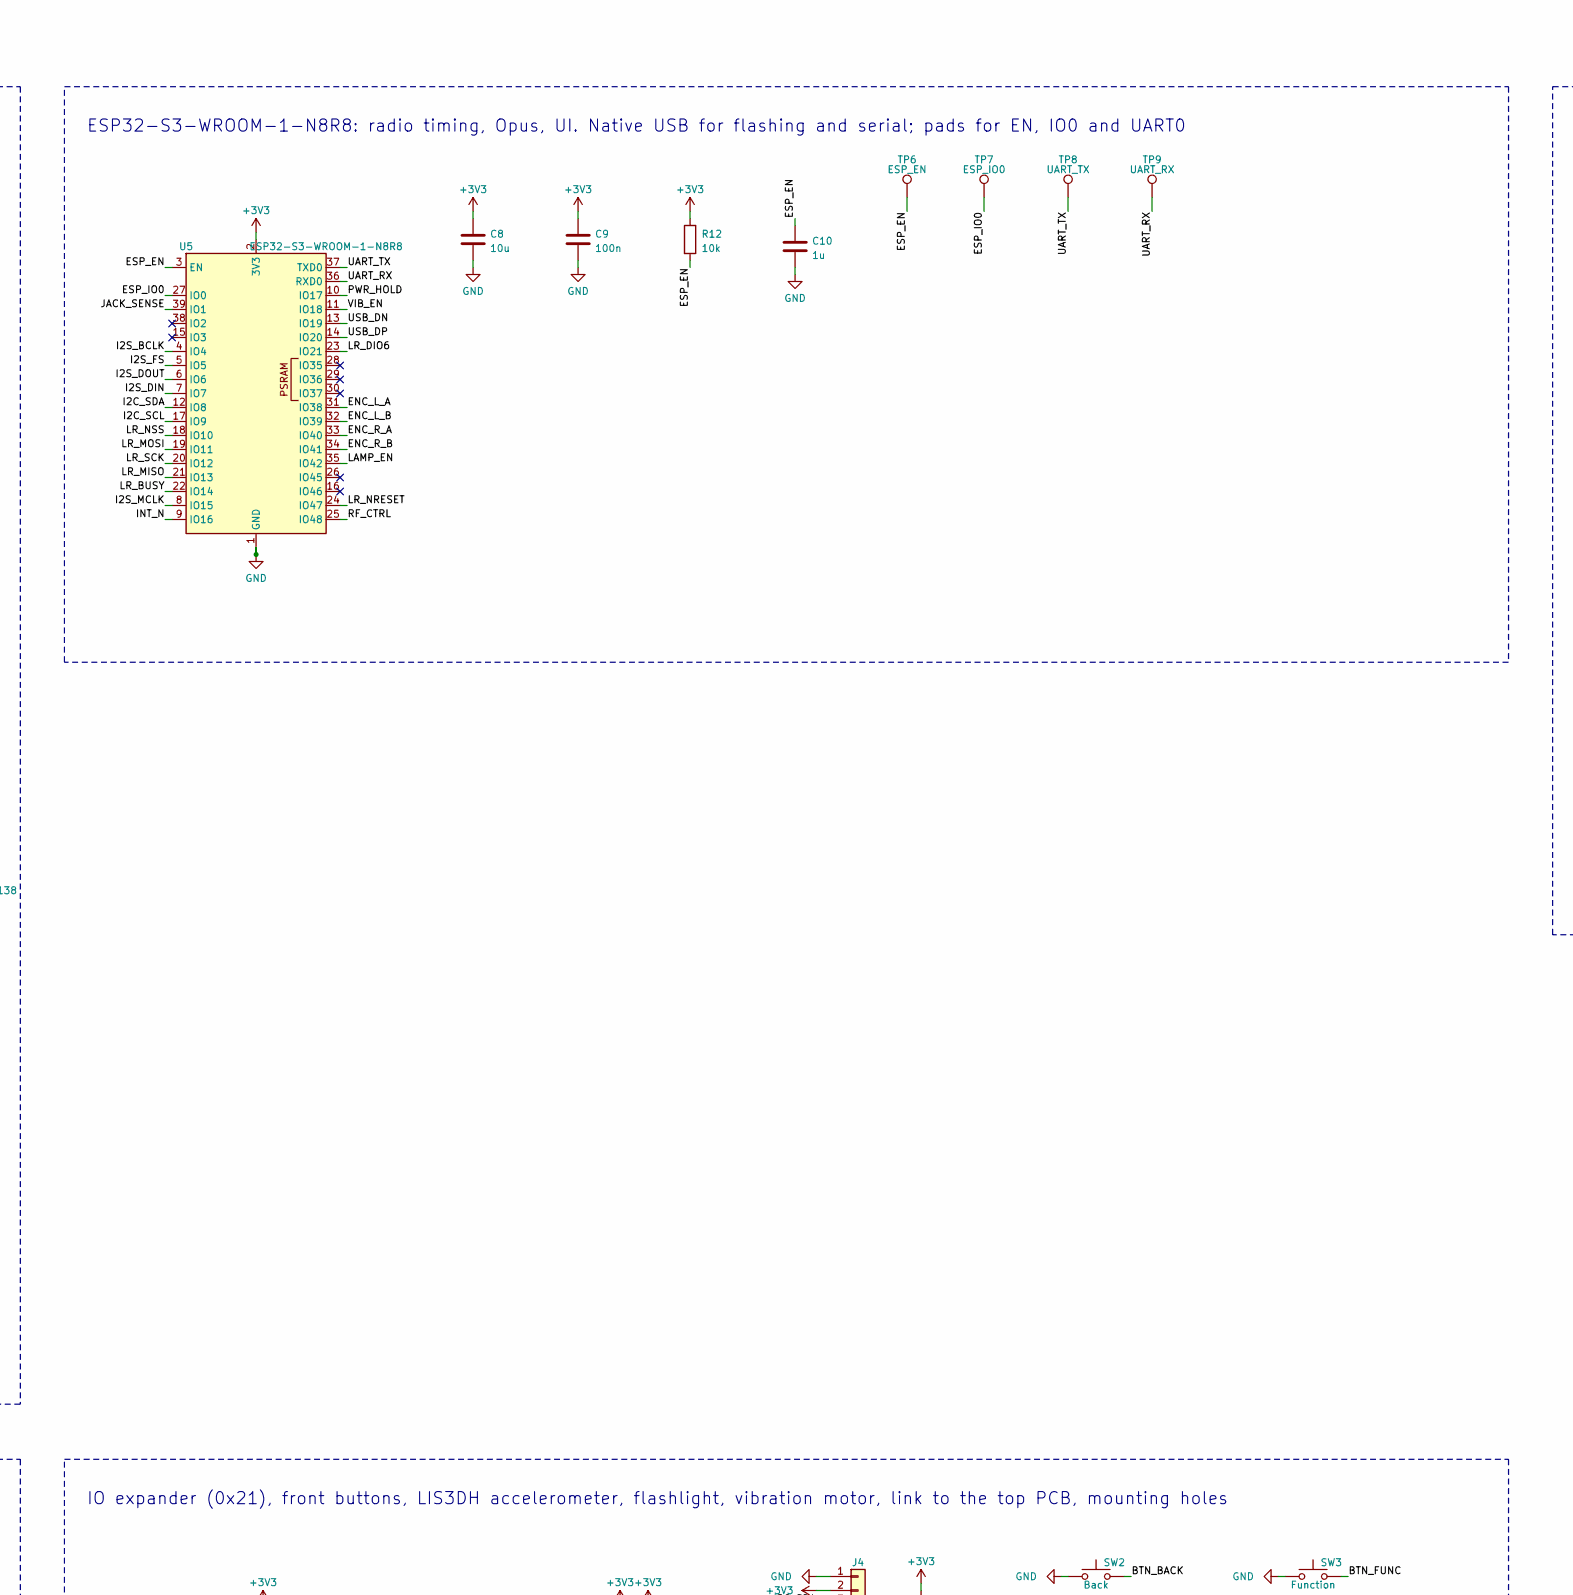
[picture p67: schematic main_pcb.kicad_sch, Beltpack main PCB, part in row 1, column 2]

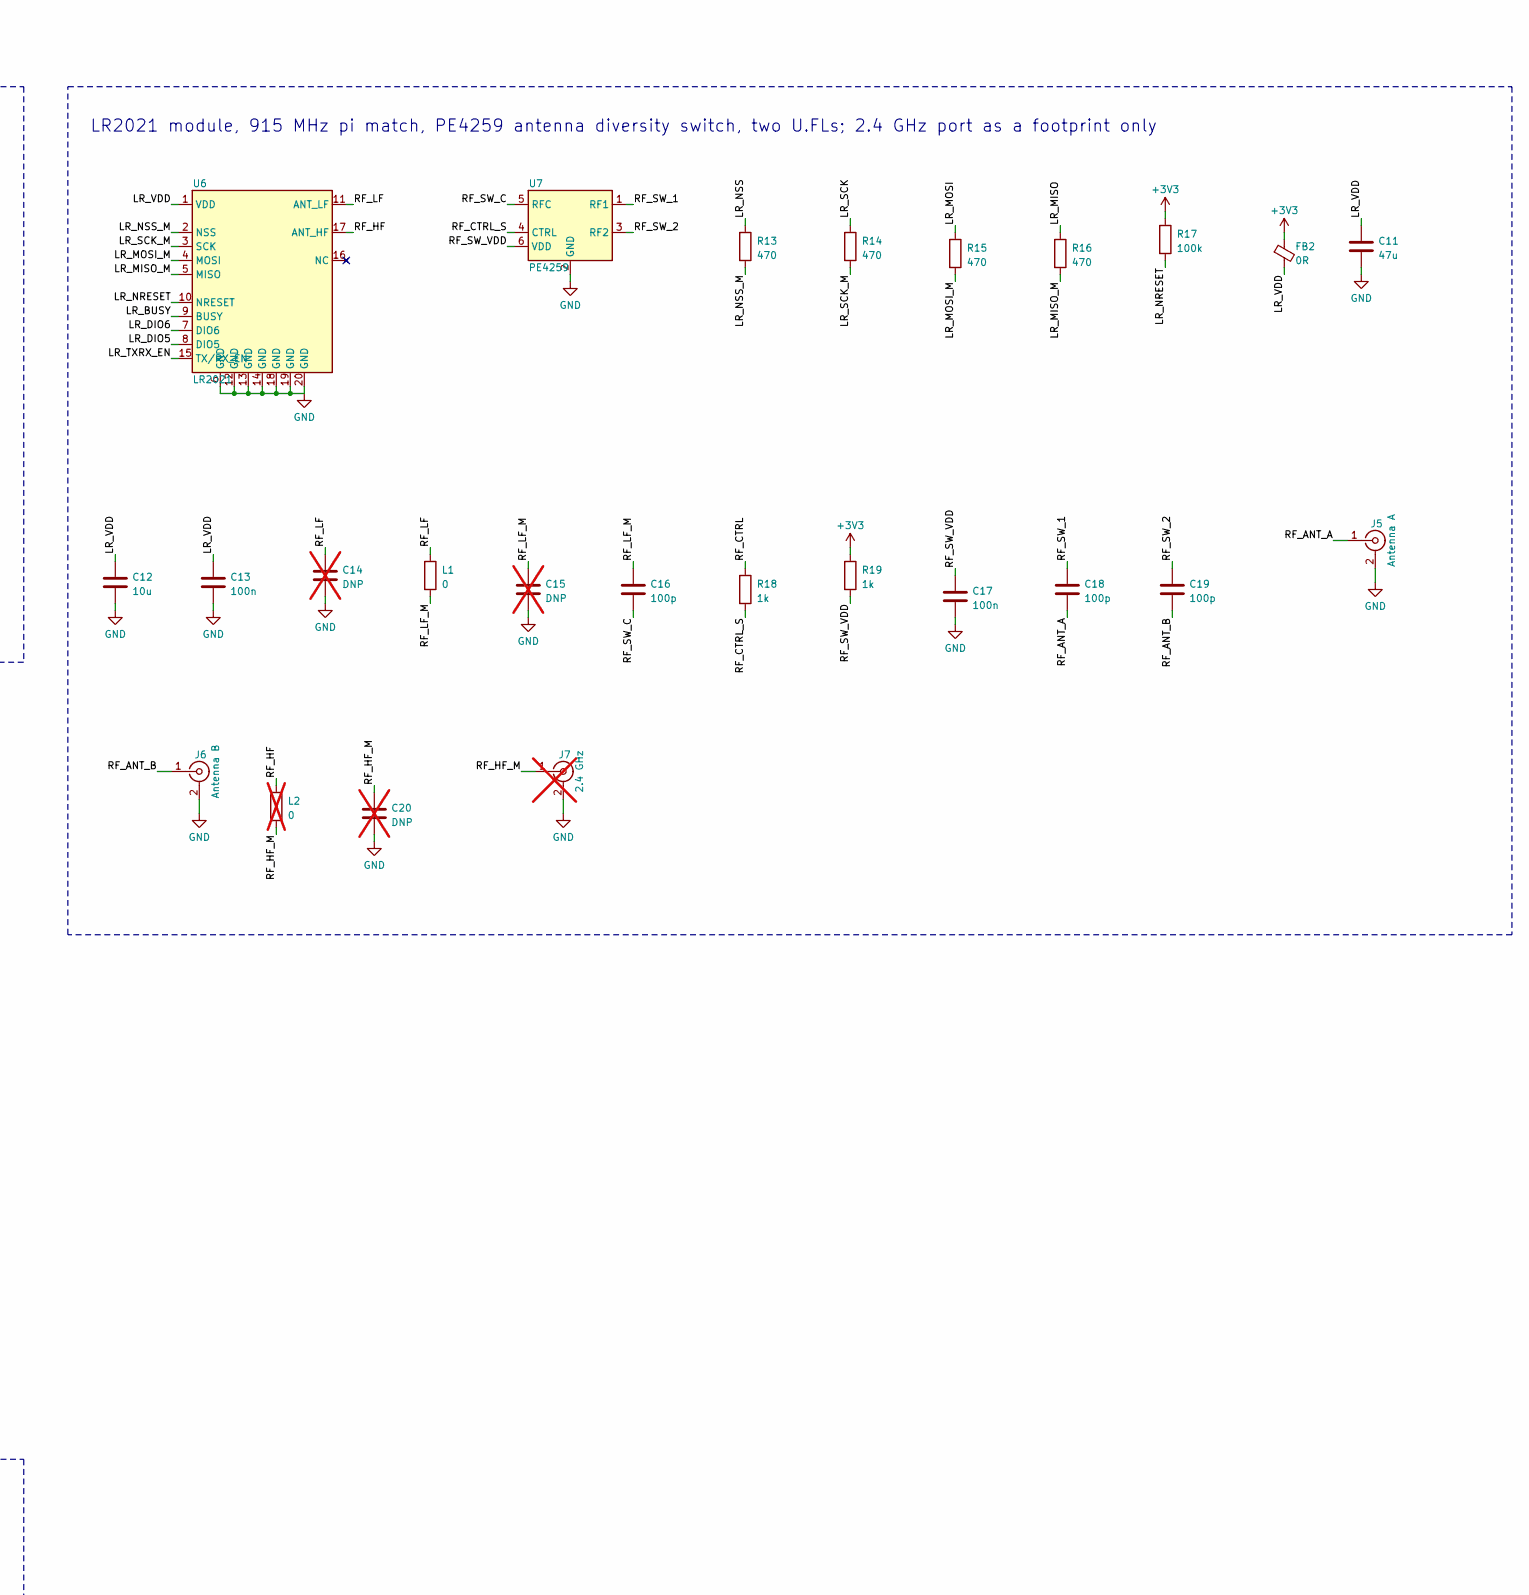
[picture p68: schematic main_pcb.kicad_sch, Beltpack main PCB, part in row 1, column 3]

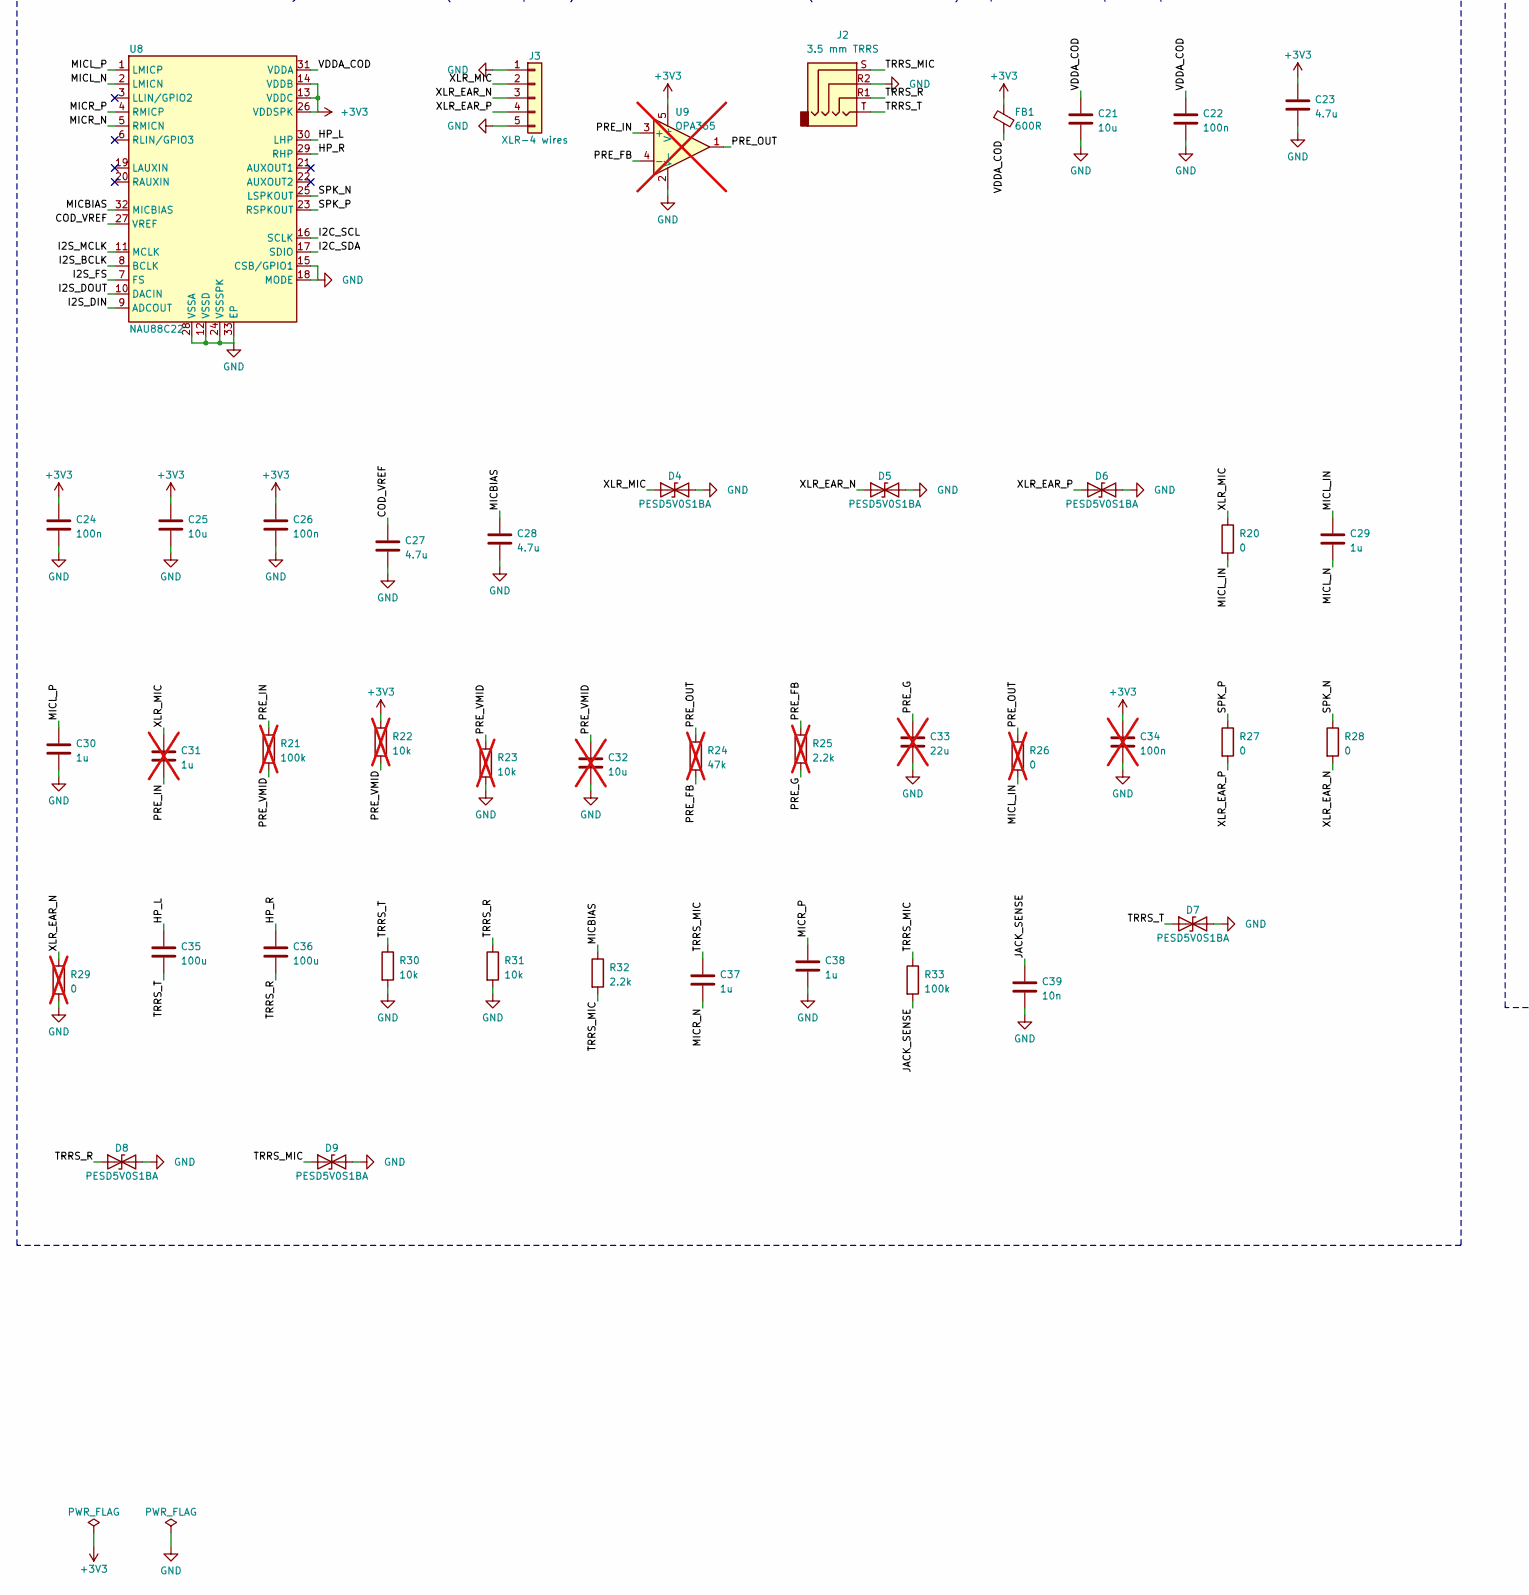
[picture p69: schematic main_pcb.kicad_sch, Beltpack main PCB, part in row 2, column 1]

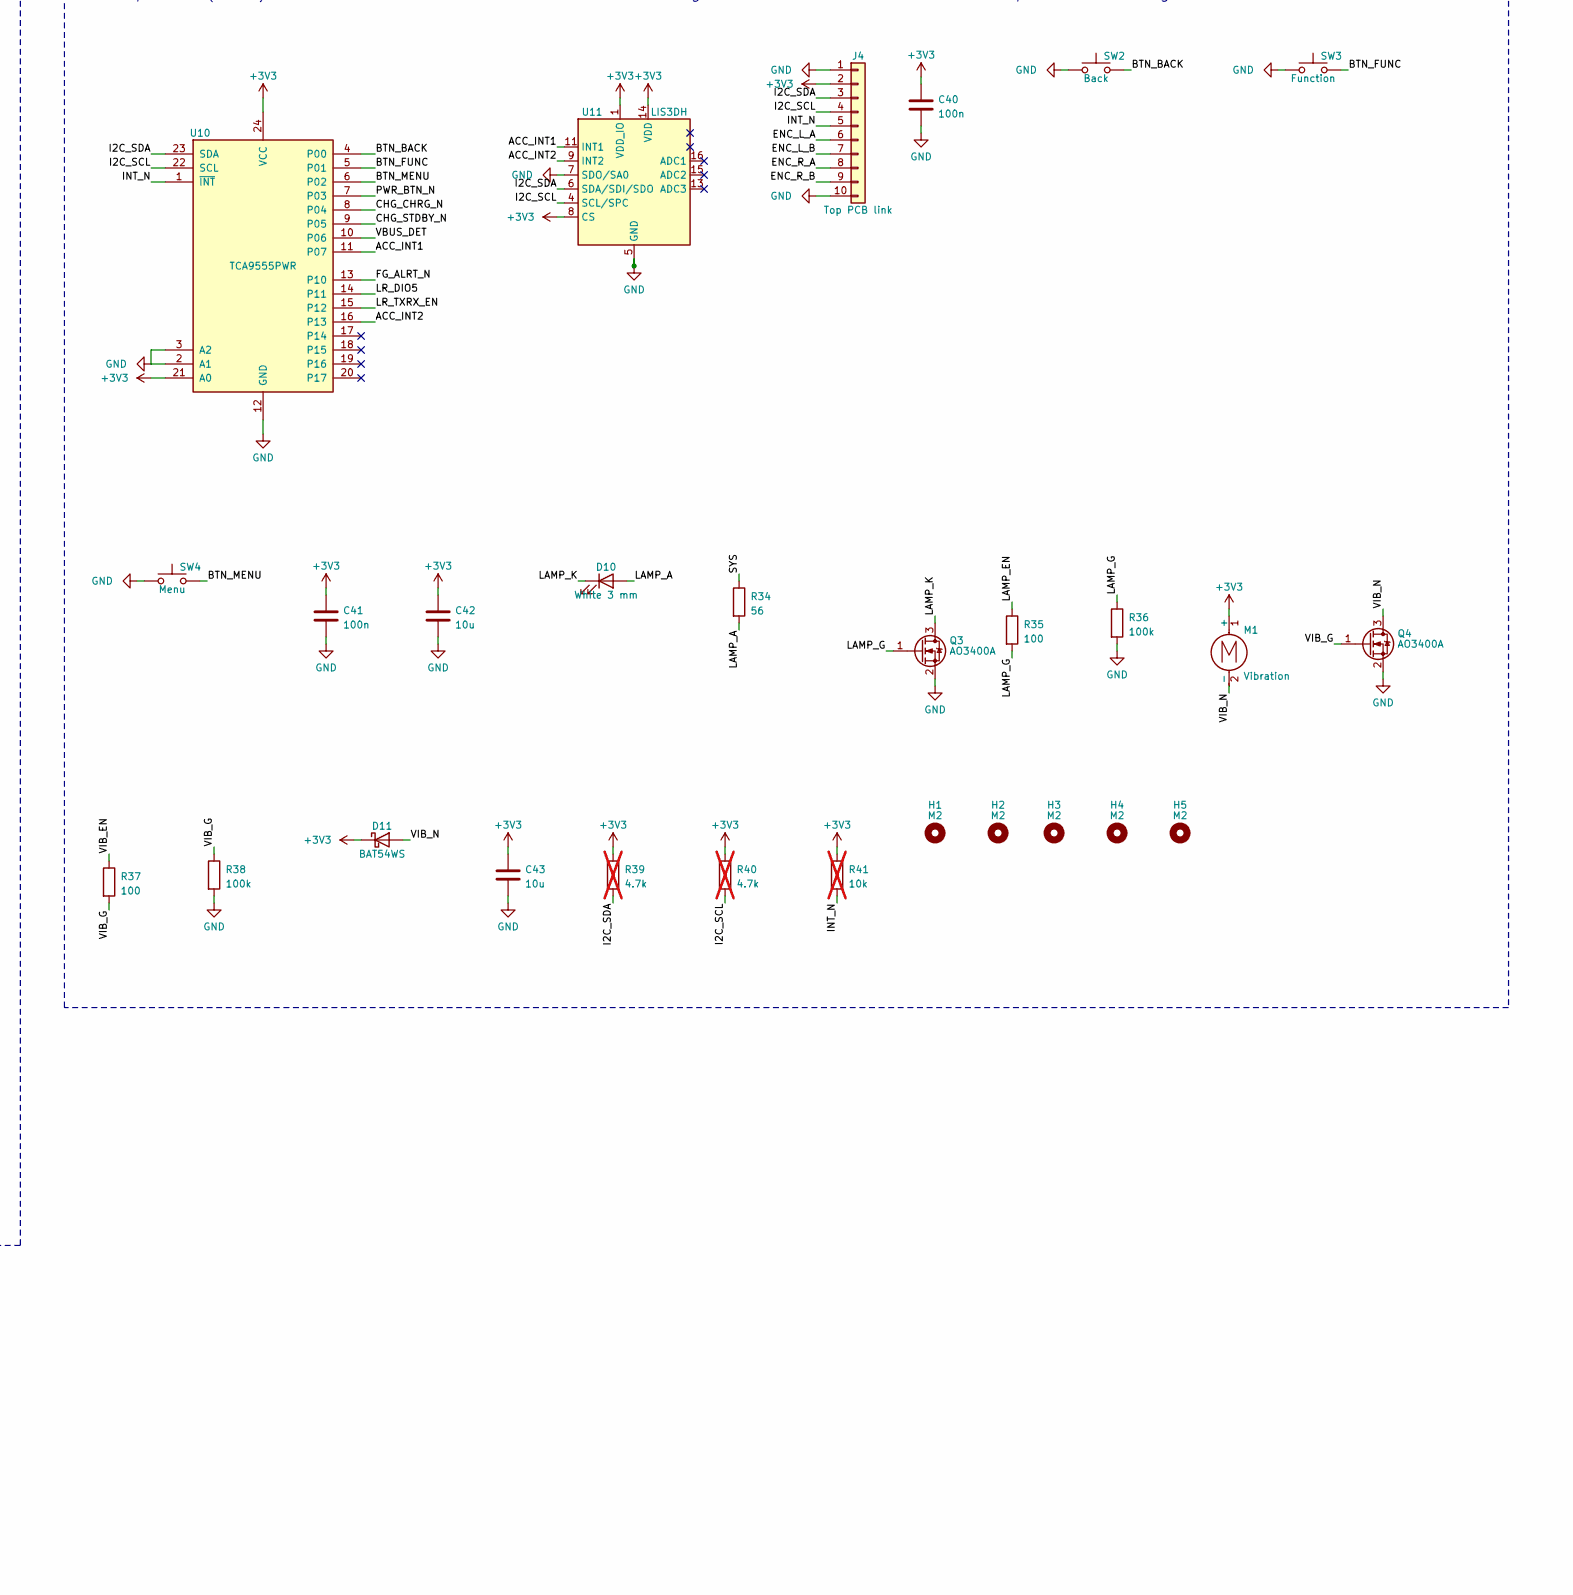
[picture p70: schematic main_pcb.kicad_sch, Beltpack main PCB, part in row 2, column 2]

Parts:
C1, C2, C5, C8, C12, C21, C25, C42, C43: 10u; C_0603_1608Metric_Pad1.08x0.95mm_HandSolder; MPN 0603 X5R 10 V
C3, C6: 22u; C_1206_3216Metric_Pad1.33x1.80mm_HandSolder; MPN 1206 X5R 10 V
C4, C10, C29, C30, C37, C38: 1u; C_0603_1608Metric_Pad1.08x0.95mm_HandSolder; MPN 0603 X5R 10 V
C7, C9, C13, C17, C22, C24, C26, C40, C41: 100n; C_0603_1608Metric_Pad1.08x0.95mm_HandSolder; MPN 0603 X7R
C11: 47u; C_1206_3216Metric_Pad1.33x1.80mm_HandSolder; MPN 1206 X5R 6.3 V
C14, C15, C20: DNP; C_0603_1608Metric_Pad1.08x0.95mm_HandSolder; MPN 0603 C0G, tune; not fitted
C16, C18, C19: 100p; C_0603_1608Metric_Pad1.08x0.95mm_HandSolder; MPN 0603 C0G 50 V
C23, C27, C28: 4.7u; C_0603_1608Metric_Pad1.08x0.95mm_HandSolder; MPN 0603 X5R 10 V
C31: 1u; C_0603_1608Metric_Pad1.08x0.95mm_HandSolder; MPN 0603 X5R 10 V; not fitted
C32: 10u; C_0603_1608Metric_Pad1.08x0.95mm_HandSolder; MPN 0603 X5R 10 V; not fitted
C33: 22u; C_1206_3216Metric_Pad1.33x1.80mm_HandSolder; MPN 1206 X5R 6.3 V; not fitted
C34: 100n; C_0603_1608Metric_Pad1.08x0.95mm_HandSolder; MPN 0603 X7R; not fitted
C35, C36: 100u; C_1206_3216Metric_Pad1.33x1.80mm_HandSolder; MPN 1206 X5R 6.3 V
C39: 10n; C_0603_1608Metric_Pad1.08x0.95mm_HandSolder; MPN 0603 X7R
D1: SS14; D_SMA; MPN SS14 (SMA)
D2, D3, D11: BAT54WS; D_SOD-323_HandSoldering; MPN Diodes BAT54WS
D4, D5, D6, D7, D8, D9: PESD5V0S1BA; D_SOD-323_HandSoldering; MPN Nexperia PESD5V0S1BA
D10: White 3 mm; LED_D3.0mm_Horizontal_O1.27mm_Z2.0mm; MPN 3 mm white LED, 20 mA
D12: B5819W; D_SOD-123; MPN B5819W (SOD-123)
FB1: 600R; L_0603_1608Metric_Pad1.05x0.95mm_HandSolder; MPN Murata BLM18PG601SN1D
FB2: 0R; L_0603_1608Metric_Pad1.05x0.95mm_HandSolder; MPN 0603 0R (or Murata BLM18PG121SN1D)
H1, H2, H3, H4, H5: M2; MountingHole_2.2mm_M2
J1: USB-C; USB_C_Receptacle_GCT_USB4105-xx-A_16P_TopMnt_Horizontal; MPN GCT USB4105-GF-A
J2: 3.5 mm TRRS; Jack_3.5mm_PJ320D_Horizontal; MPN PJ-320D
J3: XLR-4 wires; PinHeader_1x05_P2.54mm_Vertical; MPN Neutrik NC4MD-L-1 (wired)
J4: Top PCB link; JST_SH_SM10B-SRSS-TB_1x10-1MP_P1.00mm_Horizontal; MPN JST SM10B-SRSS-TB
J5: Antenna A; U.FL_Hirose_U.FL-R-SMT-1_Vertical; MPN Hirose U.FL-R-SMT-1(10)
J6: Antenna B; U.FL_Hirose_U.FL-R-SMT-1_Vertical; MPN Hirose U.FL-R-SMT-1(10)
J7: 2.4 GHz; U.FL_Hirose_U.FL-R-SMT-1_Vertical; MPN Hirose U.FL-R-SMT-1(10); not fitted
J8: Battery +; MillMax_0906_SpringPin; MPN Xinyangze YZ08415060P-02
J9: Pack NTC; MillMax_0906_SpringPin; MPN Xinyangze YZ08415060P-02
J10: Battery -; MillMax_0906_SpringPin; MPN Xinyangze YZ08415060P-02
J11: Battery (JST XH); JST_XH_B2B-XH-A_1x02_P2.50mm_Vertical; MPN JST B2B-XH-A(LF)(SN)
J12: Dock; JST_SH_BM04B-SRSS-TB_1x04-1MP_P1.00mm_Vertical; MPN JST BM04B-SRSS-TB(LF)(SN)
L1: 0; R_0603_1608Metric_Pad0.98x0.95mm_HandSolder; MPN 0603 0R or RF inductor
L2: 0; R_0603_1608Metric_Pad0.98x0.95mm_HandSolder; MPN 0603 0R or RF inductor; not fitted
M1: Vibration; Motor_Coin_8mm_LeadPads; MPN 8 x 2.7 mm coin vibration motor, 3 V
Q1: AO3401A; SOT-23; MPN AOS AO3401A
Q2: BSS138; SOT-23; MPN onsemi BSS138
Q3, Q4: AO3400A; SOT-23; MPN AOS AO3400A
R1, R2: 5.1k; R_0603_1608Metric_Pad0.98x0.95mm_HandSolder; MPN 0603 1%
R3: 1.5k; R_0603_1608Metric_Pad0.98x0.95mm_HandSolder; MPN 0603 1%
R4: 6.2k; R_0603_1608Metric_Pad0.98x0.95mm_HandSolder; MPN 0603 1%
R5, R26, R29: 0; R_0603_1608Metric_Pad0.98x0.95mm_HandSolder; MPN 0603 1%; not fitted
R6, R7, R8, R11, R17, R33, R36, R38: 100k; R_0603_1608Metric_Pad0.98x0.95mm_HandSolder; MPN 0603 1%
R9, R12, R30, R31: 10k; R_0603_1608Metric_Pad0.98x0.95mm_HandSolder; MPN 0603 1%
R10: 33k; R_0603_1608Metric_Pad0.98x0.95mm_HandSolder; MPN 0603 1%
R13, R14, R15, R16: 470; R_0603_1608Metric_Pad0.98x0.95mm_HandSolder; MPN 0603 1%
R18, R19: 1k; R_0603_1608Metric_Pad0.98x0.95mm_HandSolder; MPN 0603 1%
R20, R28: 0; R_0603_1608Metric_Pad0.98x0.95mm_HandSolder; MPN 0603 1%
R21: 100k; R_0603_1608Metric_Pad0.98x0.95mm_HandSolder; MPN 0603 1%; not fitted
R22, R23, R41: 10k; R_0603_1608Metric_Pad0.98x0.95mm_HandSolder; MPN 0603 1%; not fitted
R24: 47k; R_0603_1608Metric_Pad0.98x0.95mm_HandSolder; MPN 0603 1%; not fitted
R25: 2.2k; R_0603_1608Metric_Pad0.98x0.95mm_HandSolder; MPN 0603 1%; not fitted
R27: 0; R_1206_3216Metric_Pad1.30x1.75mm_HandSolder; MPN 1206 0R
R32: 2.2k; R_0603_1608Metric_Pad0.98x0.95mm_HandSolder; MPN 0603 1%
R34: 56; R_0603_1608Metric_Pad0.98x0.95mm_HandSolder; MPN 0603 1%
R35, R37: 100; R_0603_1608Metric_Pad0.98x0.95mm_HandSolder; MPN 0603 1%
R39, R40: 4.7k; R_0603_1608Metric_Pad0.98x0.95mm_HandSolder; MPN 0603 1%; not fitted
SW1: Power; SW_Push_1P1T-MP_NO_Horizontal_Alps_SKRTLAE010; MPN Alps SKRTLAE010
SW2: Back; SW_SPST_PTS810; MPN C&K PTS815 SJM 250 SMTR LFS
SW3: Function; SW_SPST_PTS810; MPN C&K PTS815 SJM 250 SMTR LFS
SW4: Menu; SW_SPST_PTS810; MPN C&K PTS815 SJM 250 SMTR LFS
TP1: VBUS; TestPoint_Pad_D1.0mm
TP2: SYS; TestPoint_Pad_D1.0mm
TP4: 3V3; TestPoint_Pad_D1.0mm
TP5: GND; TestPoint_Pad_D1.0mm
TP6: ESP_EN; TestPoint_Pad_D1.0mm
TP7: ESP_IO0; TestPoint_Pad_D1.0mm
TP8: UART_TX; TestPoint_Pad_D1.0mm
TP9: UART_RX; TestPoint_Pad_D1.0mm
U1: USBLC6-2SC6; SOT-23-6; MPN ST USBLC6-2SC6
U2: TP4056; SOIC-8-1EP_3.9x4.9mm_P1.27mm_EP2.29x3mm_ThermalVias; MPN TOPPOWER TP4056 (ESOP-8)
U3: TLV75733; SOT-23-5; MPN TI TLV75733PDBVR
U4: MAX17048; TDFN-8-1EP_2x2mm_P0.5mm_EP0.8x1.2mm; MPN Analog MAX17048G+T10
U5: ESP32-S3-WROOM-1-N8R8; ESP32-S3-WROOM-1; MPN Espressif ESP32-S3-WROOM-1-N8R8
U6: LR2021; LR2021_Elecrow_10x10mm; MPN Elecrow LR2021 module (LMM16121D)
U7: PE4259; SOT-363_SC-70-6; MPN pSemi PE4259-63
U8: NAU88C22; QFN-32-1EP_5x5mm_P0.5mm_EP3.45x3.45mm_ThermalVias; MPN Nuvoton NAU88C22YG
U9: OPA365; SOT-23-5; MPN TI OPA365AIDBVR; not fitted
U10: TCA9555PWR; TSSOP-24_4.4x7.8mm_P0.65mm; MPN TI TCA9555PWR
U11: LIS3DH; LGA-16_3x3mm_P0.5mm; MPN ST LIS3DHTR

Connections:
+3V3: C5.1, C6.1, C8.1, C9.1, C23.1, C24.1, C25.1, C26.1, C34.1, C40.1, C41.1, C42.1, C43.1, D11.1 (K), FB1.1, FB2.1, J4.2, M1.1 (+), R12.1, R17.1, R19.1, R22.1, R39.1, R40.1, R41.1, TP4.1, U3.5 (OUT), U5.2 (3V3), U8.13 (VDDC), U8.14 (VDDB), U8.26 (VDDSPK), U9.5 (V+), U10.21 (A0), U10.24 (VCC), U11.1 (VDD_IO), U11.8 (CS), U11.14 (VDD)
/ACC_INT1: U10.11 (P07), U11.11 (INT1)
/ACC_INT2: U10.16 (P13), U11.9 (INT2)
/BAT: C2.1, C7.1, J8.1, J11.1, Q1.3 (D), U2.5 (BAT), U4.2 (CELL), U4.3 (VDD)
/BTN_BACK: SW2.2, U10.4 (P00)
/BTN_FUNC: SW3.2, U10.5 (P01)
/BTN_MENU: SW4.2, U10.6 (P02)
/CC1: J1.A5 (CC1), R1.1
/CC2: J1.B5 (CC2), R2.1
/CHG_CHRG_N: U2.7 (~CHRG), U10.8 (P04)
/CHG_PROG: R3.1, U2.2 (PROG)
/CHG_STDBY_N: U2.6 (~STDBY), U10.9 (P05)
/CHG_TEMP: J9.1, R4.2, R5.1, U2.1 (TEMP)
/COD_VREF: C27.1, U8.27 (VREF)
/DOCK_VBUS: D12.2 (A), J12.1
/ENC_L_A: J4.6, U5.31 (IO38)
/ENC_L_B: J4.7, U5.32 (IO39)
/ENC_R_A: J4.8, U5.33 (IO40)
/ENC_R_B: J4.9, U5.34 (IO41)
/ESP_EN: C10.1, R12.2, TP6.1, U5.3 (EN)
/ESP_IO0: TP7.1, U5.27 (IO0)
/FG_ALRT_N: U4.5 (~ALRT), U10.13 (P10)
/HP_L: C35.1, U8.30 (LHP)
/HP_R: C36.1, U8.29 (RHP)
/I2C_SCL: J4.4, R40.2, U4.7 (SCL), U5.17 (IO9), U8.16 (SCLK), U10.22 (SCL), U11.4 (SCL/SPC)
/I2C_SDA: J4.3, R39.2, U4.8 (SDA), U5.12 (IO8), U8.17 (SDIO), U10.23 (SDA), U11.6 (SDA/SDI/SDO)
/I2S_BCLK: U5.4 (IO4), U8.8 (BCLK)
/I2S_DIN: U5.7 (IO7), U8.9 (ADCOUT)
/I2S_DOUT: U5.6 (IO6), U8.10 (DACIN)
/I2S_FS: U5.5 (IO5), U8.7 (FS)
/I2S_MCLK: U5.8 (IO15), U8.11 (MCLK)
/INT_N: J4.5, R41.2, U5.9 (IO16), U10.1 (~INT)
/JACK_SENSE: C39.1, R33.2, U5.39 (IO1)
/LAMP_A: D10.2 (A), R34.2
/LAMP_EN: R35.1, U5.35 (IO42)
/LAMP_G: Q3.1 (G), R35.2, R36.1
/LAMP_K: D10.1 (K), Q3.3 (D)
/LR_BUSY: U5.22 (IO14), U6.9 (BUSY)
/LR_DIO5: U6.8 (DIO5), U10.14 (P11)
/LR_DIO6: U5.23 (IO21), U6.7 (DIO6)
/LR_MISO: R16.1, U5.21 (IO13)
/LR_MISO_M: R16.2, U6.5 (MISO)
/LR_MOSI: R15.1, U5.19 (IO11)
/LR_MOSI_M: R15.2, U6.4 (MOSI)
/LR_NRESET: R17.2, U5.24 (IO47), U6.10 (NRESET)
/LR_NSS: R13.1, U5.18 (IO10)
/LR_NSS_M: R13.2, U6.2 (NSS)
/LR_SCK: R14.1, U5.20 (IO12)
/LR_SCK_M: R14.2, U6.3 (SCK)
/LR_TXRX_EN: U6.15 (TX/RX_EN), U10.15 (P12)
/LR_VDD: C11.1, C12.1, C13.1, FB2.2, U6.1 (VDD)
/MICBIAS: C28.1, R32.1, U8.32 (MICBIAS)
/MICL_IN: C29.1, R20.2, R26.2
/MICL_N: C29.2, U8.2 (LMICN)
/MICL_P: C30.1, U8.1 (LMICP)
/MICR_N: C37.2, U8.5 (RMICN)
/MICR_P: C38.1, U8.4 (RMICP)
/PRE_FB: R24.2, R25.1, U9.4 (-)
/PRE_G: C33.1, R25.2
/PRE_IN: C31.2, R21.1, U9.3 (+)
/PRE_OUT: R24.1, R26.1, U9.1
/PRE_VMID: C32.1, R21.2, R22.2, R23.1
/PWR_BTN: D2.2 (A), Q2.1 (G), R8.1, SW1.2
/PWR_BTN_N: Q2.3 (D), U10.7 (P03)
/PWR_EN: D2.1 (K), D3.1 (K), R7.1, U3.3 (EN)
/PWR_HOLD: D3.2 (A), R9.1, U5.10 (IO17)
/RF_ANT_A: C18.2, J5.1 (In)
/RF_ANT_B: C19.2, J6.1 (In)
/RF_CTRL: R18.1, U5.25 (IO48)
/RF_CTRL_S: R18.2, U7.4 (CTRL)
/RF_HF: L2.1, U6.17 (ANT_HF)
/RF_HF_M: C20.1, J7.1 (In), L2.2
/RF_LF: C14.1, L1.1, U6.11 (ANT_LF)
/RF_LF_M: C15.1, C16.1, L1.2
/RF_SW_1: C18.1, U7.1 (RF1)
/RF_SW_2: C19.1, U7.3 (RF2)
/RF_SW_C: C16.2, U7.5 (RFC)
/RF_SW_VDD: C17.1, R19.2, U7.6 (VDD)
/SPK_N: R28.1, U8.25 (LSPKOUT)
/SPK_P: R27.1, U8.23 (RSPKOUT)
/SYS: C3.1, C4.1, D1.1 (K), Q1.2 (S), R34.1, SW1.1, TP2.1, U3.1 (IN)
/TRRS_MIC: C37.1, D9.1 (A1), J2.S, R32.2, R33.1
/TRRS_R: C36.2, D8.1 (A1), J2.R1, R31.1
/TRRS_T: C35.2, D7.1 (A1), J2.T, R30.1
/UART_RX: TP9.1, U5.36 (RXD0)
/UART_TX: TP8.1, U5.37 (TXD0)
/USB_DN: J1.A7 (D-), J1.B7 (D-), J12.2, U1.1 (I/O1), U1.6 (I/O1), U5.13 (IO19)
/USB_DP: J1.A6 (D+), J1.B6 (D+), J12.3, U1.3 (I/O2), U1.4 (I/O2), U5.14 (IO20)
/VBUS: C1.1, D1.2 (A), D12.1 (K), J1.A4 (VBUS), J1.A9 (VBUS), J1.B4 (VBUS), J1.B9 (VBUS), Q1.1 (G), R4.1, R6.1, R10.1, TP1.1, U1.5 (VBUS), U2.4 (VCC), U2.8 (CE)
/VBUS_DET: R10.2, R11.1, U10.10 (P06)
/VDDA_COD: C21.1, C22.1, FB1.2, U8.31 (VDDA)
/VIB_EN: R37.1, U5.11 (IO18)
/VIB_G: Q4.1 (G), R37.2, R38.1
/VIB_N: D11.2 (A), M1.2 (-), Q4.3 (D)
/XLR_EAR_N: D5.1 (A1), J3.3, R28.2, R29.1
/XLR_EAR_P: D6.1 (A1), J3.4, R27.2
/XLR_MIC: C31.1, D4.1 (A1), J3.2, R20.1
GND: C1.2, C2.2, C3.2, C4.2, C5.2, C6.2, C7.2, C8.2, C9.2, C10.2, C11.2, C12.2, C13.2, C14.2, C15.2, C17.2, C20.2, C21.2, C22.2, C23.2, C24.2, C25.2, C26.2, C27.2, C28.2, C30.2, C32.2, C33.2, C34.2, C38.2, C39.2, C40.2, C41.2, C42.2, C43.2, D4.2 (A2), D5.2 (A2), D6.2 (A2), D7.2 (A2), D8.2 (A2), D9.2 (A2), J1.A1 (GND), J1.A12 (GND), J1.B1 (GND), J1.B12 (GND), J1.S1 (SHIELD), J2.R2, J3.1, J3.5, J4.1, J4.10, J5.2 (Ext), J6.2 (Ext), J7.2 (Ext), J10.1, J11.2, J12.4, J12.MP (MountPin), Q2.2 (S), Q3.2 (S), Q4.2 (S), R1.2, R2.2, R3.2, R5.2, R6.2, R7.2, R8.2, R9.2, R11.2, R23.2, R29.2, R30.2, R31.2, R36.2, R38.2, SW2.1, SW3.1, SW4.1, TP5.1, U1.2 (GND), U2.3 (GND), U2.9 (EP), U3.2 (GND), U4.1 (CTG), U4.4 (GND), U4.6 (QSTRT), U4.9 (EP), U5.1 (GND), U5.40 (GND), U5.41 (GND), U6.6 (GND), U6.12 (GND), U6.13 (GND), U6.14 (GND), U6.18 (GND), U6.19 (GND), U6.20 (GND), U7.2 (GND), U8.12 (VSSD), U8.15 (CSB/GPIO1), U8.18 (MODE), U8.24 (VSSSPK), U8.28 (VSSA), U8.33 (EP), U9.2 (V-), U10.2 (A1), U10.3 (A2), U10.12 (GND), U11.5 (GND), U11.7 (SDO/SA0), U11.10 (GND), U11.12 (GND)

Notes on the sheet:
Power: USB-C, charger with power path, 3.3 V LDO with soft power switch, fuel gauge, battery pins
ESP32-S3-WROOM-1-N8R8: radio timing, Opus, UI. Native USB for flashing and serial; pads for EN, IO0 and UART0
LR2021 module, 915 MHz pi match, PE4259 antenna diversity switch, two U.FLs; 2.4 GHz port as a footprint only
NAU88C22 codec: XLR-4 dynamic headset (BTL earpiece), 3.5 mm TRRS headset (stereo, electret), optional mic preamp slot
IO expander (0x21), front buttons, LIS3DH accelerometer, flashlight, vibration motor, link to the top PCB, mounting holes
OpenTheatreComms beltpack - main PCB

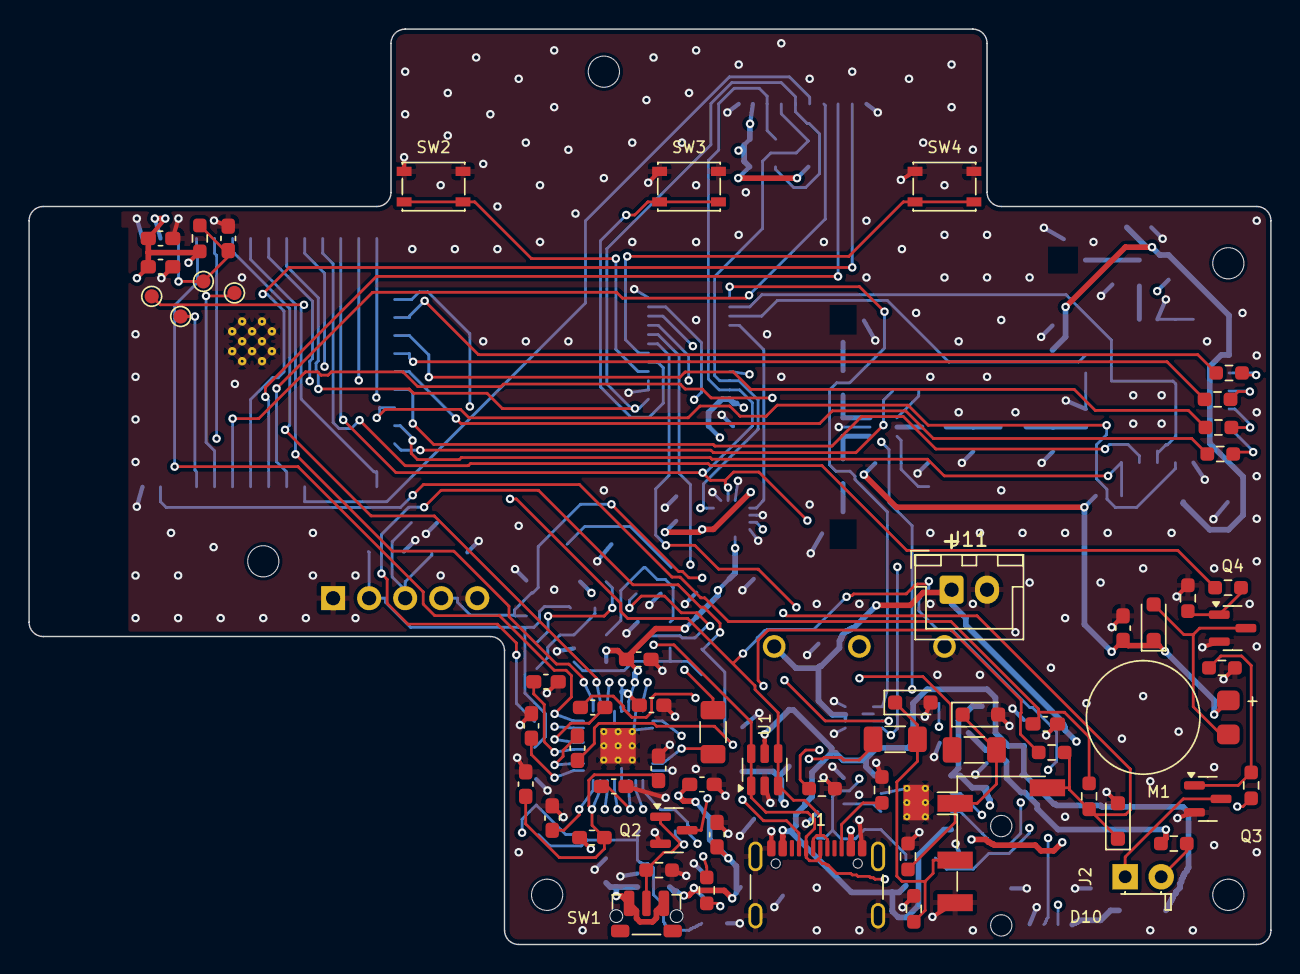
[picture p71: board main_pcb.kicad_pcb from above]

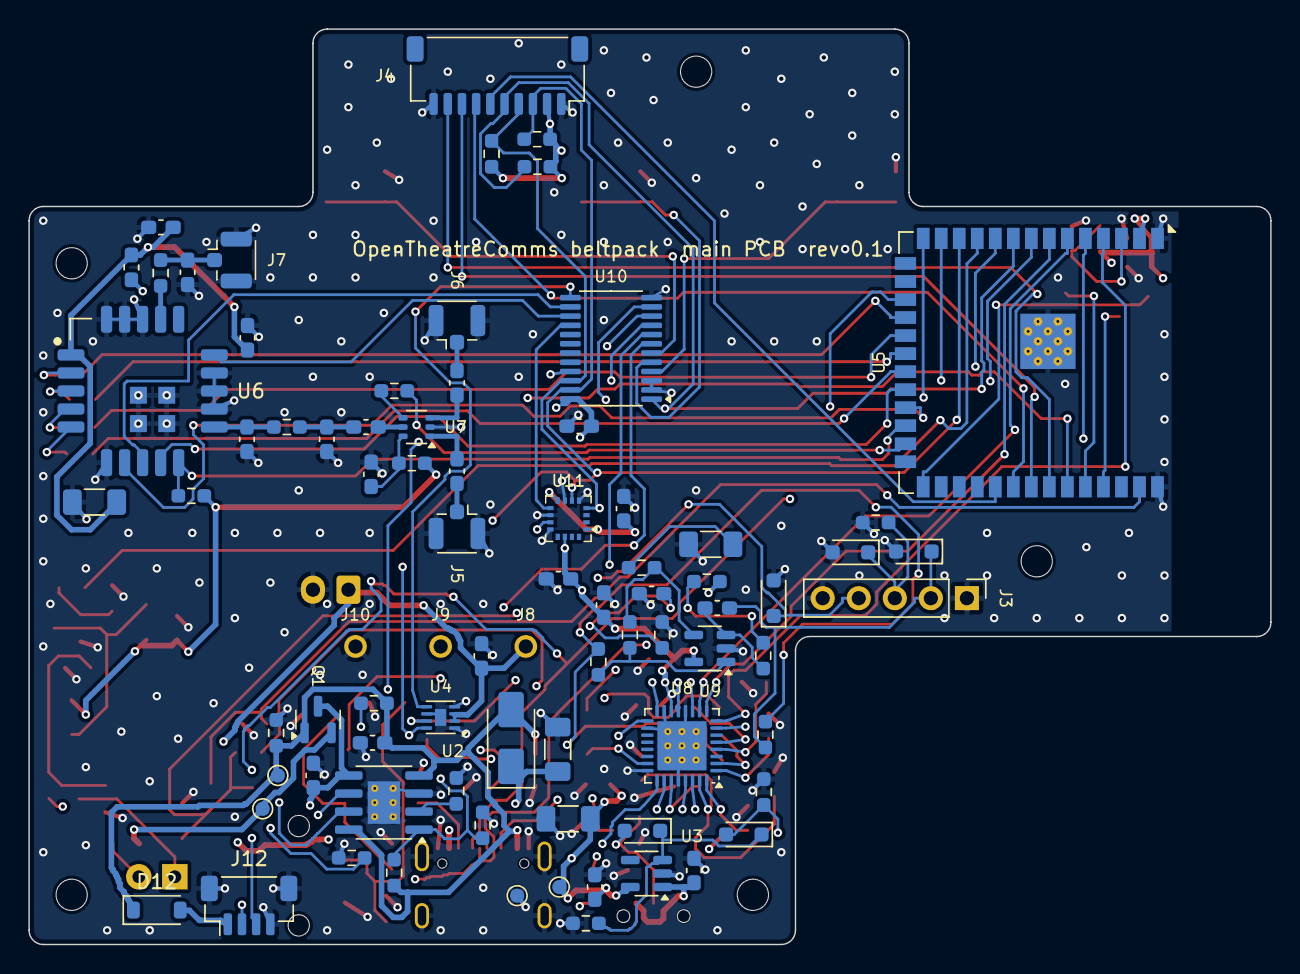
[picture p72: board main_pcb.kicad_pcb from below]

Board: 4 copper layers, 87.5 x 64.5 mm, 145 parts (80 on the bottom side), 98 nets.
