DefeatedWarrior/OpenTheatreComms-Beltpack/kicad/pack_lid_pcb/pack_lid_pcb.kicad_pcb

## KiCad design kicad/pack_lid_pcb/pack_lid_pcb.kicad_pcb (2026-10-31)

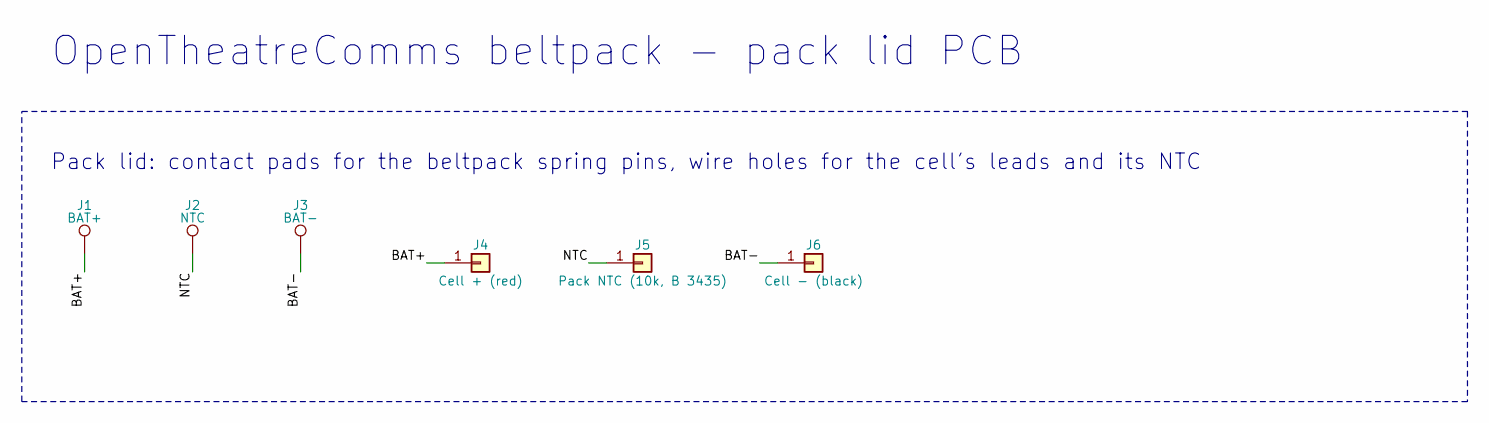
[picture p73: schematic pack_lid_pcb.kicad_sch, Beltpack pack lid PCB]

Parts:
J1: BAT+; TestPoint_Pad_D3.0mm; MPN PCB pad (ENIG)
J2: NTC; TestPoint_Pad_D3.0mm; MPN PCB pad (ENIG)
J3: BAT-; TestPoint_Pad_D3.0mm; MPN PCB pad (ENIG)
J4: Cell + (red); SolderWire-0.25sqmm_1x01_D0.65mm_OD1.7mm; MPN Wire, 0.25 mm2 (24 AWG)
J5: Pack NTC (10k, B 3435); SolderWire-0.25sqmm_1x01_D0.65mm_OD1.7mm; MPN Wire, 0.25 mm2 (24 AWG)
J6: Cell - (black); SolderWire-0.25sqmm_1x01_D0.65mm_OD1.7mm; MPN Wire, 0.25 mm2 (24 AWG)

Connections:
BAT+: J1.1, J4.1
BAT-: J3.1, J6.1
NTC: J2.1, J5.1

Notes on the sheet:
Pack lid: contact pads for the beltpack spring pins, wire holes for the cell's leads and its NTC
OpenTheatreComms beltpack - pack lid PCB

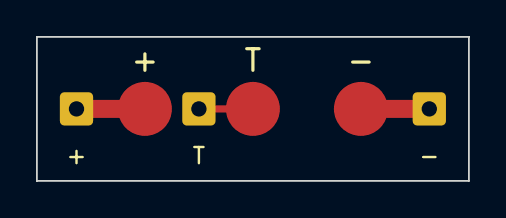
[picture p74: board pack_lid_pcb.kicad_pcb from above]

Board: 2 copper layers, 24.0 x 8.0 mm, 6 parts (0 on the bottom side), 3 nets.
