DefeatedWarrior/OpenTheatreComms-Beltpack/(commit log)

2026-10-25 Beltpack reference model with real part envelopes
    CadQuery model of the OpenTheatreComms beltpack (concept v16 shape) with
    datasheet envelopes for every bought part, a clash check (0 clashes across
    66 parts), STEP/STL/GLB exports, KiCad DXF outlines and drawings for the top
    PCB, main PCB and pack pad board, renders and the three.js viewer.
    Claude-Session: https://claude.ai/code/session_01BHHoEkVWZDzc33CHMCH67Q
    [back_shell.stl, battery_pack.stl, belt_plate.stl, beltpack_final.step, front_back.stl, front_function.stl, front_menu.stl, front_shell.stl]
2026-10-25 Add antenna diversity and KiCad projects
    - Second 915 MHz flex antenna inside the left end, pSemi PE4259 SPDT switch,
    second U.FL and coax; no-copper strip on the main board's left edge
    - Ready-to-open KiCad projects for the top PCB, main PCB and pack pad board:
    outlines, M2 holes, keep-outs, placement guides, enclosure STEP in the 3D
    viewer, and a placement script
    - Updated renders, render sheet, viewer, drawings and placement data
    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
    [beltpack_final.step, enclosure_ref.step, main_pcb.dxf, main_pcb.kicad_pcb, main_pcb.kicad_sch, main_pcb_edge_cuts.dxf, pack_lid_pcb.dxf, pack_lid_pcb.kicad_pcb]
2026-10-31 Finished boards, base station and the v1 order
    - KiCad projects for all four boards, each with a README and fab outputs
    (Gerbers, drill, BOM, placement, schematic PDF, previews); DRC 0 errors,
    0 unconnected:
    - beltpack main board: Xinyangze spring pins in 1.0 mm holes, JST XH
    2-pin battery input (J11) on the front, wired in parallel with the pins
    - beltpack top board: Alps EC11N encoders on the PEC12R footprint
    - pack lid board
    - new base station carrier for the Waveshare ESP32-P4-NANO, with LR2021
    radio, edge SMAs, DC buck, OLED, keys, RGB lights and optional audio
    - pcb/: the generator scripts for each board
    - order/: v1 order for 2 beltpacks + 1 base station, hand-asse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
    [LCSC_cart_hand_parts.csv, LCSC_cart_upload.csv, LR2021_module_elecrow.brd, Other_suppliers.csv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]
2026-10-31 Order: HASL on the main and top boards
    Reflow melts the HASL into each joint, so ENIG only buys a flatter paste
    print on the main board's fine-pitch parts. Keep ENIG on the pack lid,
    whose pads are bare spring contacts. Estimate now about A$425.
    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
2026-10-31 Dock contacts: USB charge and data pads on the beltpack's bottom
    - Main board: J12 (JST SH 4-pin, back face, bottom edge) and D12
    (B5819W) feeding dock VBUS into the pack's VBUS, which also keeps the
    USB-C's 5 V off the exposed pads; D+/D- join the USB-C lines. DRC 0
    errors, 0 unconnected; schematic and board agree on all 504 pads.
    - New dock contact board (pcb/pcb_dock, kicad/dock_contact_pcb): 22 x 10
    mm, 0.8 mm ENIG, four 2.5 mm pads at 4 mm pitch (VBUS, D+, D-, GND) and
    a JST SH socket, cabled pin for pin to J12.
    - Order: dock board, sockets, diode and cable added (about A$445 total);
    EC11N dummy-pin note in the top board README and assembly guide.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
    [LCSC_cart_hand_parts.csv, LCSC_cart_upload.csv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]
2026-10-31 Dock: J12 below the battery pack, side-entry socket on the contact board
    The first J12 (side-entry, mouth down) could not take a plug: the bottom
    wall sat 1.5 mm below it. Now:
    - Main board: J12 is a vertical BM04B on the back face at the bottom edge,
    body wholly below the pack's underside (y -31.3 vs -31), so the plug
    points back into the 5 mm strip under the pack; pins 1 VBUS, 2 D-, 3 D+,
    4 GND. Six lone ground stitching vias made room; TP3 (BAT) gave way and
    the battery net was re-routed. Dock VBUS widened to 0.4 mm. DRC 0
    errors, 0 unconnected; schematic and board agree on all 503 pads.
    - Dock contact board: 22 x 11 mm, side-entry SM04B (2.9 mm) with its
    mouth at the edge fa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
    [LCSC_cart_hand_parts.csv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]
2026-10-31 Base station: remove the audio section
    The operator's headset is now a beltpack plugged into the base by USB-C,
    so the NAU88C22 codec, the XLR-4 headset and 4-wire pads and their 38
    parts come off the base board. Their tracks and the I2S / headset-sense
    lines are gone; the rest of the board is unchanged. DRC 0 errors, 0
    unconnected; schematic and board agree.
    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
    [base_pcb-B_Cu.gbl, base_pcb-B_Mask.gbs, base_pcb-B_Paste.gbp, base_pcb-B_Silkscreen.gbo, base_pcb-Edge_Cuts.gm1, base_pcb-F_Cu.gtl, base_pcb-F_Mask.gts, base_pcb-F_Paste.gtp]
2026-10-31 Order: full buy lists (JLC boards, LCSC cart, other suppliers) with the audio-free base station
    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
    [JLC_boards.csv, Other_suppliers.csv]
2026-10-31 Base station: 1:1 print for the NANO socket check; order README points to it
    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
2026-10-31 Beltpack top: solder pads for the OLED panel's 0.7 mm tail instead of the 0.5 mm ZIF
    The 1.3 in 30-pin SH1106 panels sold cheaply end in a 0.7 mm pitch solder tail, which the
    Hirose FH12 (0.5 mm ZIF) could not take. J2 is now 30 pads on B at 0.7 mm, the OLED caps
    moved to match, the board re-routed (DRC clean), and the order updated: FH12 off the LCSC
    cart, the panel listing on the AliExpress list, an iron-only OLED soldering step.
    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
    [LCSC_cart_hand_parts.csv, LCSC_cart_upload.csv, Other_suppliers.csv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]
2026-10-31 Order README: board files folder renamed
    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
2026-10-31 Order: three frameless 380 x 280 stencils, both sides on one sheet
    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
    [JLC_boards.csv]
2026-10-31 Base station: 2 layers, plus footprints for radios 2 and 3
    At 150 x 90 mm a 4-layer board misses JLC's cheap 4-layer price and adds a setup fee, and
    without the audio section the base fits on 2 layers. Re-placed and re-routed: RF lines are
    now 1.3 mm grounded coplanar waveguide with via fences (necked to 0.3 mm at the PE4259 pins).
    Radios 2 and 3 (U10, U11) are unfitted footprints, each with supply parts, a pi match, DC
    block and its own rear SMA (J6, J7). They share SPI; NSS/BUSY/DIO6 use GPIO46/47/48 and
    GPIO33/27/2, and NRESET/DIO5/TXRX_EN use expander P12-P17. The antenna switch control moved
    from GPIO2 to expander P07. DRC: 0 errors, 0 unconnected.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
    [JLC_boards.csv, LCSC_cart_hand_parts.csv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]
2026-11-01 Order: leaded HASL on every board as ordered; Sn63/Pb37 paste for both sides
    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
    [JLC_boards.csv]
2026-11-08 Order: three LCSC parts raised to their new minimum order (stock rechecked 8 Nov)
    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
    [LCSC_cart_hand_parts.csv, LCSC_cart_upload.csv]
2026-11-08 Schematic review: OLED pump caps 1 uF and IREF 560k per the panel reference; R5 and option-pad notes
    ERC and schematic/PCB parity pass on all five boards. The 1.3 in SH1106 panel reference
    circuit uses 1 uF flying caps and a 560k IREF resistor (12.5 uA max); the top board now
    matches (same 0603 footprints, Gerbers unchanged). Order README: fit R5 for cells without
    an NTC; check R26/R29 option pads for paste bridges.
    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
    [LCSC_cart_hand_parts.csv, LCSC_cart_upload.csv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]
2026-11-11 Top PCB: six RGB lights on a TI LP5024 I2C driver
    Replace the single-colour key and status LEDs with Lite-On LTST-C19HE1WT
    RGB LEDs driven by an LP5024 (0x28). OLED moves to 0x3D, clear of the
    driver's broadcast address. Driver EN on expander P05. Top stencil 0.10 mm
    for the 0.4 mm QFN. Order files and LCSC cart updated.
    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
    [JLC_boards.csv, LCSC_cart_hand_parts.csv, LCSC_cart_upload.csv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]
2026-11-11 Order: add the 10-pin JST SH link cable (main J4 to top J1)
    It was on the schematic but missing from the buy list.
    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
    [Other_suppliers.csv]
2026-11-11 Docs: bring the READMEs up to date for the v1 order
    KiCad index lists all five finished boards; base station is 2 layers; total
    about A$410; HX4259 switch; pack lid and dock boards on leaded HASL; top
    board README covers the RGB lights; OLED pin 1 side confirmed.
    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
2026-11-11 Main PCB README: OLED at 0x3D, LP5024 at 0x28
    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
